nicolaibonde/Boat-autopilot-documentation/README.md

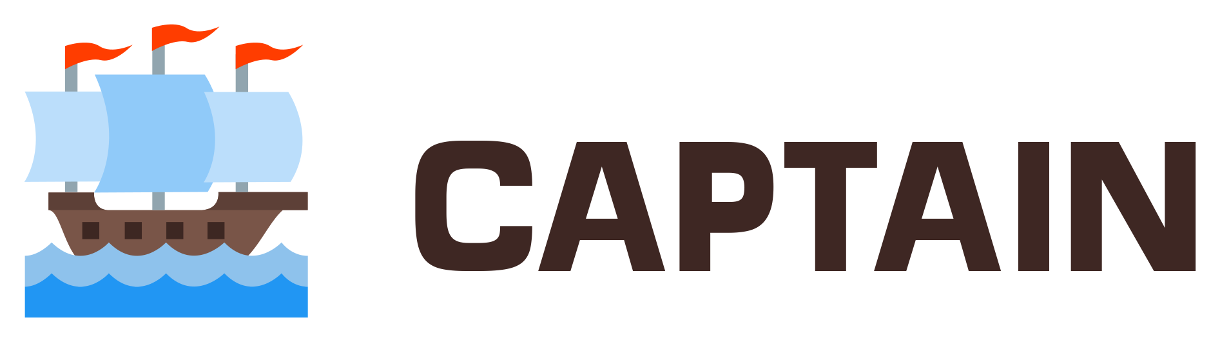
[picture p1: logo - side.png]


This is the documentation for CAPTAIN a boat autopilot and navigation system.

The source code for this project can be found in an [Boat-autopilot](https://github.com/neobonde/Boat-autopilot)

This repository is part of a Bachelors project in electrical engineering at Aarhus University - Department of Engineering

[logo]: https://github.com/neobonde/Boat-autopilot-documentation/blob/master/logo%20-%20side.png "Logo Title Text 2"
