nicolaibonde/Boat-autopilot-documentation/Appendix/Project/README.md

# Boat-autopilot-documentation - Appendix - Project

This includes the following according to "Vejledning til udfærdigelse af projektrapporter - version 1.2":

* Requirementspecification
* Analysis
* Architecture
* Design
* Test
  * Module tests
  * Intergration tests
  * Acceptance test
  
* Datasheets
* PCB Layouts
* Doxygen generated source code documentation
* Source code
* logbook

Some of the documents might not be pressent if we did not use them
