nicolaibonde/Boat-autopilot-documentation/Report/Frontpage.tex

\begin{titlingpage}
%\thispagestyle{title}
\selectlanguage{danish}
		
	\begin{center}
			{\huge\bfseries Bachelor Project - CAPTAIN}\\
			\vspace{20pt}
			{\large Autonomous surveying vessel with autopilot, navigational\\ algorithms, GPS, and website user interface, using C++11, \\ Boost, AngularJS, JavaScript, and with extensive unit testing.}\\
			
			\vfill
			\begin{figure}[H]
				\centering
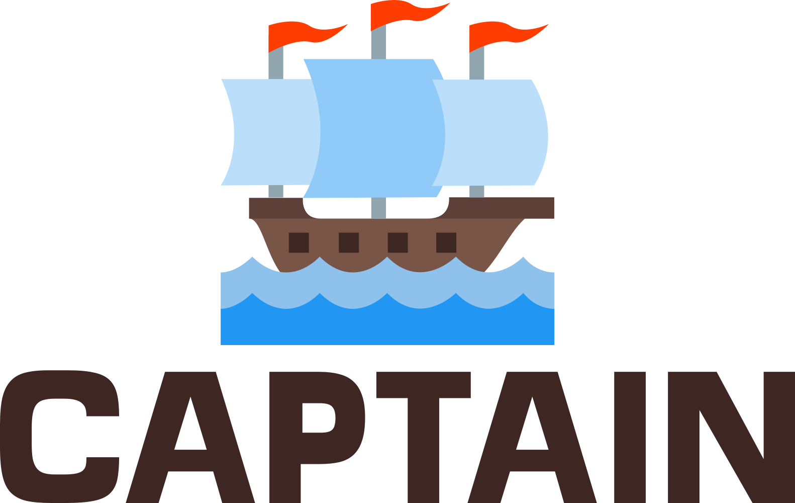
[picture p31: Report/forside.png]
				
			\end{figure}
			
			\vfill
			{\Huge\bfseries Report}\\

			\vspace{20pt}
			
			{Bachelor - Electronics Engineering}\\
			{\large 7. Semester project Fall 2017}\\
			{Group: 17115}\\
			{Keystrokes: 48,522}
			
			\vspace{10pt}
			
			Aarhus University, School of Engineering\\
			Supervisor : Michael Alrøe
			\vspace{10pt}
			
			19. December 2017
	
			\begin{minipage}{0.40\linewidth}
				\centering
							
				\hrule
				\vspace{12pt}
				Nicolai Kaasgaard Bonde\\
				Studienr. 201405146\\
				AU ID: au512366
			\end{minipage}
			\hspace{50pt}
			\begin{minipage}{0.40\linewidth}
				\centering
					
				\hrule
				\vspace{12pt}
				Troels Ringbøl Brahe\\
				Studienr. 20095221\\
				AU ID: au283169
			\end{minipage}
	\end{center}
\end{titlingpage}
