nicolaibonde/Boat-autopilot-documentation/Appendix/Process/process.tex

%%%% Bachelor projekt dokumentation/rapport gruppe x %%%%
%%%% Efterår 2017 %%%%

% Kan anvendes til journaler eller afleveringer
\input{preamble}

\bibliography{../../bibliography.bib}

\begin{document}

	\selectlanguage{english}
	
	\input{frontpage}
	
	\setcounter{tocdepth}{1}
	\begin{KeepFromToc}
		\tableofcontents
	\end{KeepFromToc}\pagebreak

	\input{Preface}
	
	\input{Introduction}
	
	\input{Group_formation}
	
	\input{Cooperation_agreement}
	
	\input{development_process}
	
	\input{Project_management}
	
	\input{Work_distribution}
	
	\input{Planning}

	\input{Project_administration}

	\input{Meetings}
	
	\input{Conflict_handeling}

	\printbibliography[title={Bibliography}]
	
	%\include{<sti/filnavn>}

\end{document}
