nicolaibonde/Boat-autopilot-documentation/Appendix/Process/Project_management.tex

%Her beskrives hvordan projektledelse er anvendt under projektets gennemførelse. Har det være samme person der har været projektleder gennem hele projektforløbet – eller er projektledelse foregået på skift – eller kollektivt? Beskriv også hvis der ikke har været anvendt nogen form for projektledelse. Hvis I har anvendt Scrum kan jeres anvendelse af rollerne Product Owner (PO) og Scrum Master (SM) beskrives her.
\chapter{Project management}
Management of project development was shared between the two group members.

After the initial stages of problem definition, requirements specification, and architecture, the design tasks were broken down and each member started developing more or less independently until next review/completion cycle.

The team figured out which tasks seemed most relevant continually, and delegated the work based mostly on this to ensure that work could progress at a steady pace.
