nicolaibonde/Boat-autopilot-documentation/Appendix/Project/Dokumentation/dokumentation.tex

%%%% Bachelor projekt dokumentation/rapport gruppe x %%%%
%%%% Efterår 2017 %%%%

% Kan anvendes til journaler eller afleveringer
\input{preamble}

\bibliography{../../../bibliography.bib}
\begin{document}

	\selectlanguage{english}
	
	\input{frontpage}
	
	\setcounter{tocdepth}{3}
	\begin{KeepFromToc}
		\tableofcontents
	\end{KeepFromToc}\pagebreak
	
	\input{Introduction}
	
	\newpage
	\input{Requirements_specification}
	
	\newpage
	\input{Acceptance_test}
	
	\input{Analysis}
	
	\newpage	
	\input{System_architecture}
	
	\newpage
	\input{Design_implementation_and_test}
	
	\newpage
	\input{Integrationtest}
	
	\newpage
	\input{Acceptance_test_results}	
	
	\newpage
	
	\printbibliography[title={Bibliography}]
	
	%\include{<sti/filnavn>}

\end{document}
