nicolaibonde/Boat-autopilot-documentation/Appendix/Project/Dokumentation/Images/Design/Motor_config.pdf

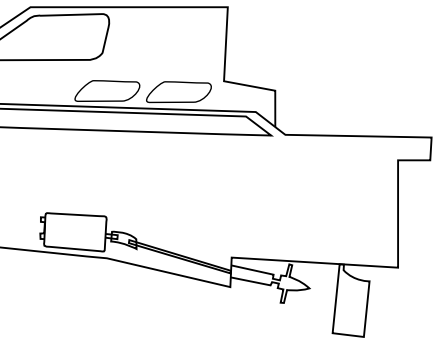
[picture p36: figure]
