nicolaibonde/Boat-autopilot-documentation/Appendix/Project/Dokumentation/Images/Implementation/xte.pdf

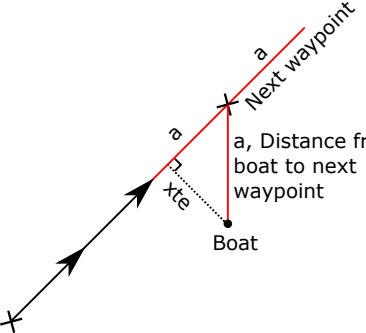
[picture p37: figure]
Boat; xte; boat to next waypoint; Next waypoint

a, Distance from
