nicolaibonde/Boat-autopilot-documentation/Appendix/Project/Dokumentation/forside.png

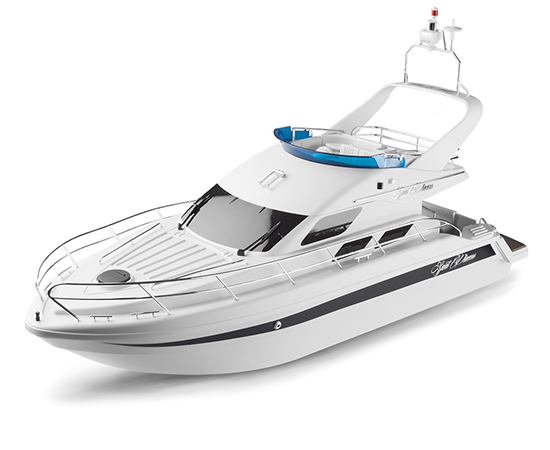
Appendix/Project/Dokumentation/forside.png
