nicolaibonde/Boat-autopilot-documentation/Appendix/Project/Dokumentation/Images/Implementation/boat_harware_enclosed_2.jpg

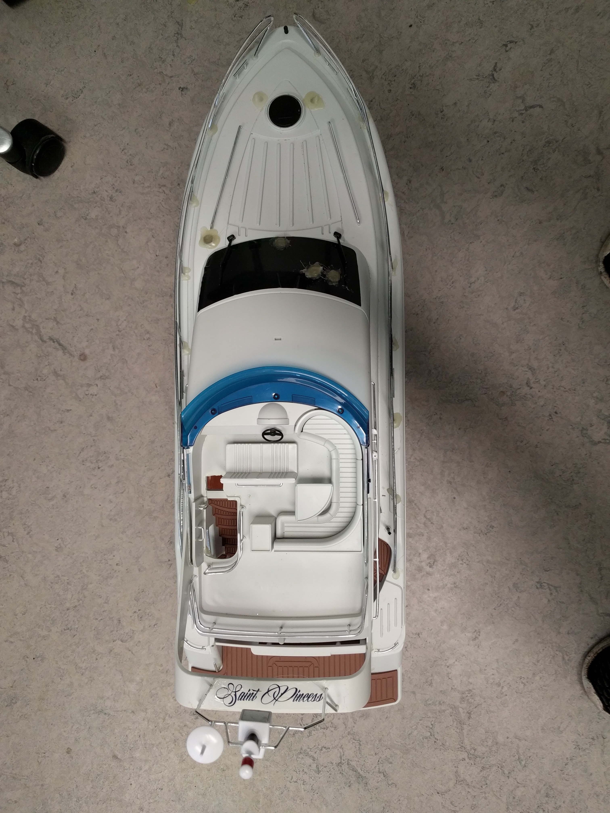
Appendix/Project/Dokumentation/Images/Implementation/boat_harware_enclosed_2.jpg
