nicolaibonde/Boat-autopilot-documentation/Appendix/Project/Dokumentation/Images/Implementation/gps_output_pi.png

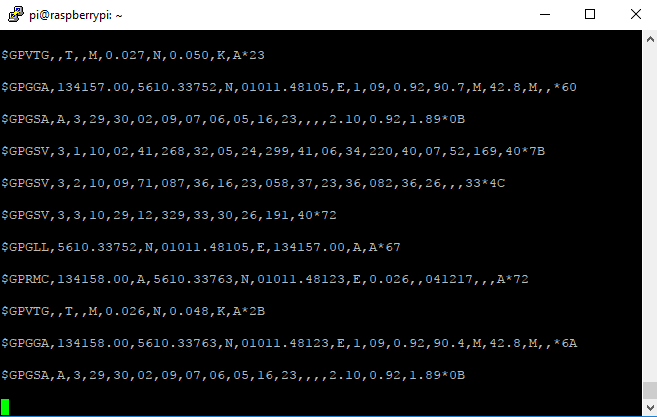
Appendix/Project/Dokumentation/Images/Implementation/gps_output_pi.png
