nicolaibonde/Boat-autopilot-documentation/Appendix/Project/Dokumentation/Images/Implementation/Motor_controller_bow.jpg

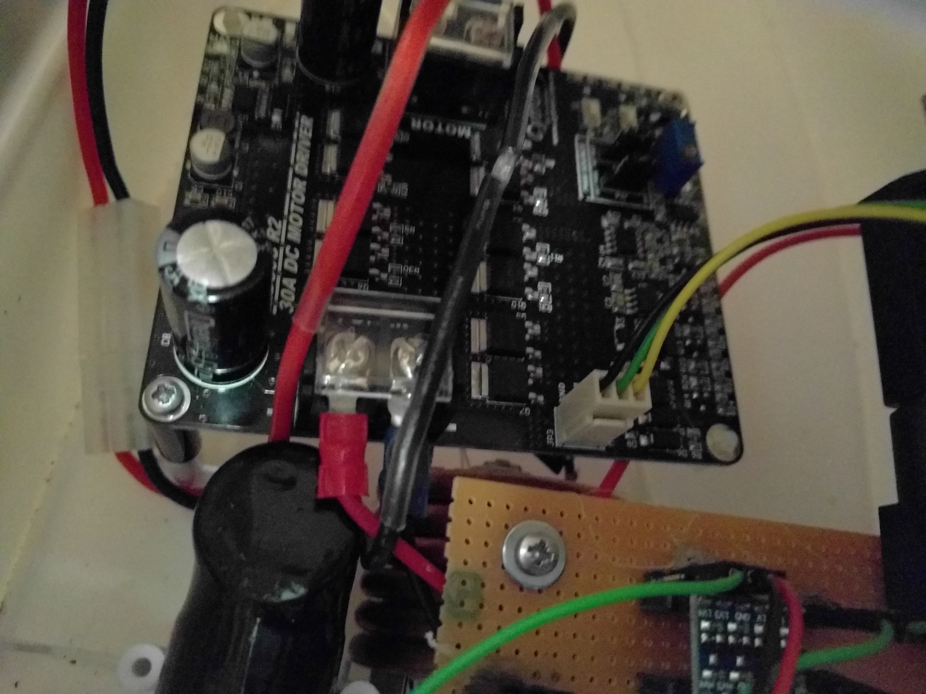
Appendix/Project/Dokumentation/Images/Implementation/Motor_controller_bow.jpg
