nicolaibonde/Boat-autopilot-documentation/Appendix/Project/Dokumentation/Images/Implementation/perfboard_middle.jpg

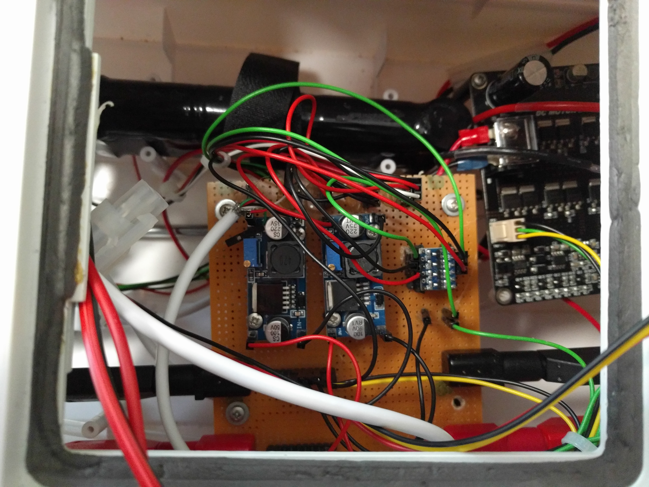
Appendix/Project/Dokumentation/Images/Implementation/perfboard_middle.jpg
