nicolaibonde/Boat-autopilot-documentation/Appendix/Project/Dokumentation/Images/Implementation/Raspberry_pi_stern.jpg

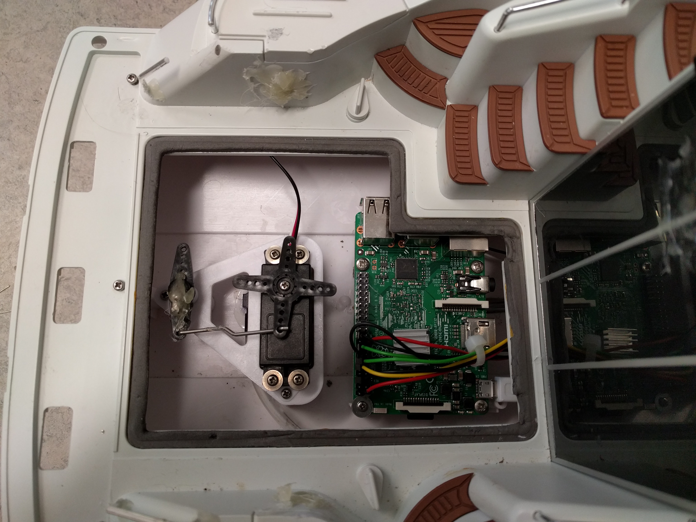
Appendix/Project/Dokumentation/Images/Implementation/Raspberry_pi_stern.jpg
