nicolaibonde/Boat-autopilot-documentation/Appendix/Project/Dokumentation/Images/Implementation/status_page.png

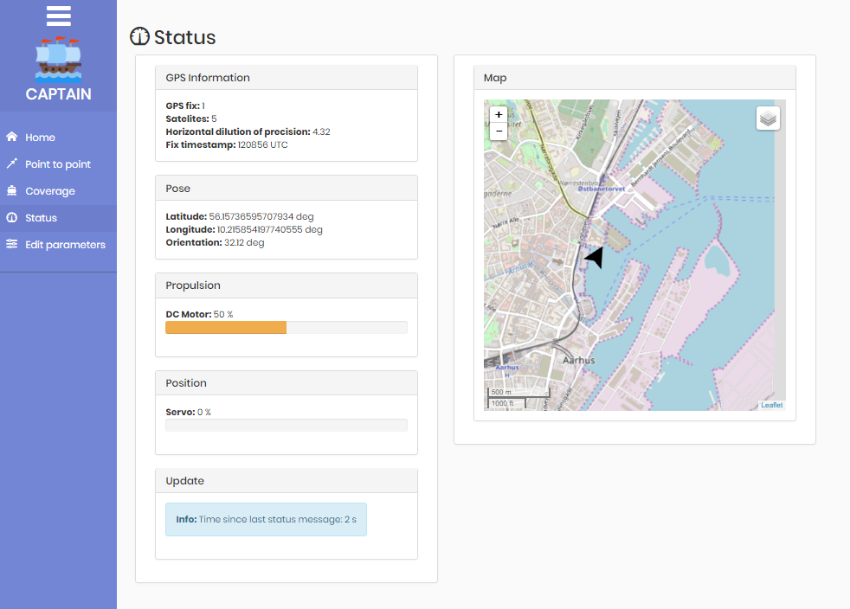
Appendix/Project/Dokumentation/Images/Implementation/status_page.png
