nicolaibonde/Boat-autopilot-documentation/Appendix/Project/Dokumentation/Images/Integration/edit_param.png

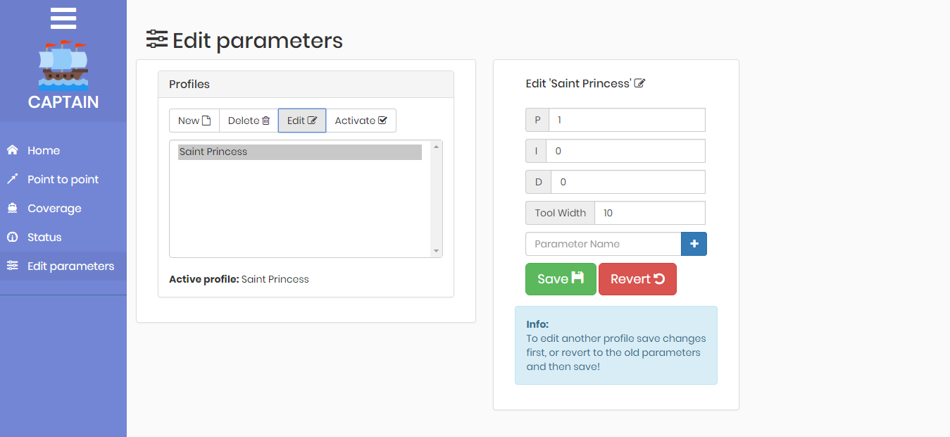
Appendix/Project/Dokumentation/Images/Integration/edit_param.png
