nicolaibonde/Boat-autopilot-documentation/Appendix/Project/Research/HardwareIntegration/both_regulators_on.jpg

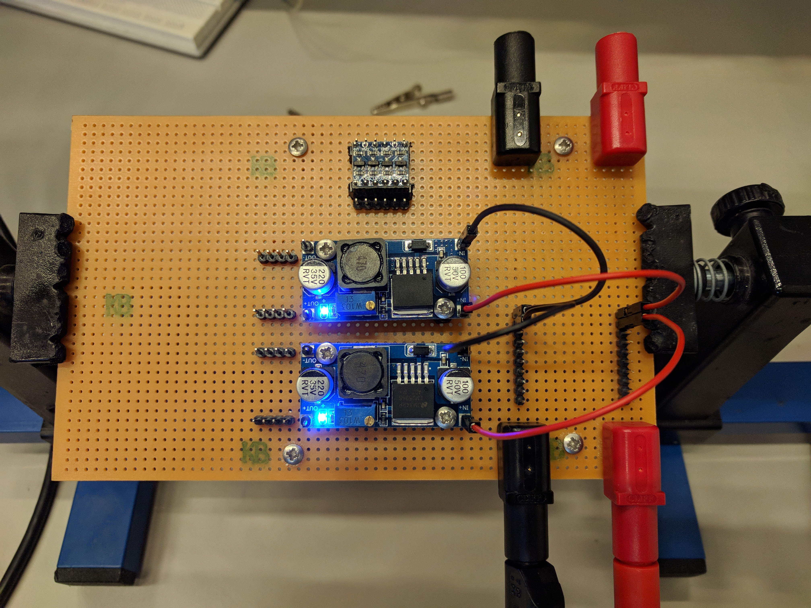
Appendix/Project/Research/HardwareIntegration/both_regulators_on.jpg
