nicolaibonde/Boat-autopilot-documentation/Appendix/Project/Research/HardwareIntegration/full_system_no_load_current.jpg

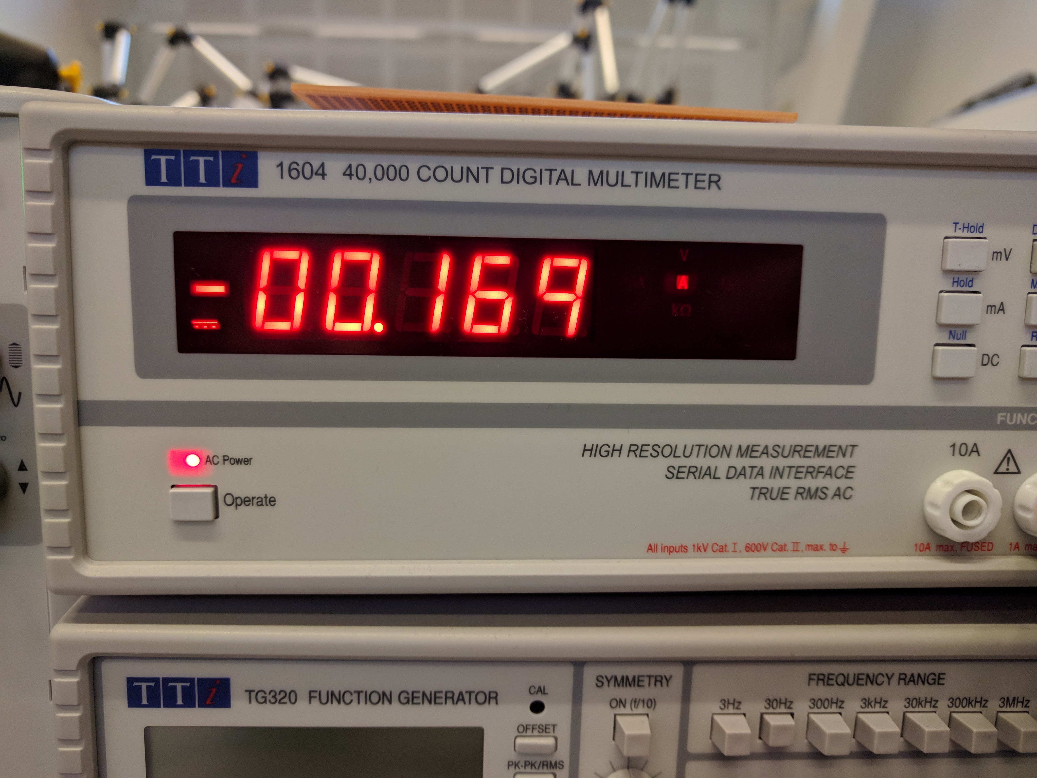
Appendix/Project/Research/HardwareIntegration/full_system_no_load_current.jpg
