nicolaibonde/Boat-autopilot-documentation/Appendix/Project/Research/HardwareIntegration/full_system_no_load_voltage_current.jpg

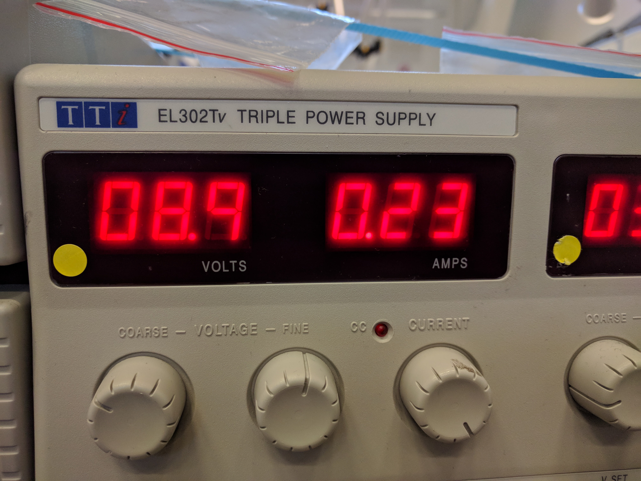
Appendix/Project/Research/HardwareIntegration/full_system_no_load_voltage_current.jpg
