nicolaibonde/Boat-autopilot-documentation/Appendix/Project/Research/HardwareIntegration/motor_contoller_no_load_current.jpg

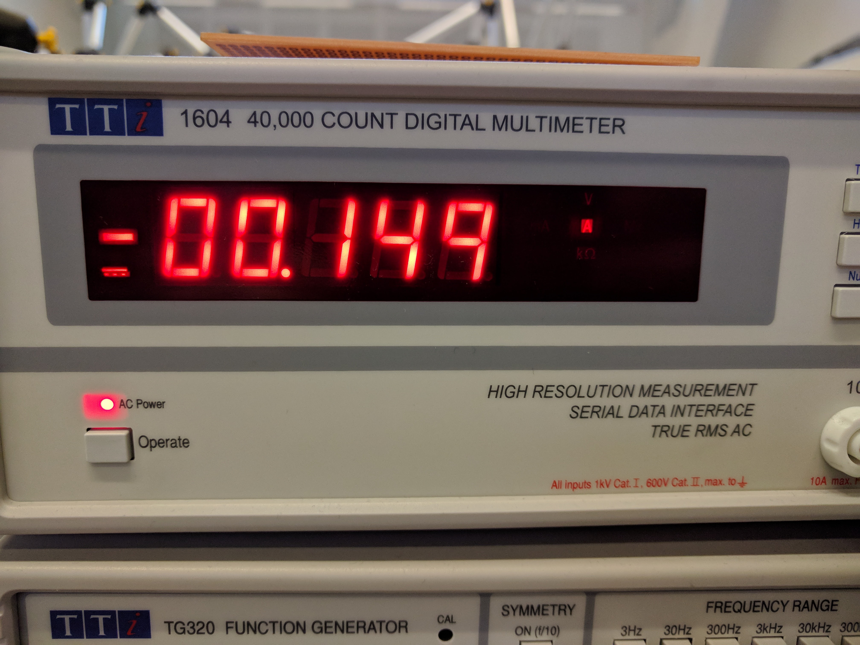
Appendix/Project/Research/HardwareIntegration/motor_contoller_no_load_current.jpg
