nicolaibonde/Boat-autopilot-documentation/Appendix/Project/Research/HardwareIntegration/motor_controller_no_load_10.png

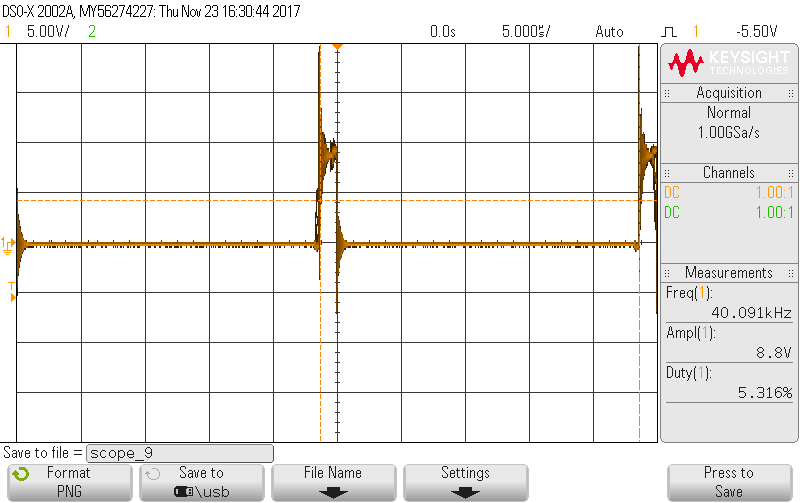
Appendix/Project/Research/HardwareIntegration/motor_controller_no_load_10.png
