nicolaibonde/Boat-autopilot-documentation/Appendix/Project/Research/HardwareIntegration/motor_controller_no_load_90.png

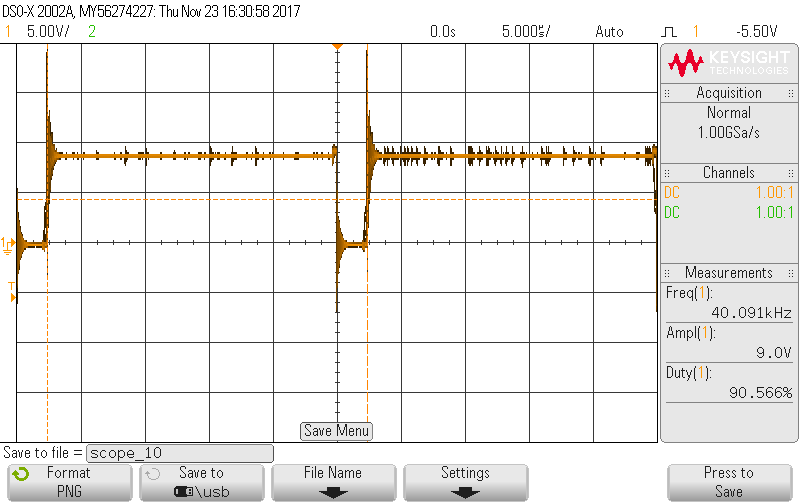
Appendix/Project/Research/HardwareIntegration/motor_controller_no_load_90.png
