nicolaibonde/Boat-autopilot-documentation/Appendix/Project/Research/HardwareIntegration/motor_controller_overshoot_2.png

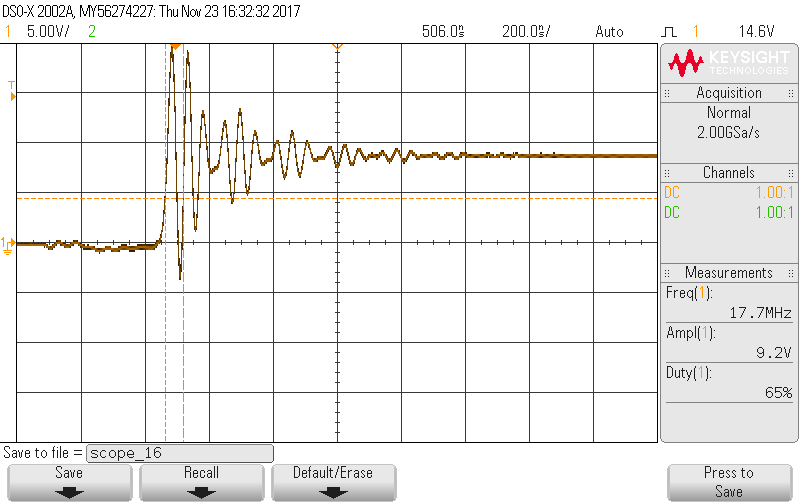
Appendix/Project/Research/HardwareIntegration/motor_controller_overshoot_2.png
