nicolaibonde/Boat-autopilot-documentation/Appendix/Project/Research/HardwareIntegration/motor_controller_pwm_current_draw.jpg

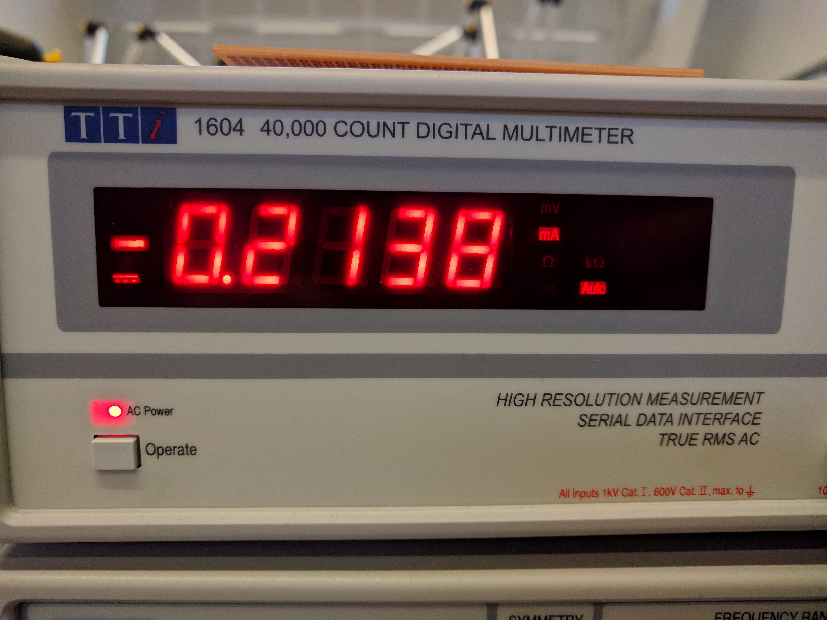
Appendix/Project/Research/HardwareIntegration/motor_controller_pwm_current_draw.jpg
