nicolaibonde/Boat-autopilot-documentation/Appendix/Project/Research/HardwareIntegration/regulator_5v_off.png

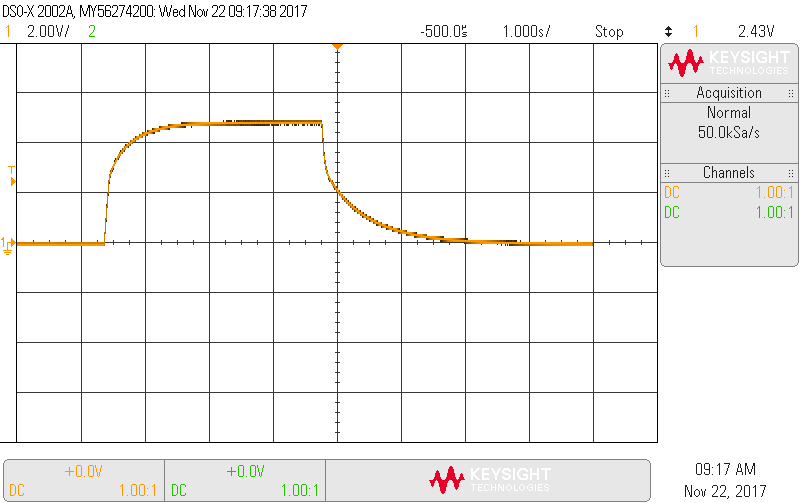
Appendix/Project/Research/HardwareIntegration/regulator_5v_off.png
