nicolaibonde/Boat-autopilot-documentation/Appendix/Project/Research/HardwareIntegration/regulator_5v_off_2.png

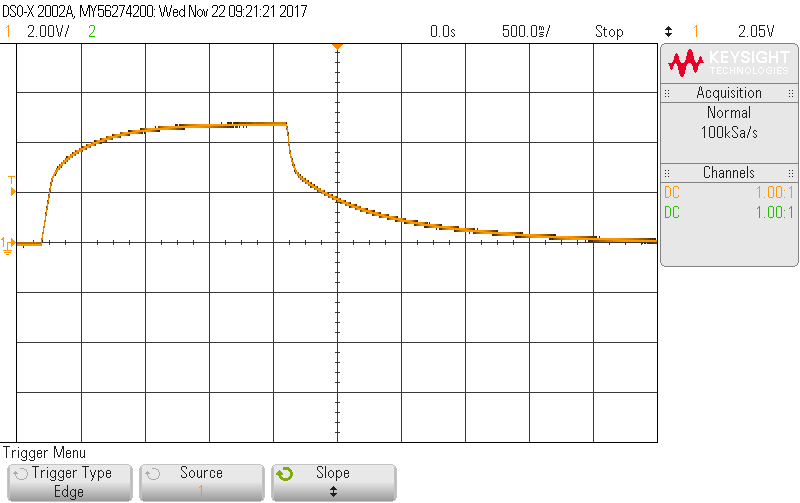
Appendix/Project/Research/HardwareIntegration/regulator_5v_off_2.png
