nicolaibonde/Boat-autopilot-documentation/Appendix/Project/Research/HardwareIntegration/regulator_5v_on.png

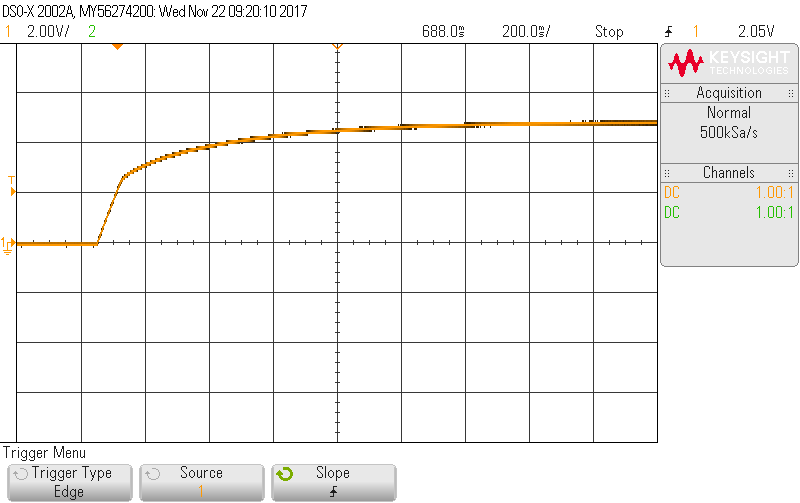
Appendix/Project/Research/HardwareIntegration/regulator_5v_on.png
