nicolaibonde/Boat-autopilot-documentation/Appendix/Project/Research/HardwareIntegration/regulator_both_current_draw.jpg

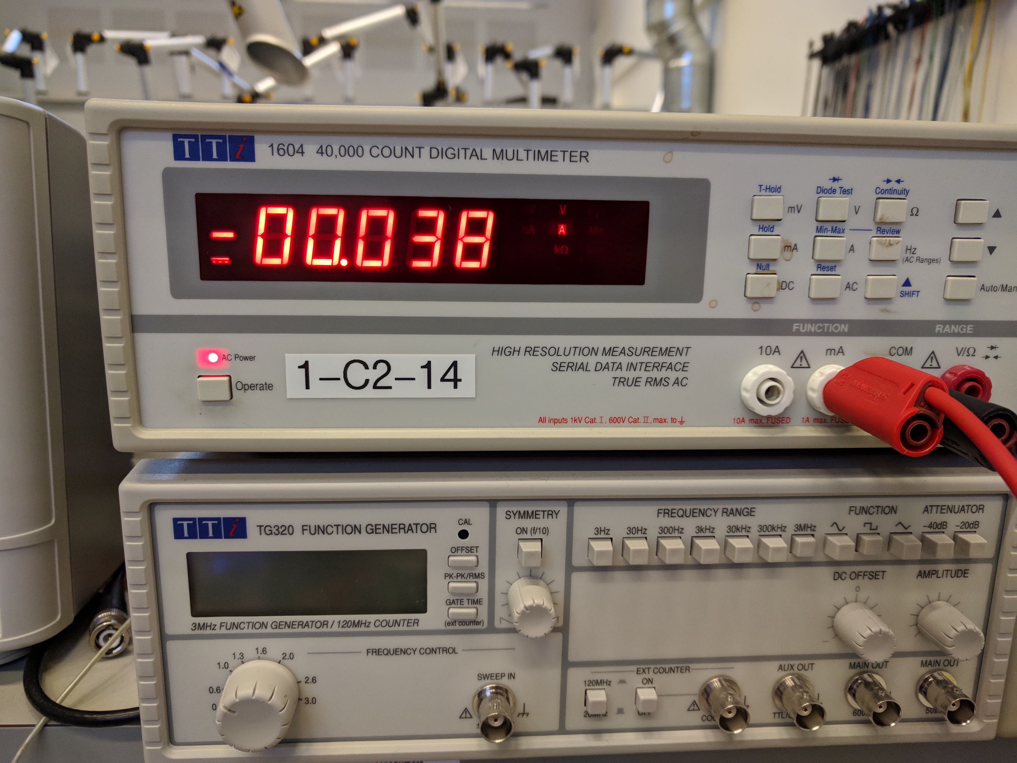
Appendix/Project/Research/HardwareIntegration/regulator_both_current_draw.jpg
