nicolaibonde/Boat-autopilot-documentation/Appendix/Project/Research/HardwareIntegration/regulator_voltage_current_input.jpg

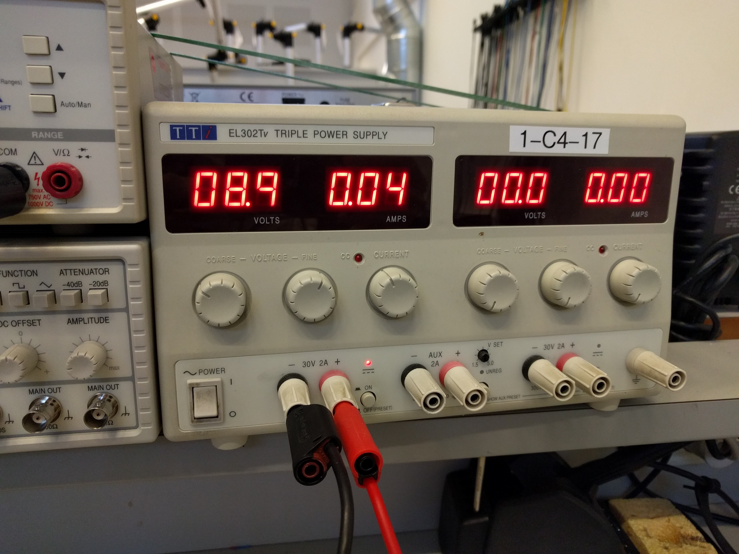
Appendix/Project/Research/HardwareIntegration/regulator_voltage_current_input.jpg
