nicolaibonde/Boat-autopilot-documentation/Appendix/Project/Research/HardwareIntegration/scope_13.png

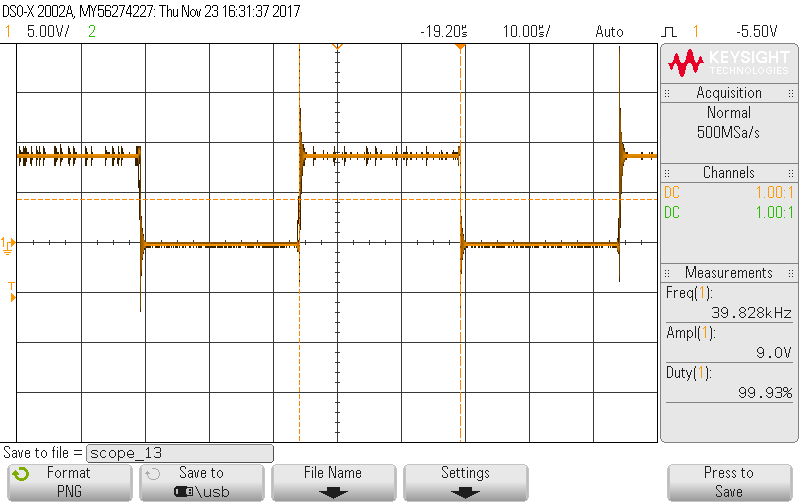
Appendix/Project/Research/HardwareIntegration/scope_13.png
