nicolaibonde/Boat-autopilot-documentation/Appendix/Project/Research/Board_candidates/Board_candidates.xlsx

 |  | Weights: -> | 3 | 2 | 5 | 3 | 3 | 2 | 4 | 2 | 1 | 5 | 1 | 4
Names | Score | Processor | Price (DKK) | RAM | RTOS | WiFi module | UART | SPI | PWM | I2C | Supply | Ethernet port | GPIO | SupportLvl | Ref
Raspberry Pi 3b | 161.969697 | 1.2 GHz BCM2837 | 220 | 2048 | Yes | Yes | Yes | Yes | Yes | Yes | 5 | Yes | 40 | 5 | https://www.raspberrypi.org/
PineA64+ | 150.9166667 | 1.2 GHz ARM A53 | 180 | 2048 | Yes | Yes | Yes | Yes | Yes | Yes | 5 | Yes | 20 | 2 | https://www.pine64.org/?page_id=1194
Asus Tinker Board | 150.9015152 | 1.8 GHz ARM A17 | 440 | 2048 | Yes | Yes | Yes | Yes | Yes | Yes | 5 | Yes | 40 | 3 | https://www.asus.com/uk/Single-Board-Computer/Tinker-Board/specifications/
BeagleBone Black w | 147.7442529 | 1 GHz ARM A8 | 580 | 512 | Yes | Yes | Yes | Yes | Yes | Yes | 5 | Yes | 92 | 4 | https://beagleboard.org/black-wireless
NanoPC-T3 | 147.4821429 | 1.4 GHz ARM A53 | 350 | 2048 | Yes | Yes | Yes | Yes | Yes | Yes | 5 | Yes | 30 | 2 | http://www.friendlyarm.com/index.php?route=product/product&product_id=123
OrangePi Plus 2 | 144.3333333 | 1.6 GHz ARM A7 | 300 | 2048 | Yes | Yes | Yes | Yes | Yes | Yes | 5 | Yes | 40 | 1 | http://www.orangepi.org/orangepiplus2/
Raspberry Pi Zero w | 143.3333333 | 1 GHz BCM2835 | 90 | 512 | Yes | Yes | Yes | Yes | Yes | Yes | 5 | No | 40 | 5 | https://www.raspberrypi.org/
Banana Pi | 141.5 | 1.8 GHz ARM A7-A83T | 810 | 2048 | Yes | Yes | Yes | Yes | Yes | Yes | 5 | Yes | 40 | 1 | http://www.banana-pi.org/m3.html
Udoo Quad | 141.1904762 | 1 GHz NXP i.MX6Q + Atmel SAM3X8E | 840 | 1024 | Yes | Yes | Yes | Yes | Yes | Yes | 5 | Yes | 76 | 2 | https://shop.udoo.org/eu/quad-dual/udoo-quad.html
BeagleBoard X15 | 140.9060403 | 1.5 GHz ARM A15 | 1490 | 2048 | Yes | No | Yes | Yes | Yes | Yes | 12 | Yes | 240 | 4 | https://beagleboard.org/x15
NanoPi 2 Fire | 136.4761905 | 1.4 GHz ARM A9 | 140 | 1024 | Yes | No | Yes | Yes | Yes | Yes | 5 | Yes | 40 | 2 | http://nanopi.io/nanopi2-fire.html
Intel Edison | 129.8267544 | 0.5 GHz Intel Atom | 570 | 1024 | Yes | Yes | Yes | Yes | Yes | Yes | 5 | No | 70 | 4 | https://software.intel.com/en-us/iot/hardware/edison/documentation
C.H.I.P. Pro | 127.1673387 | 1 GHz ARM V7-A | 310 | 256 | Yes | Yes | Yes | Yes | Yes | Yes | 5 | No | 27 | 4 | https://docs.getchip.com/chip_pro_devkit.html
Odroid C2 | 112.4885057 | 1.5 GHz ARM V8 | 290 | 2048 | Yes | No | Yes | No | No | Yes | 5 | Yes | 40 | 2 | http://www.hardkernel.com/main/products/prdt_info.php?g_code=G145457216438&tab_idx=2
Parallella | 112.35 | 0.8 GHz ARM A9 | 1000 | 1024 | Yes | No | Yes | Yes | ? | Yes | 5 | Yes | 48 | 2 | https://www.parallella.org/docs/parallella_manual.pdf
PixiePro | 104.875 | 1 GHz .iMX6Q + ARM A9 | 810 | 2048 | Yes | Yes | Yes | Yes | ? | Yes | 5 | No | 10 | 1 | https://store.treats4geeks.com/index.php/pixiepro-27.html
