nicolaibonde/Boat-autopilot-documentation/Appendix/Project/Research/HardwareIntegration/motor_contoller_no_load_setup_1.jpg

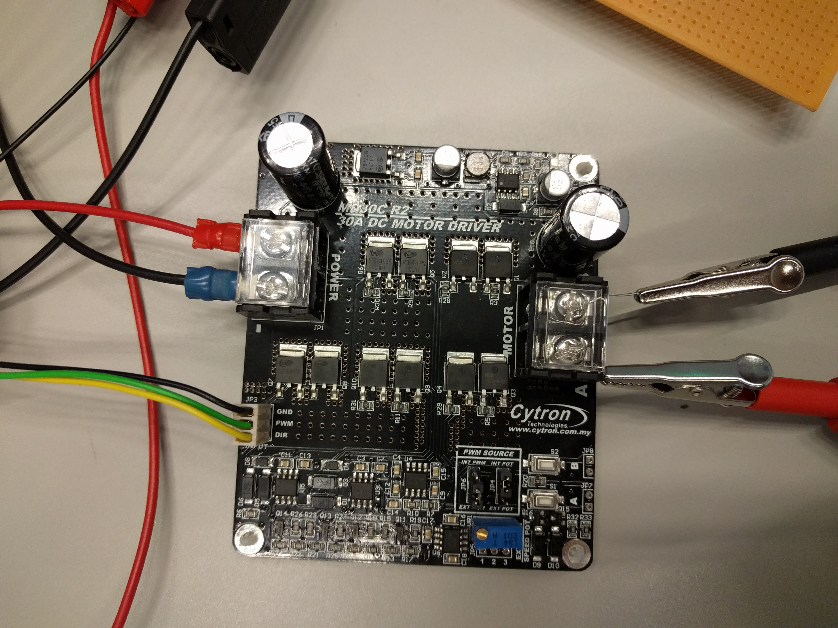
Appendix/Project/Research/HardwareIntegration/motor_contoller_no_load_setup_1.jpg
