nicolaibonde/Boat-autopilot-documentation/Appendix/Project/Research/HardwareIntegration/regulate_voltage_setup_2.jpg

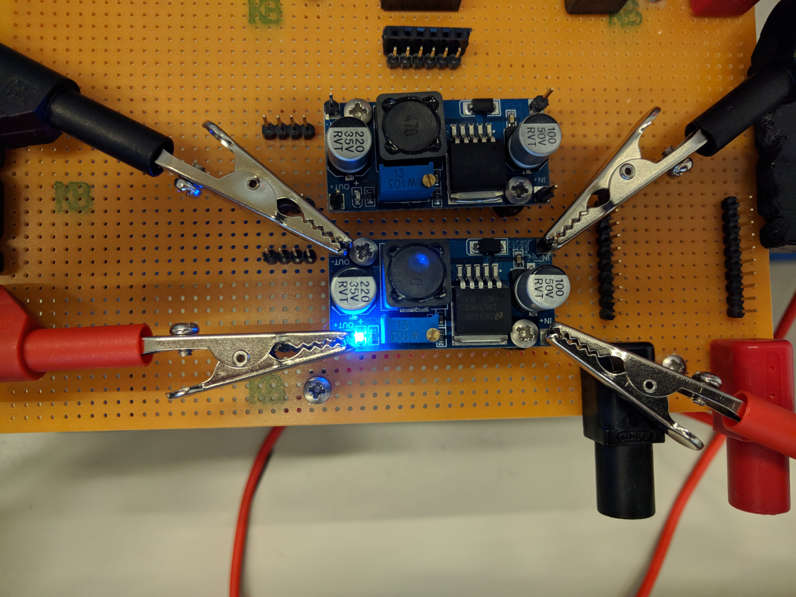
Appendix/Project/Research/HardwareIntegration/regulate_voltage_setup_2.jpg
