nicolaibonde/Boat-autopilot-documentation/Appendix/Project/Research/HardwareIntegration/regulate_voltage_setup_full.jpg

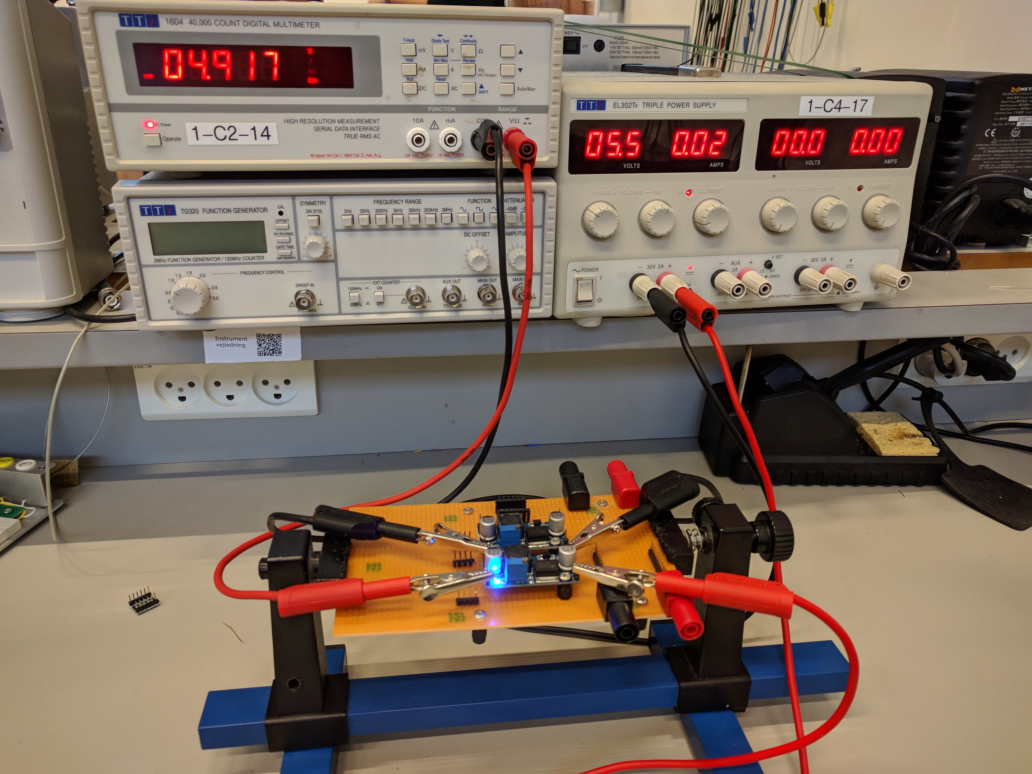
Appendix/Project/Research/HardwareIntegration/regulate_voltage_setup_full.jpg
