nicolaibonde/Boat-autopilot-documentation/Appendix/Project/Research/HardwareIntegration/regulate_votage_setup_1.jpg

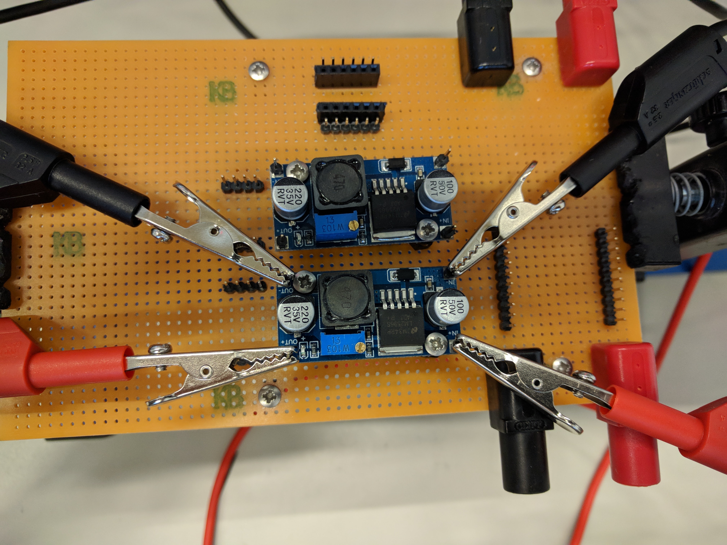
Appendix/Project/Research/HardwareIntegration/regulate_votage_setup_1.jpg
