nicolaibonde/Boat-autopilot-documentation/Appendix/Project/Research/Acceptance_Test_Results/Accepttest_results.xlsx

UC1
Main scenario
1 | Passed | A new profile has been added to the profile list with the name "New Profile". The button is called "New"
UC2
Main scenario
1 | Passed | The selected parameter profile is highlighted
2 | Passed | The selected parameter profile is deleted from the list of profiles. The button is called "Delete"
Active profile deleted
1 | Passed | The selected parameter profile is highlighted
2 | Passed | The selected parameter profile appears in the "Active profile" field under the profile list.
3 | Passed | The selected parameter profile is removed from the profile list, and the "Active profile" shows "None"
UC3
Main scenario
1 | Passed | The selected parameter profile is highlighted
2 | Passed | The selected parameter profile's edit section appears
3 | Passed | The new values correspond to the changes made
4 | Passed | The edit section disappears, and the new values are (presumably) saved
Revert
1 | Passed | The selected parameter profile is highlighted
2 | Passed | The selected parameter profile's edit section appears
3 | Passed | The new values correspond to the changes made
4 | Passed | The values have been reverted to the values they had when the edit section was opened
UC4
Main scenario
1 | Passed | The selected parameter profile is highlighted
2 | Passed | The selected parameter profile appears in the "Active profile" field under the profile list.
UC5
Main scenario
1 | Passed | The menu opens and displays the diagnostics data. The menu is called "Status"
UC6
Main scenario
1 | Passed | A marker appears on the map on the clicked area, and the Latitude and Longitude fields are updated
Coordinate input
1 | Passed | A marker appears on the map on the clicked area, and the Latitude and Longitude fields are updated
UC7
Main scenario
1 | Passed | A marker appears on the map on the clicked area, and the Latitude and Longitude fields are updated
2 | Passed | The button changes to "Calculating..." for a while, then a path is drawn on the map, and the button changes to "Start"
UC8
Main scenario
1 | Passed | A marker appears on the map on the clicked area, and the Latitude and Longitude fields are updated
2 | Passed | The button changes to "Calculating..." for a while, then a path is drawn on the map, and the button changes to "Start"
3 | Passed | The button changes to "Running..." while the path is being traversed, and ETA is updated continually along with the boat's position. The button changes to "Calculate path" when the path has been completed
UC9
Main scenario
1 | Passed | A marker appears on the map on the clicked area, and the Latitude and Longitude fields are updated
2 | Passed | The button changes to "Calculating..." for a while, then a path is drawn on the map, and the button changes to "Start"
3 | Passed | The button changes to "Running..." while the path is being traversed, and ETA is updated continually along with the boat's position
4 | Passed | The button changes to "Calculate path" when stop is pressed, and the motors are stopped. Progress bar turns red, and "Cancelled" is displayed.
UC10
Main scenario
1 | Passed | A marker labeled "1" appears on the map on the clicked area, and the Latitude and Longitude fields are updated
2 | Passed | A marker labeled "2" appears on the map on the clicked area, and the Latitude and Longitude fields are updated
Coordinate input
1 | Passed | A marker labeled "1" appears on the map on the clicked area, and the Latitude and Longitude fields are updated
2 | Passed | A marker labeled "2" appears on the map on the clicked area, and the Latitude and Longitude fields are updated
UC11
Main scenario
1 | Passed | A marker labeled "1" appears on the map on the clicked area, and the Latitude and Longitude fields are updated
2 | Passed | A marker labeled "2" appears on the map on the clicked area, and the Latitude and Longitude fields are updated
3 | Passed | The button changes to "Calculating..." for a while, then a path is drawn on the map, and the button changes to "Start". The coverage area is highlighted in an orange color
UC12
Main scenario
1 | Passed | A marker labeled "1" appears on the map on the clicked area, and the Latitude and Longitude fields are updated
2 | Passed | A marker labeled "2" appears on the map on the clicked area, and the Latitude and Longitude fields are updated
3 | Passed | The button changes to "Calculating..." for a while, then a path is drawn on the map, and the button changes to "Start". The coverage area is highlighted in an orange color
4 | Passed | The button changes to "Running..." while the path is being traversed, and ETA is updated continually along with the boat's position. The button changes to "Calculate path" when the path has been completed
UC13
Main scenario
1 | Passed | A marker labeled "1" appears on the map on the clicked area, and the Latitude and Longitude fields are updated
2 | Passed | A marker labeled "2" appears on the map on the clicked area, and the Latitude and Longitude fields are updated
3 | Passed | The button changes to "Calculating..." for a while, then a path is drawn on the map, and the button changes to "Start". The coverage area is highlighted in an orange color
4 | Passed | The button changes to "Running..." while the path is being traversed, and ETA is updated continually along with the boat's position
5 | Passed | The button changes to "Calculate path" when stop is pressed, and the motors are stopped. Progress bar turns red, and "Cancelled" is displayed.
