nicolaibonde/Boat-autopilot-documentation/Appendix/Project/Dokumentation/Design_implementation_and_test.tex

\chapter{Design, implementation, and test}
\label{sec:implementation}

The following sections describe the system design, how it was implemented, and finally how it was tested. First, the protocols used in the system are explained. Then the hardware is discussed, and finally the software.

\input{Design_implementation_test/protocols.tex}

\input{Design_implementation_test/hardware_design.tex}

\input{Design_implementation_test/hardware_moduletest.tex}

\input{Design_implementation_test/software_design.tex}

\input{Design_implementation_test/software_implementation.tex}

\input{Design_implementation_test/software_unittest.tex}

\input{Design_implementation_test/software_integrationtest.tex}
