nicolaibonde/Boat-autopilot-documentation/Appendix/Project/Dokumentation/Design_implementation_test/protocols.tex

\section{Protocols}
\label{sec:protocols}
This section describes the various protocols used throughout the system. The protocol between server and client is a proprietary protocol defined for this project, it is based on JavaScript Object Notation (JSON) \cite{jsobjectnotation}. The protocol between the system and a GPS receiver is the NMEA 0183 version 2 protocol, the section describes the parts of the protocol that the system is using, but the protocol it self is much bigger. 

\subsection{Communication between server and client}

The server and client communicate using three .json files; toNav.json, fromNav.json, and activeParam.json. As the names suggest, one is used to send data from the client to the server (and from there to the navigation module), and one is used to send data from the server to the client, The last is used to transfer parameters specific to the hardware. The contents of these three files is critical for both sides of the system to function properly, so having a standard format in each one is important. 

\subsubsection{toNav.json}

The file used to transfer data from the client to the server is used to send commands to the navigation module. This could be calculating a new coverage path for an area, telling the boat to stop, or setting the endpoint in the point to point page.
The protocol is based on JSON so any kind of data can be contained within.

\begin{lstlisting}[caption = {Example of the least information in the toNav.json file}, captionpos=b, label={lst:toNavBasic}, language=json,firstnumber=1]
{
	"func_": "none"
}
\end{lstlisting}

The example shown in listing \ref{lst:toNavBasic} demonstrates the least amount of information that can be contained in the toNav.json file. The \texttt{func_} name can hold a string, which is expected to be one of some predefined functions. In the example the string is \texttt{none}.
The functions that can be input are; \texttt{none}, \texttt{calcP2P}, \texttt{calcCoverage}, \texttt{start}, and \texttt{stop}.
If one wants to send a \texttt{calcP2P} it is required that the writer adds a container for a coordinate \texttt{target_position_} as in listing \ref{lst:toNavCalcP2P}. A coordinate is made up of two numbers; one called \texttt{latitude_} and one called \texttt{longitude_}

\newpage

\begin{lstlisting}[caption = {Example of a calcP2P call in the toNav.json}, captionpos=b, label={lst:toNavCalcP2P}, language=json,firstnumber=1]
{
	"func_": "calcP2P",
	"target_position_": {
		"latitude_":56.187317092640775,
		"longitude_":10.18372267484665
	}
}
\end{lstlisting}

the \texttt{calcCoverage} function requires two coordinates that describe a rectangle, and they are given in the format of a \texttt{coverage_rectangle_}, which contains a \texttt{start_coord_} and a \texttt{end_coord_}. These are coordinates as in \texttt{calcP2P}. An example of this can be seen in listing \ref{lst:toNavCalcCoverage}.

\begin{lstlisting}[caption = {Example of a calcCoverage call in the toNav.JSON}, captionpos=b, label={lst:toNavCalcCoverage}, language=json,firstnumber=1]
{
	"func_": "calcCoverage",
	"coverage_rectangle_": {
		"start_coord_": {
			"latitude_": 56.17261819336624,
			"longitude_": 10.191444754600525
		},
		"end_coord": {
			"latitude_": 56.17248978086438,
			"longitude_": 10.191691517829895
		}
	}
}
\end{lstlisting}

\subsubsection{fromNav.json}
\label{sec:protocol_fromNav}
This file is used to transfer data from the server to the client, it could be results from the navigation menu or the information for a status panel. 
The protocol is based on JSON so any kind of data can be contained within. The protocol is build up of objects;  \texttt{Completed_path_}, \texttt{Path_}, \texttt{Progress_}, \texttt{Status}, \texttt{Telemetry_}, and \texttt{Timestamp_}.

A \texttt{Completed_path_}, is used to communicate where the boat has been since it began running its path. It contains a list called \texttt{line_} which is build up of coordinates.
The line list should be appended to every time the controller samples a new position. An example of the \texttt{Completed_path_} object can be seen in listing \ref{lst:fromNavCompletedPath}

\begin{lstlisting}[caption = {Example of a Completed_path_ object in fromNav.json}, captionpos=b, label={lst:fromNavCompletedPath}, language=json,firstnumber=1]
"Completed_path_" : {
		"line_": [
         {
             "latitude_": 56.17594780945529,
             "longitude_": 10.198659896850586
         },
         {
             "latitude_": 56.175900032253004,
             "longitude_": 10.199346542358398
         }
     ]
}
\end{lstlisting}

\texttt{Path_} is an object that contains the desired path, i.e. the path that the controller calculates before running. It like the \texttt{Completed_Path_} contains a list called \texttt{line_} is constructed of coordinates. \texttt{Path_} also contains a string object \texttt{timestamp_} which is used to differentiate between a new path object and one that has already been read, therefore it should only be updated when a new path has been calculated. An example can be found in listing \ref{lst:fromNavPath}

\begin{lstlisting}[caption = {Example of a Path_ object in fromNav.json}, captionpos=b, label={lst:fromNavPath}, language=json,firstnumber=1]
"Path_": {
  "line_": [
      {
          "latitude_": 56.17594780945529,
          "longitude_": 10.198659896850586
      },
      {
          "latitude_": 56.175900032253004,
          "longitude_": 10.199346542358398
      }
  ],
  "timestamp_": 1508137484027
}
\end{lstlisting}

To track the progress of the executing path, there is the \texttt{Progress_} object as seen in listing \ref{lst:fromNavProgress}.
Progress contains a string object \texttt{ete_} containing the calculated estimated time en route, as a string. It also contains a \texttt{percentage_} a number that contains how far along the path it is in percentage. It can be any number but if it is greater then or equal 100 it should be interpreted as a completed path.

\begin{lstlisting}[caption = {Example of a Progress_ object in fromNav.json}, captionpos=b, label={lst:fromNavProgress}, language=json,firstnumber=1]
"Progress_": {
 "ete_": "2 min 56 sec",
 "percentage_": 74
}
\end{lstlisting}

\texttt{Status_} is a list that can contain a status object, an empty \texttt{Status_} can be seen in listing \ref{lst:fromNavStatus}.

\newpage

\begin{lstlisting}[caption = {Example of a empty Status_ object in fromNav.json}, captionpos=b, label={lst:fromNavStatus}, language=json,firstnumber=1]
"Status_": [

]
\end{lstlisting}

The \texttt{Status_} list can contains any status from anything, as long as it follows the example in listing \ref{lst:fromNavStatusItem}, which says that a status has to contains a list \texttt{items_}. This list contains \texttt{data_} a number, \texttt{title_} which is a string, \texttt{unit_} again a string, and it can also optionally contain a \texttt{color_}, this has to be defined as a bootstrap progress-bar style.

\begin{lstlisting}[caption = {Example of an object in Status_ in fromNav.JSON}, captionpos=b, label={lst:fromNavStatusItem}, language=json,firstnumber=1]
{
    "items_": [
        {
            "data_": 5,
            "title_": "WiFi latency",
            "unit_": "ms"
        },
        {
            "color_": "progress-bar-danger",
            "data_": 12,
            "title_": "Packet loss",
            "unit_": "%"
        }
    ],
    "title_": "WiFi Connection"
},
\end{lstlisting}

\texttt{Telemetry_} is the boats current position and orientation described as a \texttt{latitude_}, \texttt{longitude_} and \texttt{orientation_}, which can be seen in listing \ref{lst:fromNavTelemetry}

\begin{lstlisting}[caption = {Example of an Telemetry_ object in fromNav.json}, captionpos=b, label={lst:fromNavTelemetry}, language=json,firstnumber=1]
"Telemetry_": {
    "latitude_": 56.172425,
    "longitude_": 10.19155,
    "orientation_": 110
},
\end{lstlisting}

\texttt{Timestamp_} is simply the time-stamp of when the fromNav.json file was updated last. see listing \ref{lst:fromNavTimestamp} 

\begin{lstlisting}[caption = {Example of an Timestamp_ object in fromNav.json}, captionpos=b, label={lst:fromNavTimestamp}, language=json,firstnumber=1]
"Timestamp_": 1506329007721
\end{lstlisting}

\subsubsection{activeParam.json}
\label{sec:active_param}
When communicating what the P, I, and D parts of a PID loop should be, it is passed through the activeParam.json file from the user interface to the navigation module. activeParam.json has to have a \texttt{name_} and can also have a \texttt{creation_timestamp_} to differentiate if there exists two with the same name. the parameters are grouped in two lists \texttt{parameter_names_} and \texttt{parameters_} these list can contain what ever parameters are wanted, it is up to the parsing module to pick out the parameters it needs.\\
\texttt{parameter_names_} and \texttt{parameters_} should always be the same length, since the data is paired.
An example can be seen in listing \ref{lst:activeParam}.
\begin{lstlisting}[caption = {Example of activeParam.json}, captionpos=b, label={lst:activeParam}, language=json,firstnumber=1]
{
	"name_": "Saint Princess",
	"parameter_names_": ["P", "I", "D", "Tool Width"],
	"parameters_": [10, 5, 1, 10],
	"creation_timestamp_": 1507201741743
}
\end{lstlisting}

\subsection{NMEA 0183 version 2}
The NMEA 0183 version 2 protocol is a serial protocol defined by the National Marine Electronics Association \cite{NMEA}. 
The protocol is serial EIA-422 protocol, and has a bit-rate of 4800 b/s. The protocol is defined by sentences which are ASCII strings with up to 80 characters in each, if more characters are needed then there will be sent more sentences. 

A sentence is defined to start with a \$ and ends with a carriage return and line feed.There can be alot of variables in a sentence, all of which are separated by commas. After the \$ the talker identifier is described this can be a variety of things, for a GPS this is GP, after the talker identifier, there is a sentence identifier. There are many sentence identifiers, but the once that will be discussed are the GGA, VTG and APB, since they are used in this system. The different sentence identifiers define what variables that there are in a sentence, after these variables there is a * which defines the start of the checksum.

The checksum is an XOR of all the characters in the sentence excluding; \$, *, and the checksum itself. The checksum is a 2 character long hex number.

An example of a sentence can be seen in example \ref{ex:gga}
\begin{ex}
\texttt{\$GPGGA,123519,4807.038,N,01131.000,E,1,08,0.9,545.4,M,46.9,M,,*47}
\label{ex:gga}
\end{ex}

\subsubsection{GGA}
Global Positioning System Fix Data. Time, Position and fix related data for a GPS receiver. This is the definition of the GGA sentence in the NMEA 0183 standard. An example GGA sentences can be seen in example \ref{ex:gga}.

\noindent A GGA sentence is built up of 14 variables in this order:
\begin{description}
\item[Fix time] the last time the fix was updated
\item[Latitude] is one component of the position
\item[North or South] the latitude hemisphere
\item[Longitude] is the other component of the position
\item[East or West] the longitude hemisphere
\item[Fix] is the GPS quality indicator
\begin{description}
\item[0] invalid GPS connection
\item[1] Standard precision
\end{description}
\item[Satellites] is the number of satellites in view, up to 12
\item[HDOP] horizontal dilution of precision
\item[Altitude] above mean sea level.
\item[Unit of altitude]
\item[Height] of geoid above WGS84 ellipsoid
\item[Unit of height]
\item[Time] in seconds since last DGPS update
\item[DGPS] station ID number
\end{description}

This sentence is used to get the position of a GPS receiver and to know how good the precision of the data is. 

\subsubsection{VTG}
Track Made Good and Ground Speed, is the NMEA 0183 sentence for getting the ground speed and track of a GPS receiver.
It is build up of these 8 variables:
\begin{description}
\item[Track Degrees] The true track of the GPS receiver 
\item[T] specifies that the track is true
\item[Track Degrees] The magnetic track of the GPS receiver
\item[M] specifies that the track is magnetic
\item[Speed] the speed in knots 
\item[N] the unit of the speed in knots
\item[Speed] the speed in kilometers per hour
\item[K] the unit for speed in kilometers per hour
\end{description}

An example of this sentence can be seen in example \ref{ex:vtg}
\begin{ex}
\texttt{\$GPVTG,054.7,T,034.4,M,005.5,N,010.2,K*48}
\label{ex:vtg}
\end{ex}

\subsubsection{APB}
Autopilot Sentence "B", is the NMEA 0183 sentence that contain the variables calculated for an autopilot, an example sentence can be found in example \ref{ex:apb}

\begin{ex}
\texttt{\$GPAPB,A,A,0.10,R,N,V,V,011,M,DEST,011,M,011,M*3C }
\label{ex:apb}
\end{ex}

The APB sentence is built up of 14 variables in this order:
\begin{description}
\item[Status] can be V or A for LORAN-C blink warning flag or general warning respectively 
\item[Status] can be V or A for Loran-C cycle lock warning flag or OK respectively
\item[Cross track error magnitude] is the how far away from the desired line the GPS receiver is.  
\item[Direction to steer] What way to steer to get back to the desired line.
\item[Cross track unit] N for nautical miles, and K for kilometers
\item[Status] A if the GPS receiver is inside the arrival circle
\item[Status] A if the GPS receiver has passed the perpendicular line at the waypoint
\item[Bearing] origin to destination 
\item[Bearing unit] M for magnetic, T for true
\item[Destination Waypoint ID]
\item[Bearing] present position to destination 
\item[Bearing unit] M for magnetic, T for true
\item[Heading to steer] to destination waypoint 
\item[Heading unit] M for magnetic, T for true
\end{description}
