nicolaibonde/Boat-autopilot-documentation/Appendix/Project/Research/MotorAmperageTest/Bat_servo_no_load.csv

x-axis | 1
second | Volt
-4.98E-04 | -5.80E-02
-4.98E-04 | -5.63E-02
-4.97E-04 | -5.80E-02
-4.97E-04 | -6.03E-02
-4.96E-04 | -5.83E-02
-4.96E-04 | -5.48E-02
-4.95E-04 | -6.03E-02
-4.95E-04 | -5.78E-02
-4.94E-04 | -5.63E-02
-4.94E-04 | -6.01E-02
-4.93E-04 | -5.78E-02
-4.93E-04 | -5.63E-02
-4.92E-04 | -5.83E-02
-4.92E-04 | -5.65E-02
-4.91E-04 | -5.48E-02
-4.91E-04 | -6.01E-02
-4.90E-04 | -5.80E-02
-4.90E-04 | -5.65E-02
-4.89E-04 | -5.48E-02
-4.89E-04 | -5.40E-02
-4.88E-04 | -5.60E-02
-4.88E-04 | -5.58E-02
-4.87E-04 | -5.80E-02
-4.87E-04 | -5.83E-02
-4.86E-04 | -5.63E-02
-4.86E-04 | -5.08E-02
-4.85E-04 | -5.25E-02
-4.85E-04 | -5.58E-02
-4.84E-04 | -5.48E-02
-4.84E-04 | -5.55E-02
-4.83E-04 | -5.58E-02
-4.83E-04 | -5.05E-02
-4.82E-04 | -5.53E-02
-4.82E-04 | -5.60E-02
-4.81E-04 | -5.63E-02
-4.81E-04 | -5.25E-02
-4.80E-04 | -5.38E-02
-4.80E-04 | -5.05E-02
-4.79E-04 | -5.08E-02
-4.79E-04 | -5.38E-02
-4.78E-04 | -5.43E-02
-4.78E-04 | -5.28E-02
-4.77E-04 | -5.45E-02
-4.77E-04 | -5.13E-02
-4.76E-04 | -5.60E-02
-4.76E-04 | -5.60E-02
-4.75E-04 | -5.55E-02
-4.75E-04 | -5.80E-02
-4.74E-04 | -5.23E-02
-4.74E-04 | -5.45E-02
-4.73E-04 | -5.63E-02
-4.73E-04 | -5.20E-02
-4.72E-04 | -5.50E-02
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
