nicolaibonde/Boat-autopilot-documentation/Appendix/Project/Research/MotorAmperageTest/Motor_battery_no_load_initial.csv

x-axis | 1
second | Volt
-150.0000E-03
-149.8500E-03
-149.7000E-03
-149.5500E-03
-149.4000E-03
-149.2500E-03
-149.1000E-03
-148.9500E-03
-148.8000E-03
-148.6500E-03
-148.5000E-03
-148.3500E-03
-148.2000E-03
-148.0500E-03
-147.9000E-03
-147.7500E-03
-147.6000E-03
-147.4500E-03
-147.3000E-03
-147.1500E-03
-147.0000E-03
-146.8500E-03
-146.7000E-03
-146.5500E-03
-146.4000E-03
-146.2500E-03
-146.1000E-03
-145.9500E-03
-145.8000E-03
-145.6500E-03
-145.5000E-03
-145.3500E-03
-145.2000E-03
-145.0500E-03
-144.9000E-03
-144.7500E-03
-144.6000E-03
-144.4500E-03
-144.3000E-03
-144.1500E-03
-144.0000E-03
-143.8500E-03
-143.7000E-03
-143.5500E-03
-143.4000E-03
-143.2500E-03
-143.1000E-03
-142.9500E-03
-142.8000E-03
-142.6500E-03
-142.5000E-03
-142.3500E-03
-142.2000E-03
-142.0500E-03
-141.9000E-03
-141.7500E-03
-141.6000E-03
-141.4500E-03
-141.3000E-03
-141.1500E-03
-141.0000E-03
-140.8500E-03
-140.7000E-03
-140.5500E-03
-140.4000E-03
-140.2500E-03
-140.1000E-03
-139.9500E-03
-139.8000E-03
-139.6500E-03
-139.5000E-03
-139.3500E-03
-139.2000E-03
-139.0500E-03
-138.9000E-03
-138.7500E-03
-138.6000E-03
-138.4500E-03
-138.3000E-03
-138.1500E-03
-138.0000E-03
-137.8500E-03
-137.7000E-03
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
