nicolaibonde/Boat-autopilot-documentation/Appendix/Project/Research/MotorAmperageTest/Motor_battery_no_load_initial2.csv

x-axis | 1
second | Volt
-100.000E-03 | +3.285396E+00
-99.900E-03 | +3.285396E+00
-99.800E-03 | +3.305496E+00
-99.700E-03 | +3.285396E+00
-99.600E-03 | +3.285396E+00
-99.500E-03 | +3.285396E+00
-99.400E-03 | +3.285396E+00
-99.300E-03 | +3.285396E+00
-99.200E-03 | +3.285396E+00
-99.100E-03 | +3.285396E+00
-99.000E-03 | +3.285396E+00
-98.900E-03 | +3.305496E+00
-98.800E-03 | +3.285396E+00
-98.700E-03 | +3.285396E+00
-98.600E-03 | +3.285396E+00
-98.500E-03 | +3.285396E+00
-98.400E-03 | +3.285396E+00
-98.300E-03 | +3.285396E+00
-98.200E-03 | +3.305496E+00
-98.100E-03 | +3.285396E+00
-98.000E-03 | +3.285396E+00
-97.900E-03 | +3.285396E+00
-97.800E-03 | +3.305496E+00
-97.700E-03 | +3.285396E+00
-97.600E-03 | +3.285396E+00
-97.500E-03 | +3.285396E+00
-97.400E-03 | +3.285396E+00
-97.300E-03 | +3.305496E+00
-97.200E-03 | +3.285396E+00
-97.100E-03 | +3.285396E+00
-97.000E-03 | +3.285396E+00
-96.900E-03 | +3.285396E+00
-96.800E-03 | +3.285396E+00
-96.700E-03 | +3.285396E+00
-96.600E-03 | +3.285396E+00
-96.500E-03 | +3.285396E+00
-96.400E-03 | +3.285396E+00
-96.300E-03 | +3.285396E+00
-96.200E-03 | +3.285396E+00
-96.100E-03 | +3.285396E+00
-96.000E-03 | +3.305496E+00
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
