nicolaibonde/Boat-autopilot-documentation/Appendix/Project/Research/MotorAmperageTest/Motor_motor_no_load.csv

x-axis | 1
second | Volt
-996.00E-06 | -3.01508E-03
-995.00E-06 | -502.51E-06
-994.00E-06 | -3.51759E-03
-993.00E-06 | -3.51759E-03
-992.00E-06 | -4.52261E-03
-991.00E-06 | -502.51E-06
-990.00E-06 | +0.0E+00
-989.00E-06 | -502.51E-06
-988.00E-06 | -3.51759E-03
-987.00E-06 | -3.51759E-03
-986.00E-06 | -3.51759E-03
-985.00E-06 | -502.51E-06
-984.00E-06 | +502.51E-06
-983.00E-06 | +0.0E+00
-982.00E-06 | +0.0E+00
-981.00E-06 | -3.51759E-03
-980.00E-06 | -4.02010E-03
-979.00E-06 | -4.02010E-03
-978.00E-06 | -3.51759E-03
-977.00E-06 | -502.51E-06
-976.00E-06 | -4.02010E-03
-975.00E-06 | -3.51759E-03
-974.00E-06 | -4.02010E-03
-973.00E-06 | +0.0E+00
-972.00E-06 | -3.51759E-03
-971.00E-06 | -3.51759E-03
-970.00E-06 | +0.0E+00
-969.00E-06 | -3.51759E-03
-968.00E-06 | -3.01508E-03
-967.00E-06 | -3.51759E-03
-966.00E-06 | -3.51759E-03
-965.00E-06 | -4.02010E-03
-964.00E-06 | +502.51E-06
-963.00E-06 | -3.51759E-03
-962.00E-06 | +3.51759E-03
-961.00E-06 | -3.51759E-03
-960.00E-06 | +0.0E+00
-959.00E-06 | +0.0E+00
-958.00E-06 | -3.51759E-03
-957.00E-06 | -502.51E-06
-956.00E-06 | +0.0E+00
-955.00E-06 | +502.51E-06
-954.00E-06 | -4.02010E-03
-953.00E-06 | -502.51E-06
-952.00E-06 | +0.0E+00
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
