nicolaibonde/Boat-autopilot-documentation/Appendix/Project/Research/MotorAmperageTest/Motor_motor_no_load_high_speed.csv

x-axis | 1
second | Volt
-996.00E-06 | +63.81909E-03
-995.00E-06 | +68.34171E-03
-994.00E-06 | +76.38191E-03
-993.00E-06 | +87.93970E-03
-992.00E-06 | +91.95980E-03
-991.00E-06 | +101.00502E-03
-990.00E-06 | +108.04020E-03
-989.00E-06 | +109.04522E-03
-988.00E-06 | +113.06533E-03
-987.00E-06 | +113.06533E-03
-986.00E-06 | +109.04522E-03
-985.00E-06 | +109.04522E-03
-984.00E-06 | +108.54271E-03
-983.00E-06 | +104.02010E-03
-982.00E-06 | +97.48744E-03
-981.00E-06 | +96.98492E-03
-980.00E-06 | +93.46734E-03
-979.00E-06 | +96.98492E-03
-978.00E-06 | +91.95980E-03
-977.00E-06 | +95.97990E-03
-976.00E-06 | +92.96482E-03
-975.00E-06 | +100.50251E-03
-974.00E-06 | +96.48241E-03
-973.00E-06 | +96.98492E-03
-972.00E-06 | +101.00502E-03
-971.00E-06 | +100.50251E-03
-970.00E-06 | +100.50251E-03
-969.00E-06 | +105.02512E-03
-968.00E-06 | +104.52261E-03
-967.00E-06 | +108.04020E-03
-966.00E-06 | +104.52261E-03
-965.00E-06 | +101.00502E-03
-964.00E-06 | +100.50251E-03
-963.00E-06 | +104.52261E-03
-962.00E-06 | +101.00502E-03
-961.00E-06 | +104.52261E-03
-960.00E-06 | +101.00502E-03
-959.00E-06 | +100.50251E-03
-958.00E-06 | +104.02010E-03
-957.00E-06 | +100.50251E-03
-956.00E-06 | +104.02010E-03
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
