nicolaibonde/Boat-autopilot-documentation/Appendix/Project/Research/MotorAmperageTest/Motor_motor_water_load_Short_duration.csv

x-axis | 1
second | Volt
-2.500000E-03 | +16.080402E-03
-2.497500E-03 | +16.080402E-03
-2.495000E-03 | +16.080402E-03
-2.492500E-03 | +12.060301E-03
-2.490000E-03 | +12.060301E-03
-2.487500E-03 | +12.060301E-03
-2.485000E-03 | +16.080402E-03
-2.482500E-03 | +20.100502E-03
-2.480000E-03 | +16.080402E-03
-2.477500E-03 | +16.080402E-03
-2.475000E-03 | +12.060301E-03
-2.472500E-03 | +16.080402E-03
-2.470000E-03 | +16.080402E-03
-2.467500E-03 | +16.080402E-03
-2.465000E-03 | +16.080402E-03
-2.462500E-03 | +12.060301E-03
-2.460000E-03 | +12.060301E-03
-2.457500E-03 | +16.080402E-03
-2.455000E-03 | +16.080402E-03
-2.452500E-03 | +16.080402E-03
-2.450000E-03 | +16.080402E-03
-2.447500E-03 | +16.080402E-03
-2.445000E-03 | +12.060301E-03
-2.442500E-03 | +12.060301E-03
-2.440000E-03 | +16.080402E-03
-2.437500E-03 | +16.080402E-03
-2.435000E-03 | +20.100502E-03
-2.432500E-03 | +12.060301E-03
-2.430000E-03 | +12.060301E-03
-2.427500E-03 | +12.060301E-03
-2.425000E-03 | +16.080402E-03
-2.422500E-03 | +16.080402E-03
-2.420000E-03 | +16.080402E-03
-2.417500E-03 | +16.080402E-03
-2.415000E-03 | +16.080402E-03
-2.412500E-03 | +12.060301E-03
-2.410000E-03 | +16.080402E-03
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
