nicolaibonde/Boat-autopilot-documentation/Appendix/Project/Dokumentation/Images/Implementation/Motor_controller_test.png

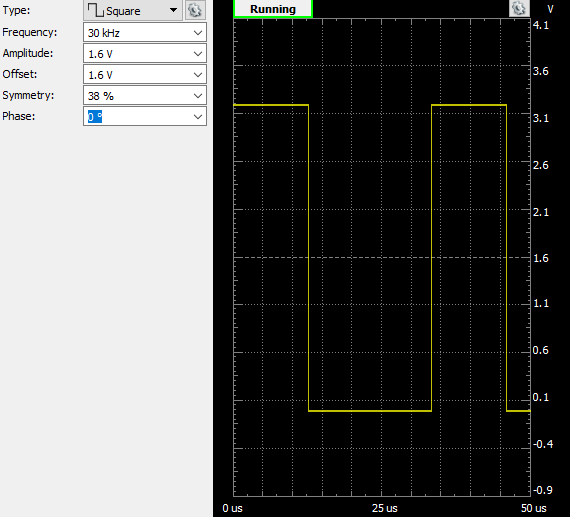
Appendix/Project/Dokumentation/Images/Implementation/Motor_controller_test.png
