nicolaibonde/Boat-autopilot-documentation/Appendix/Project/Dokumentation/Images/Implementation/Motor_PWM_test.png

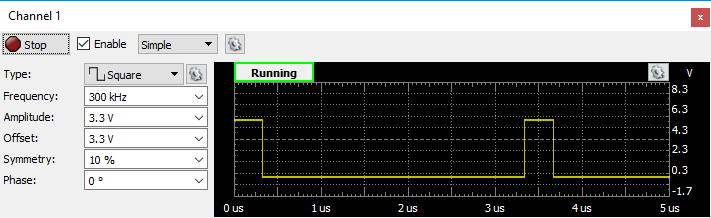
Appendix/Project/Dokumentation/Images/Implementation/Motor_PWM_test.png
