nicolaibonde/Boat-autopilot-documentation/Appendix/Project/Research/MotorAmperageTest/Bat_servo_no_load.png

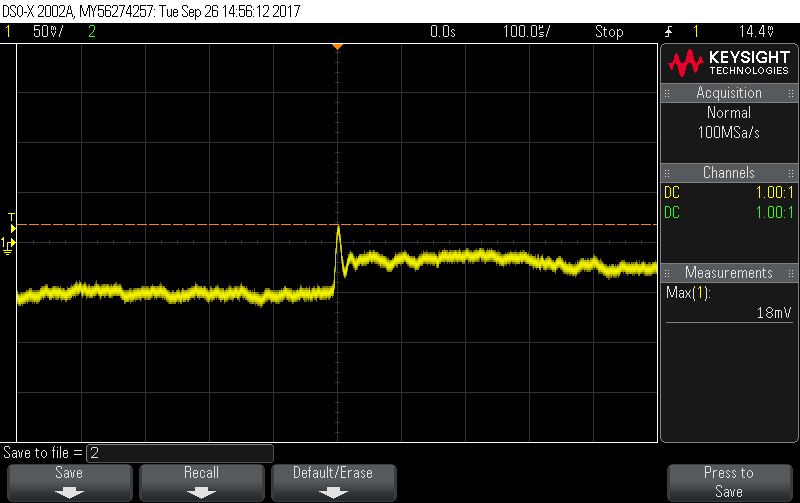
Appendix/Project/Research/MotorAmperageTest/Bat_servo_no_load.png
