nicolaibonde/Boat-autopilot-documentation/Appendix/Project/Research/MotorAmperageTest/Motor_battery_no_load_initial2.png

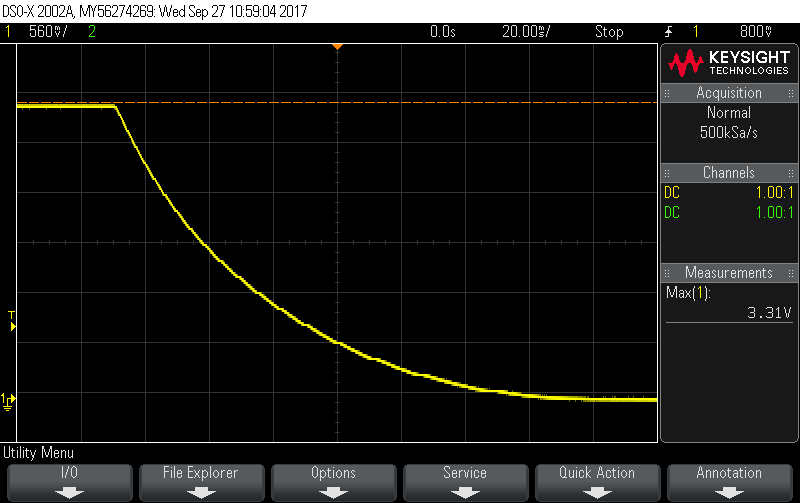
Appendix/Project/Research/MotorAmperageTest/Motor_battery_no_load_initial2.png
