nicolaibonde/Boat-autopilot-documentation/Appendix/Project/Research/MotorAmperageTest/Motor_motor_no_load.png

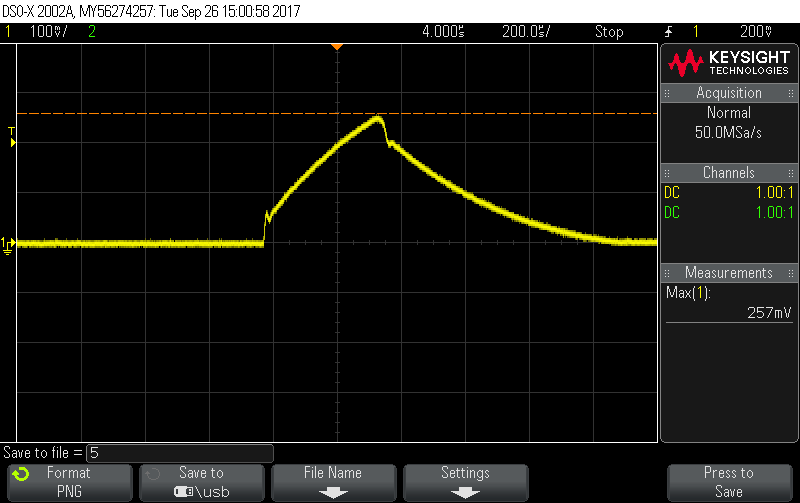
Appendix/Project/Research/MotorAmperageTest/Motor_motor_no_load.png
