nicolaibonde/Boat-autopilot-documentation/Appendix/Project/Research/MotorAmperageTest/Motor_motor_no_load_high_speed.png

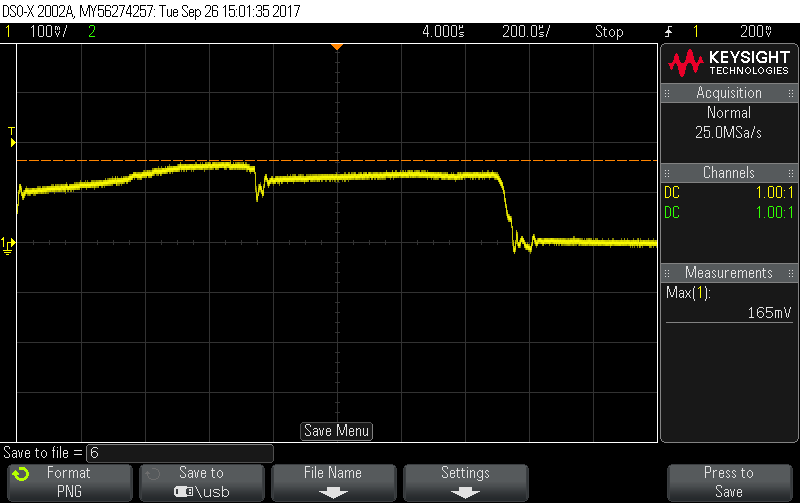
Appendix/Project/Research/MotorAmperageTest/Motor_motor_no_load_high_speed.png
