nicolaibonde/Boat-autopilot-documentation/Appendix/Project/Research/MotorAmperageTest/Motor_motor_water_load_long_duration.png

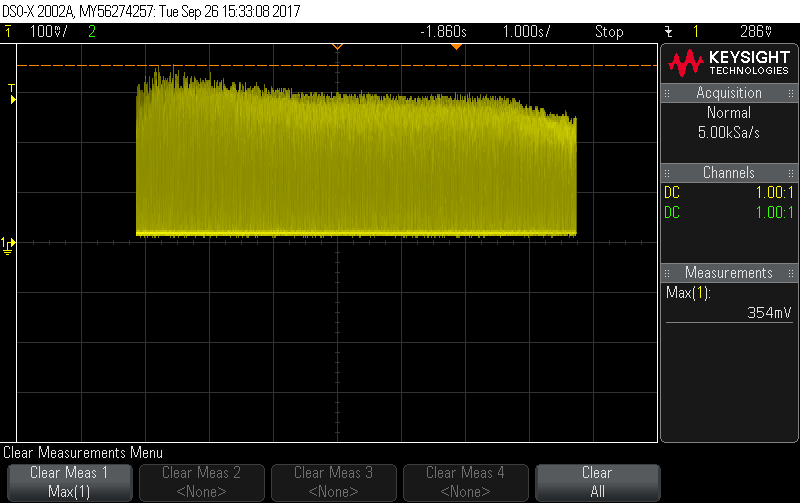
Appendix/Project/Research/MotorAmperageTest/Motor_motor_water_load_long_duration.png
