nicolaibonde/Boat-autopilot-documentation/Appendix/Project/Research/RegulatorTests/3V_falling_edge.png

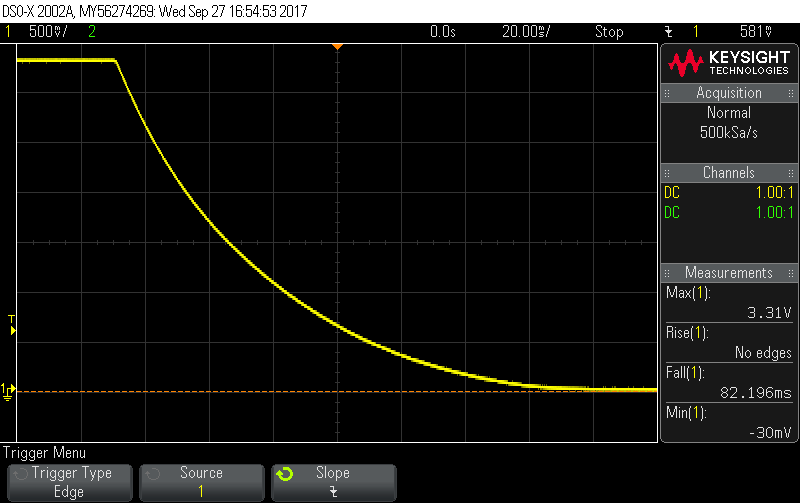
Appendix/Project/Research/RegulatorTests/3V_falling_edge.png
