nicolaibonde/Boat-autopilot-documentation/Appendix/Project/Research/RegulatorTests/5V_falling_edge.png

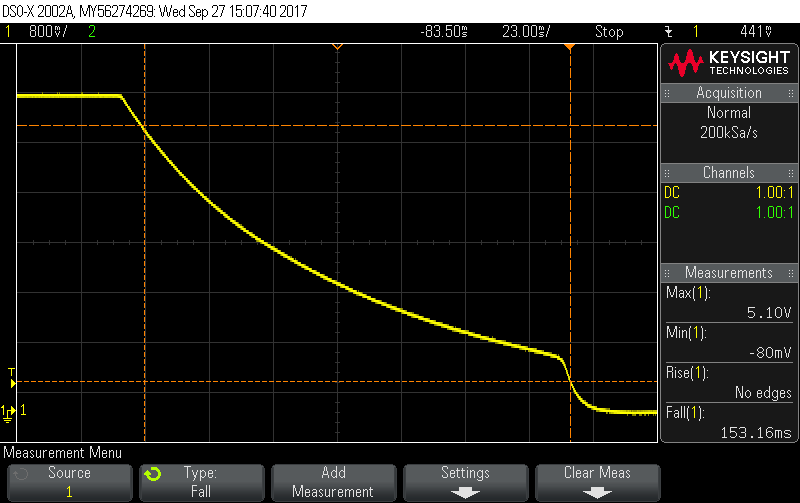
Appendix/Project/Research/RegulatorTests/5V_falling_edge.png
