nicolaibonde/Boat-autopilot-documentation/Report/rich_image.pdf

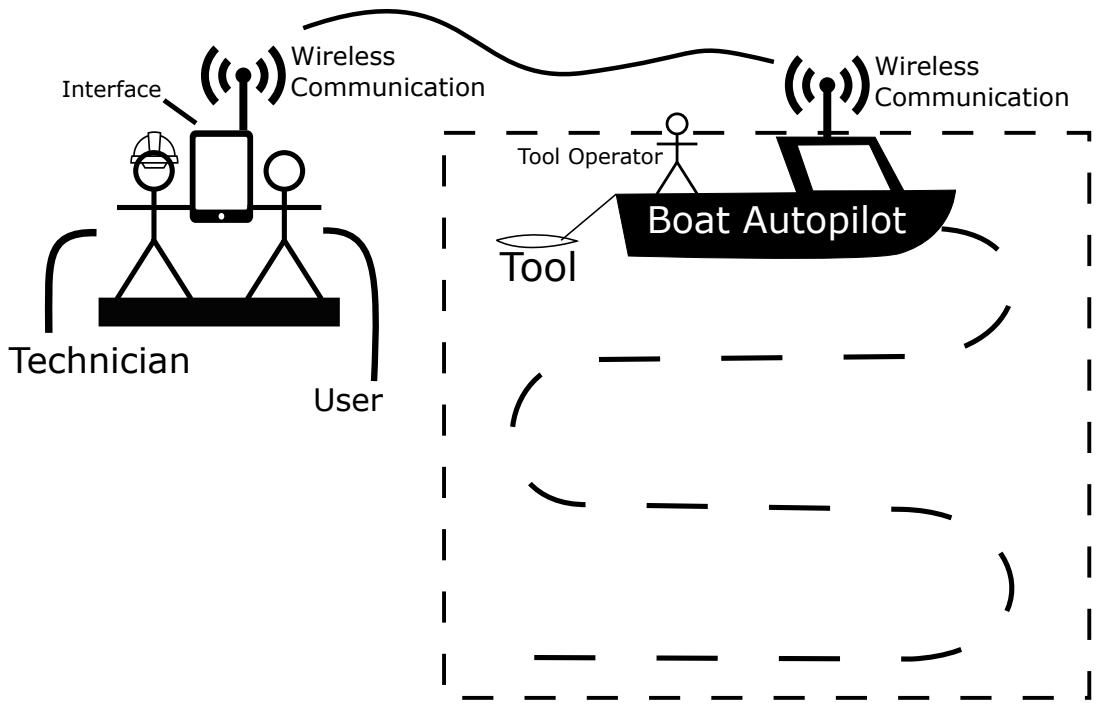
[picture p92: page 1]
Tool; Tool Operator Boat Autopilot; Wireless Communication; Wireless; Interface; Communication; Technician; User
