nicolaibonde/Boat-autopilot-documentation/Appendix/Project/Dokumentation/Images/Design/DCMotor_class_diagram.pdf

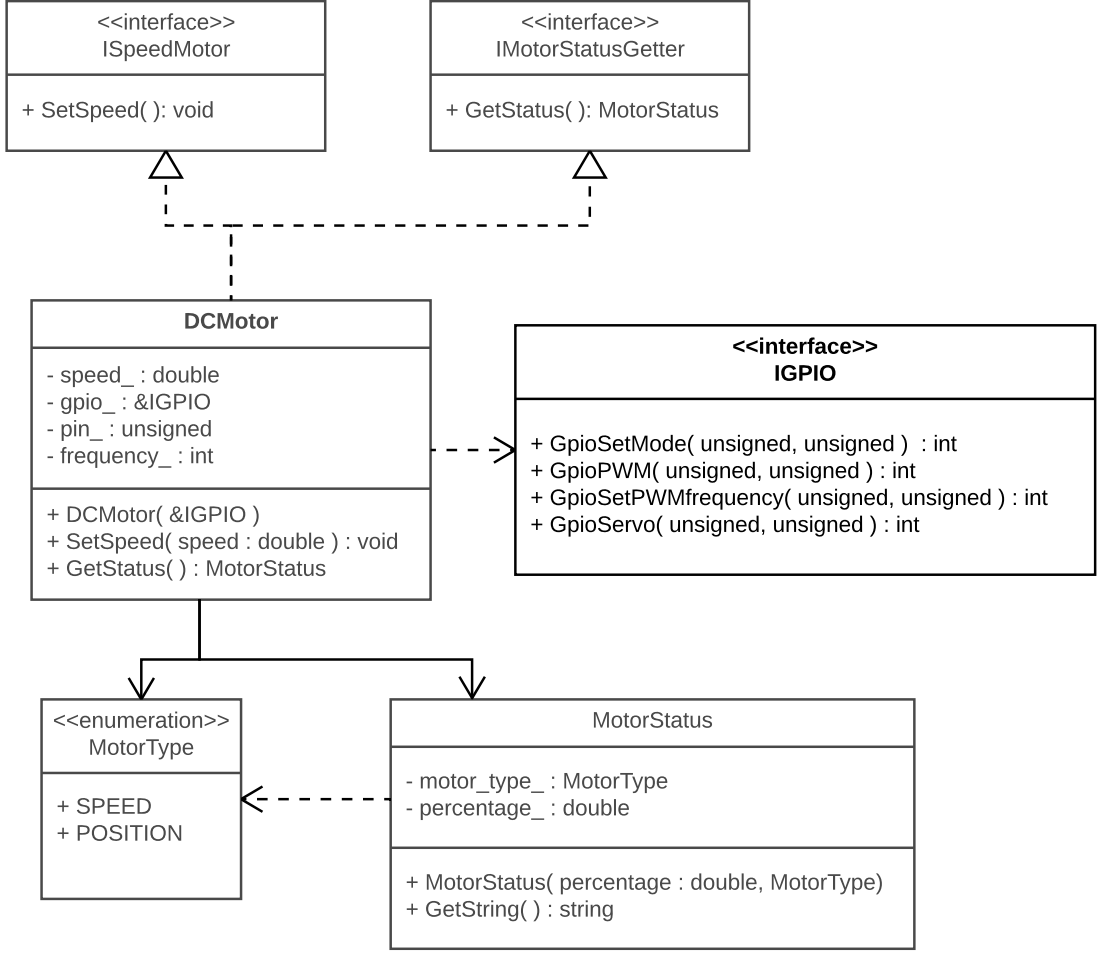
[picture p93: page 1]
DCMotor; - speed_ : double - gpio_ : &IGPIO - pin_ : unsigned - frequency_ : int; <<interface>> ISpeedMotor; + SetSpeed( ): void; <<interface>> IMotorStatusGetter; + GetStatus( ): MotorStatus; MotorStatus; - motor_type_ : MotorType - percentage_ : double; <<enumeration>> MotorType; + SPEED + POSITION; <<interface>> IGPIO

+ GpioSetMode( unsigned, unsigned ) : int
+ GpioPWM( unsigned, unsigned ) : int
+ GpioSetPWMfrequency( unsigned, unsigned ) : int
+ GpioServo( unsigned, unsigned ) : int

+ DCMotor( &IGPIO )
+ SetSpeed( speed : double ) : void
+ GetStatus( ) : MotorStatus

+ MotorStatus( percentage : double, MotorType)
+ GetString( ) : string
