nicolaibonde/Boat-autopilot-documentation/Appendix/Project/Dokumentation/Images/Design/Servo_class_diagram.pdf

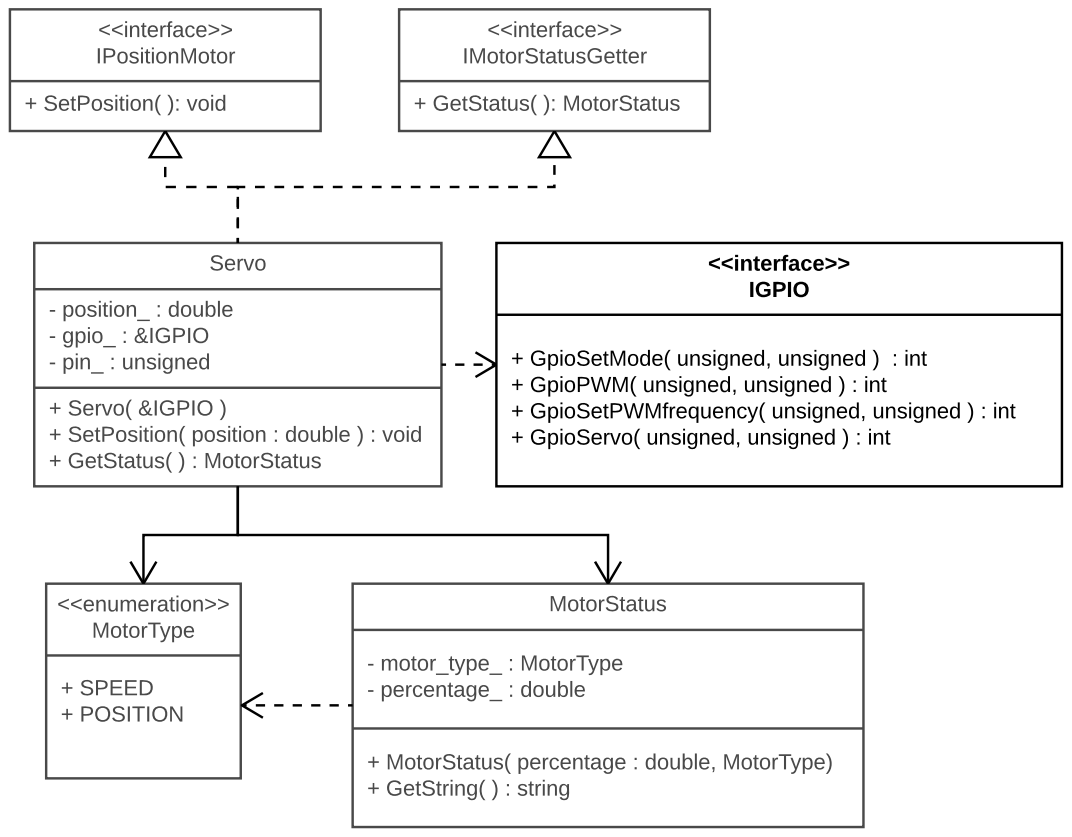
[picture p94: page 1]
Servo; <<interface>> IPositionMotor; + SetPosition( ): void; <<enumeration>> MotorType; + SPEED + POSITION; MotorStatus; - motor_type_ : MotorType - percentage_ : double; <<interface>> IMotorStatusGetter; + GetStatus( ): MotorStatus; <<interface>> IGPIO

- position_ : double
- gpio_ : &IGPIO
- pin_ : unsigned
+ Servo( &IGPIO )
+ SetPosition( position : double ) : void
+ GetStatus( ) : MotorStatus

+ GpioSetMode( unsigned, unsigned ) : int
+ GpioPWM( unsigned, unsigned ) : int
+ GpioSetPWMfrequency( unsigned, unsigned ) : int
+ GpioServo( unsigned, unsigned ) : int

+ MotorStatus( percentage : double, MotorType)
+ GetString( ) : string
