nicolaibonde/Boat-autopilot-documentation/Appendix/Project/Dokumentation/Images/Design/Status_class_diagram.pdf

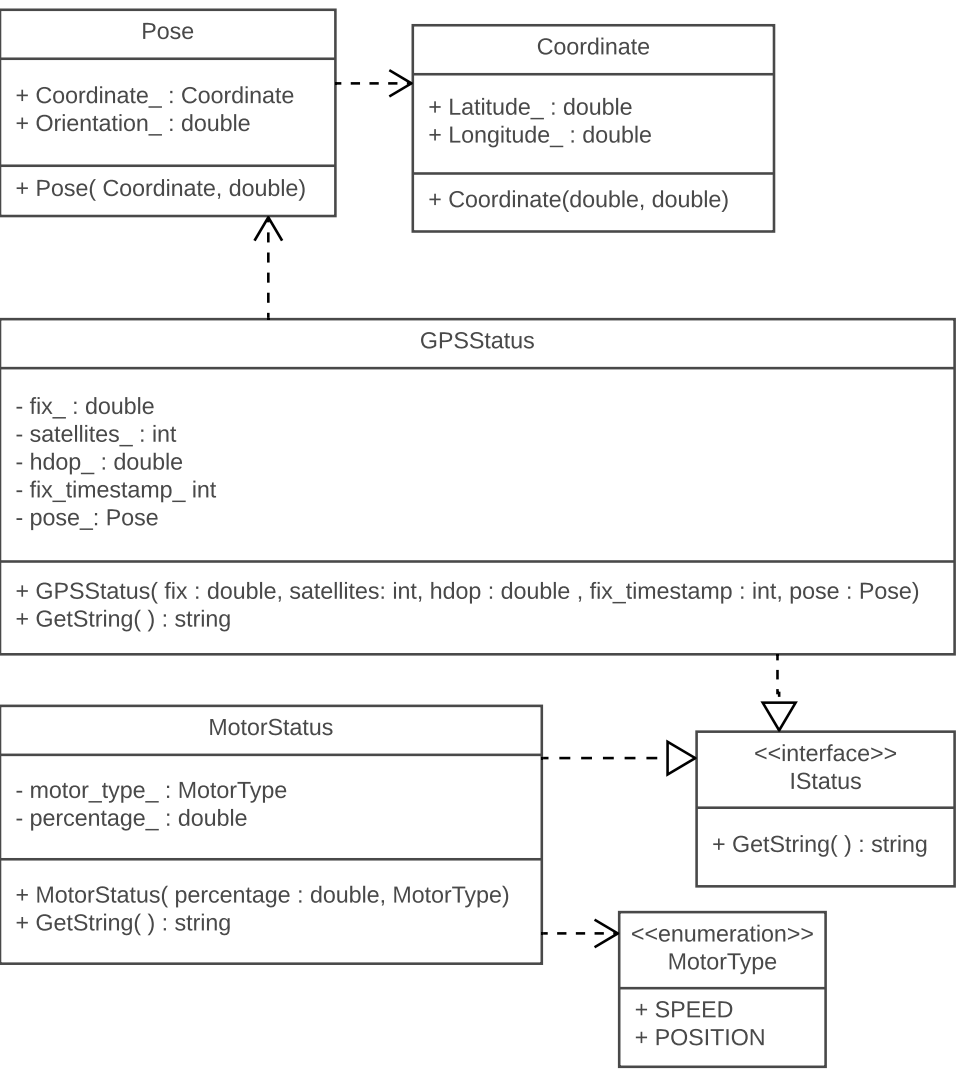
[picture p95: page 1]
<<interface>> IStatus; + GetString( ) : string; GPSStatus; - fix_ : double - satellites_ : int - hdop_ : double - fix_timestamp_ int - pose_: Pose; MotorStatus; - motor_type_ : MotorType - percentage_ : double; Pose; + Coordinate_ : Coordinate + Orientation_ : double; <<enumeration>> MotorType; + SPEED + POSITION; Coordinate; + Latitude_ : double + Longitude_ : double

+ Pose( Coordinate, double)

+ Coordinate(double, double)

+ GPSStatus( fix : double, satellites: int, hdop : double , fix_timestamp : int, pose : Pose)
+ GetString( ) : string

+ MotorStatus( percentage : double, MotorType)
