nicolaibonde/Boat-autopilot-documentation/Appendix/Project/Dokumentation/Images/Design/Autopilot_class_diagram.pdf

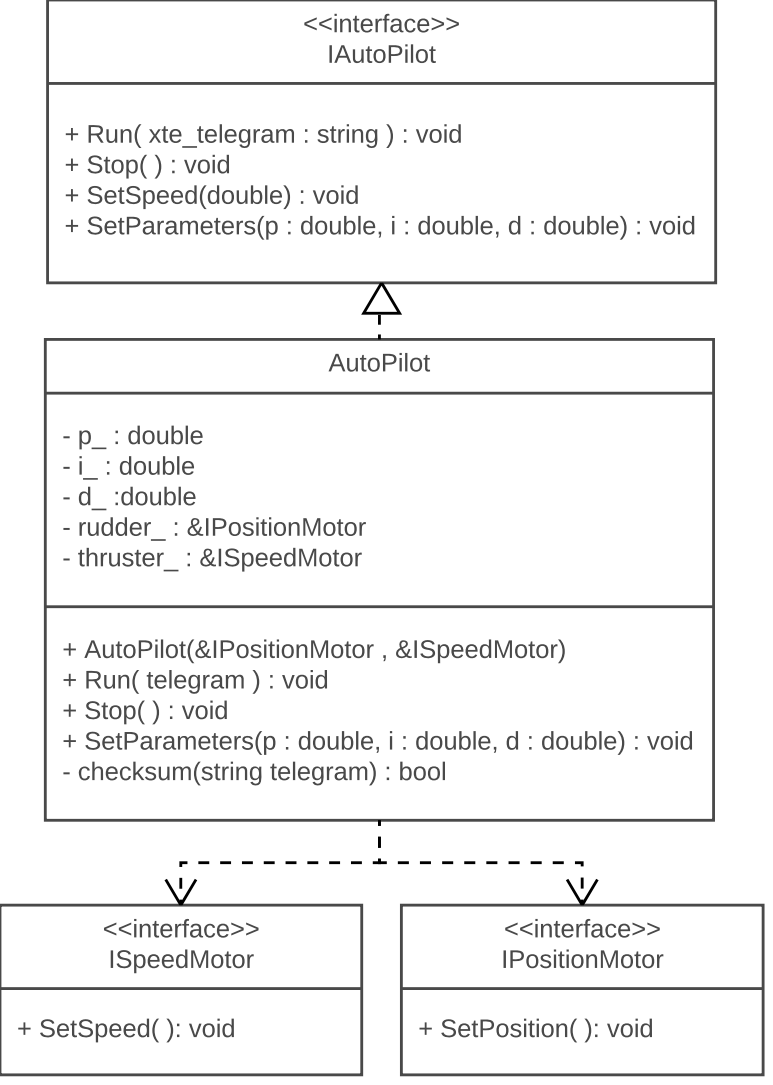
[picture p96: page 1]
AutoPilot; - p_ : double - i_ : double - d_ :double - rudder_ : &IPositionMotor - thruster_ : &ISpeedMotor; <<interface>> IAutoPilot; <<interface>> ISpeedMotor; + SetSpeed( ): void; <<interface>> IPositionMotor; + SetPosition( ): void

+ Run( xte_telegram : string ) : void
+ Stop( ) : void
+ SetSpeed(double) : void
+ SetParameters(p : double, i : double, d : double) : void

+ AutoPilot(&IPositionMotor , &ISpeedMotor)
+ Run( telegram ) : void
- checksum(string telegram) : bool
