nicolaibonde/Boat-autopilot-documentation/Appendix/Project/Dokumentation/Images/Requirements_specification/UI_Mockup_Diagnostics.pdf

## Diagnostics

# Captain Autopilot Control Center

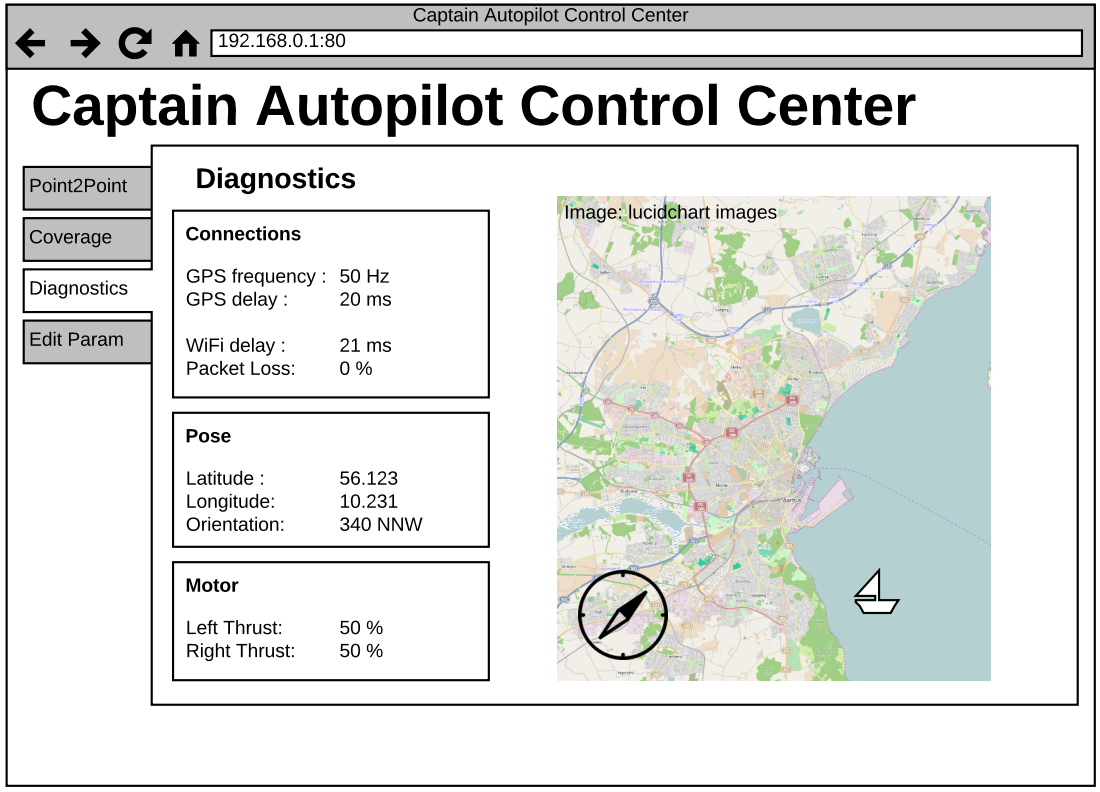
[picture p97: page 1]
Point2Point; Coverage; Diagnostics; Edit Param; Connections; GPS frequency : 50 Hz GPS delay :; WiFi delay :; Packet Loss:; Pose; Latitude :; Longitude:; Orientation:; 340 NNW; Motor; Left Thrust:; Right Thrust:

Captain Autopilot Control Center

Image: lucidchart images
