nicolaibonde/Boat-autopilot-documentation/Appendix/Project/Dokumentation/Images/Requirements_specification/UI_Mockup_Edit_param.pdf

## Edit Parameters

# Captain Autopilot Control Center

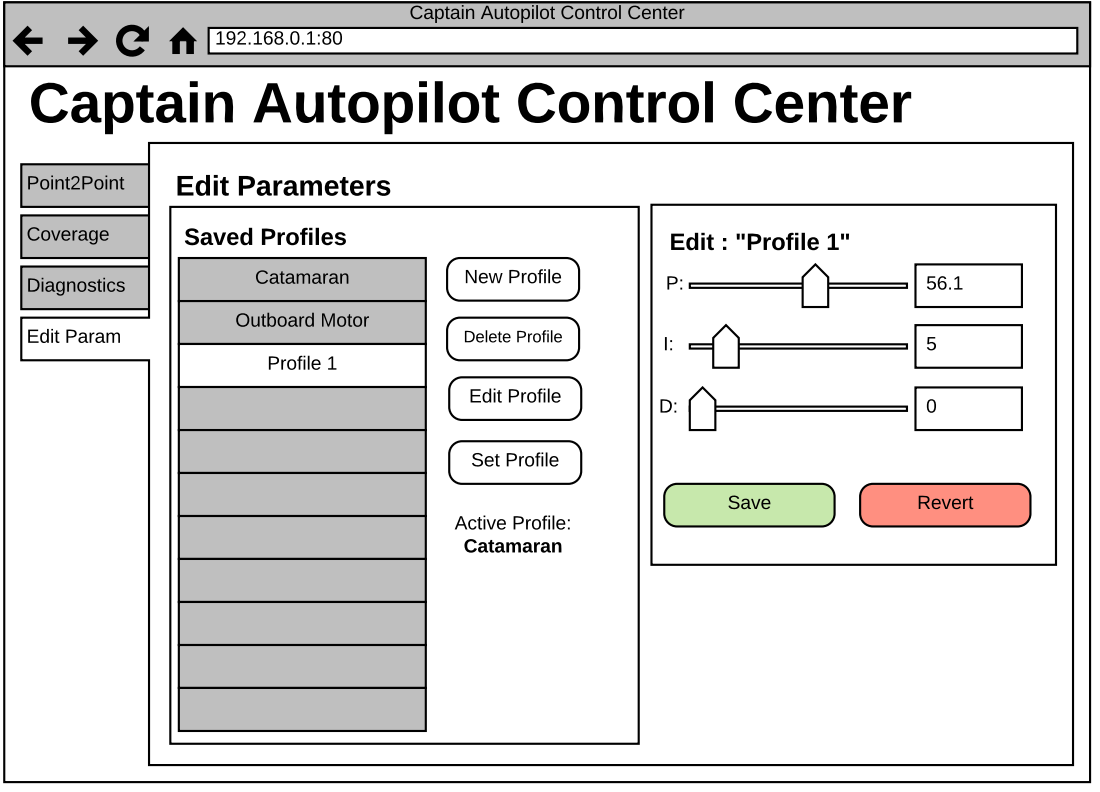
[picture p98: page 1]
Point2Point; Coverage; Diagnostics; Edit Param; Saved Profiles; Catamaran; Outboard Motor; Profile 1; New Profile; Edit Profile; Set Profile; Edit : "Profile 1"; Save; Revert; Delete Profile

Captain Autopilot Control Center

Active Profile: Catamaran
