nicolaibonde/Boat-autopilot-documentation/Appendix/Project/Dokumentation/Images/System_architecture/Domain_Model.pdf

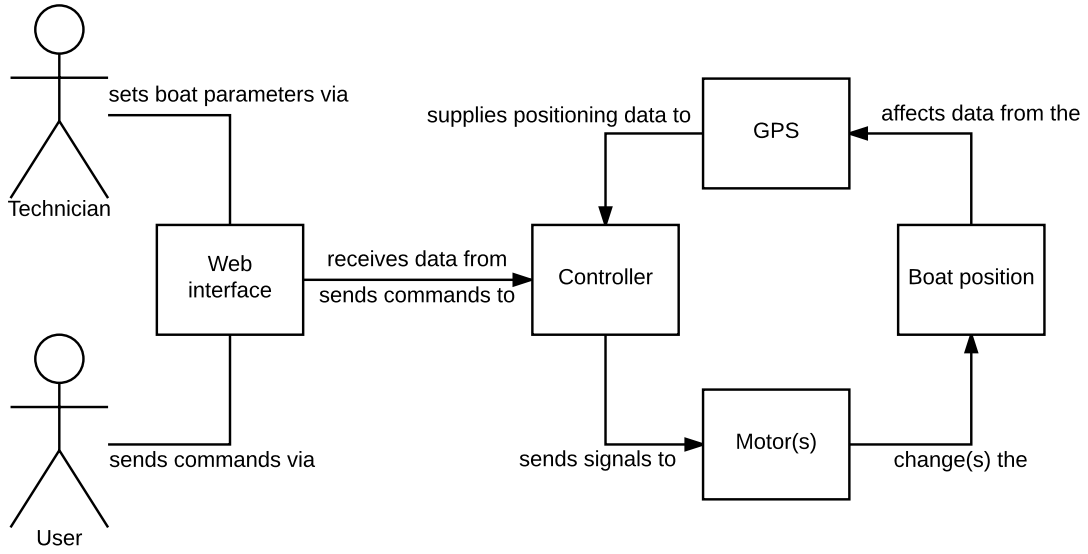
[picture p99: page 1]
Technician; Web; interface; Controller; User; Motor(s); GPS; Boat position; change(s) the

sets boat parameters via

supplies positioning data to

affects data from the

receives data from
sends commands to

sends commands via

sends signals to
