nicolaibonde/Boat-autopilot-documentation/Appendix/Project/Dokumentation/Images/Introduction/rich_image.pdf

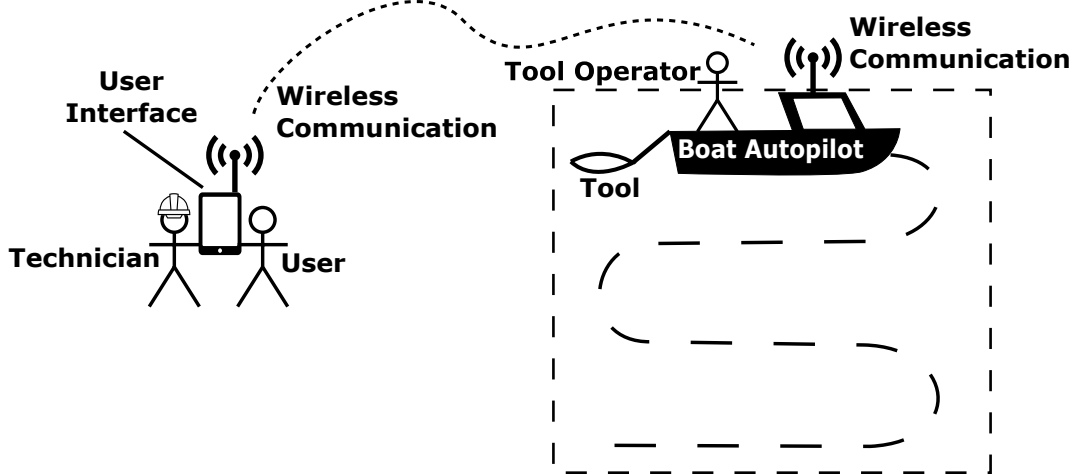
[picture p100: page 1]
Wireless Communication; User Interface; User; Tool; Boat Autopilot; Technician
