nicolaibonde/Boat-autopilot-documentation/Appendix/Project/Dokumentation/Images/Introduction/General_SD.pdf

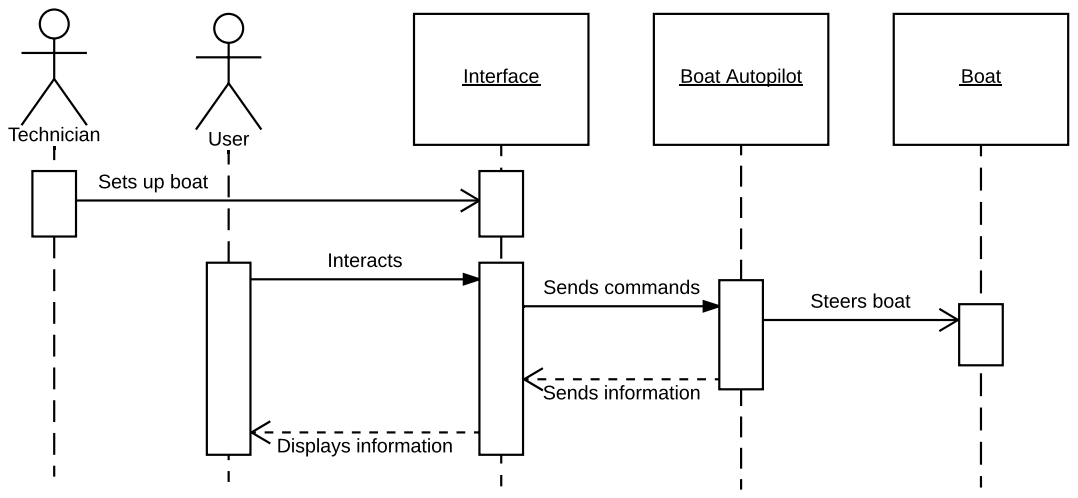
[picture p101: page 1]
Technician; Interface; Boat Autopilot; Boat; User; Interacts; Displays information; Sends commands; Steers boat; Sends information

Sets up boat
