nicolaibonde/Boat-autopilot-documentation/Report/Navigation_class_diagram.pdf

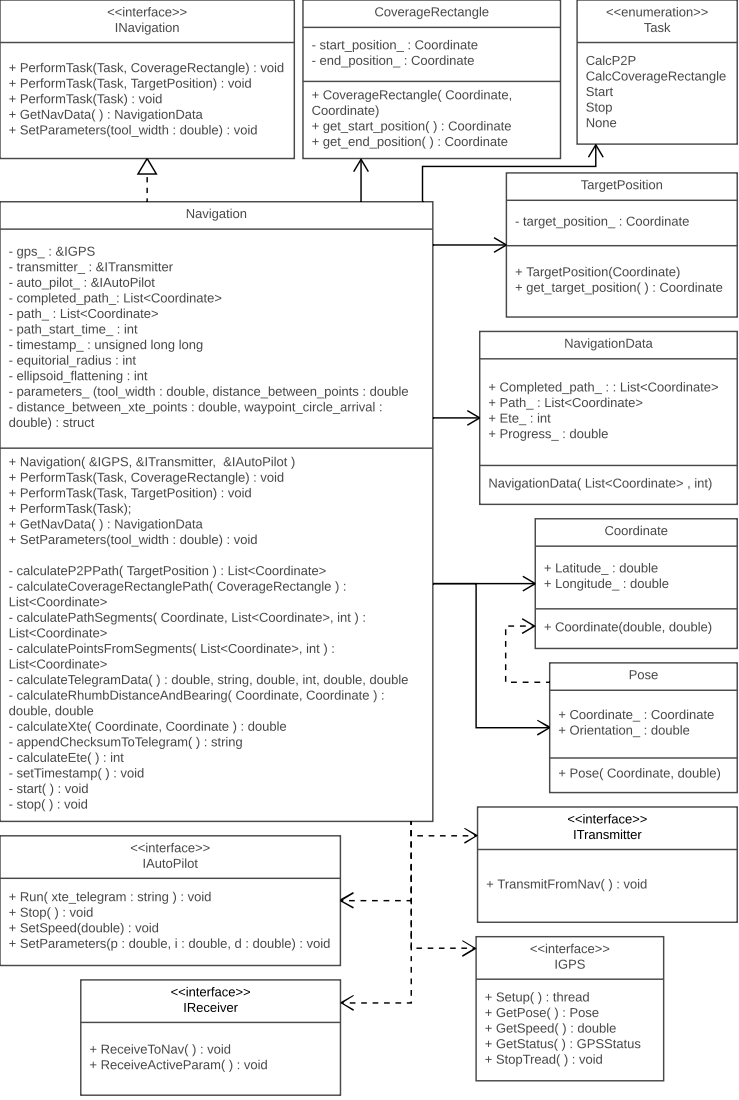
[picture p102: page 1]
<<interface>> INavigation; <<interface>> IAutoPilot; + SetParameters(p : double, i : double, d : double) : void; <<interface>>; IGPS; + Setup( ) : thread + GetPose( ) : Pose + GetSpeed( ) : double + GetStatus( ) : GPSStatus + StopTread( ) : void; <<enumeration>> Task; CalcP2P CalcCoverageRectangle Start Stop None; + TargetPosition(Coordinate) + get_target_position( ) : Coordinate; CoverageRectangle; - start_position_ : Coordinate - end_position_ : Coordinate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

+ PerformTask(Task, CoverageRectangle) : void
+ PerformTask(Task, TargetPosition) : void
+ PerformTask(Task) : void
+ GetNavData( ) : NavigationData
+ SetParameters(tool_width : double) : void

+ CoverageRectangle( Coordinate, Coordinate)

TargetPosition

Navigation | - target_position_ : Coordinate

- gps_ : &IGPS
- transmitter_ : &ITransmitter
- auto_pilot_ : &IAutoPilot
- completed_path_: List<Coordinate>
- path_ : List<Coordinate>
- path_start_time_ : int
- timestamp_ : unsigned long long
- equitorial_radius : int
- ellipsoid_flattening : int
- parameters_ (tool_width : double, distance_between_points : double
- distance_between_xte_points : double, waypoint_circle_arrival :
double) : struct

+ Navigation( &IGPS, &ITransmitter, &IAutoPilot )
+ PerformTask(Task);

NavigationData( List<Coordinate> , int)

- calculateP2PPath( TargetPosition ) : List<Coordinate>
- calculateCoverageRectanglePath( CoverageRectangle ) :
List<Coordinate>
- calculatePathSegments( Coordinate, List<Coordinate>, int ) :
- calculatePointsFromSegments( List<Coordinate>, int ) :
- calculateTelegramData( ) : double, string, double, int, double, double
- calculateRhumbDistanceAndBearing( Coordinate, Coordinate ) :
double, double
- calculateXte( Coordinate, Coordinate ) : double
- appendChecksumToTelegram( ) : string
- calculateEte( ) : int
- setTimestamp( ) : void
- start( ) : void
- stop( ) : void

+ Coordinate(double, double)

+ Pose( Coordinate, double)

+ Run( xte_telegram : string ) : void
+ Stop( ) : void
+ SetSpeed(double) : void
