nicolaibonde/Boat-autopilot-documentation/Report/Hardware_design.pdf

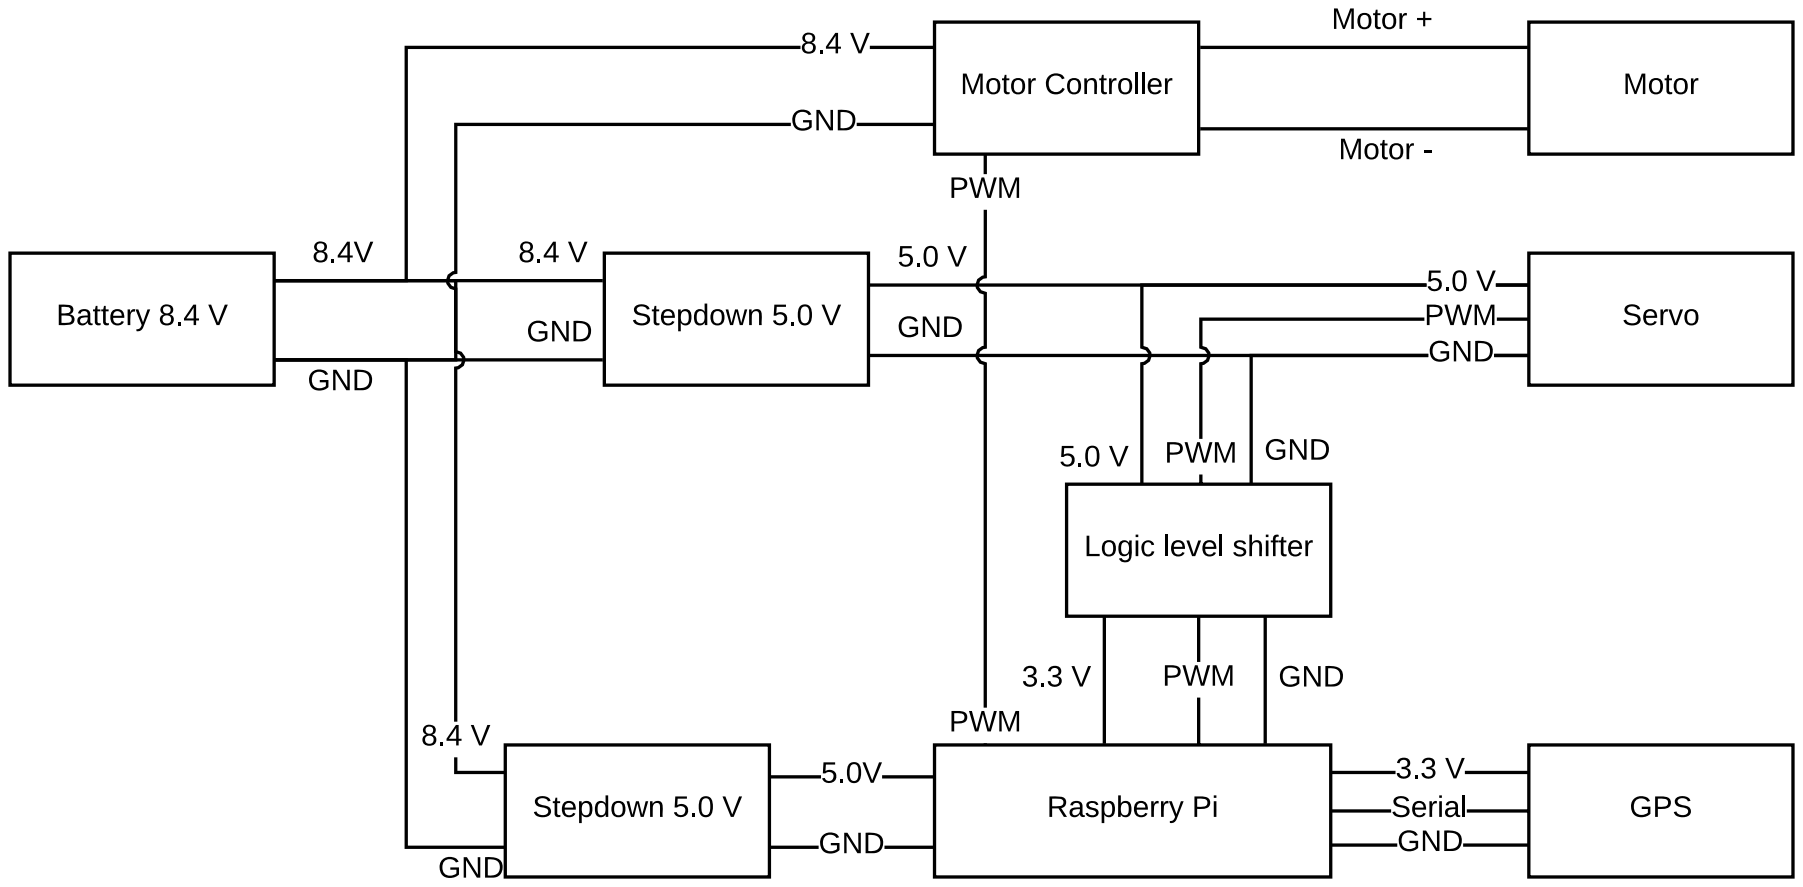
[picture p103: page 1]
