nicolaibonde/Boat-autopilot-documentation/Appendix/Project/Dokumentation/Images/System_architecture/Application_model.pdf

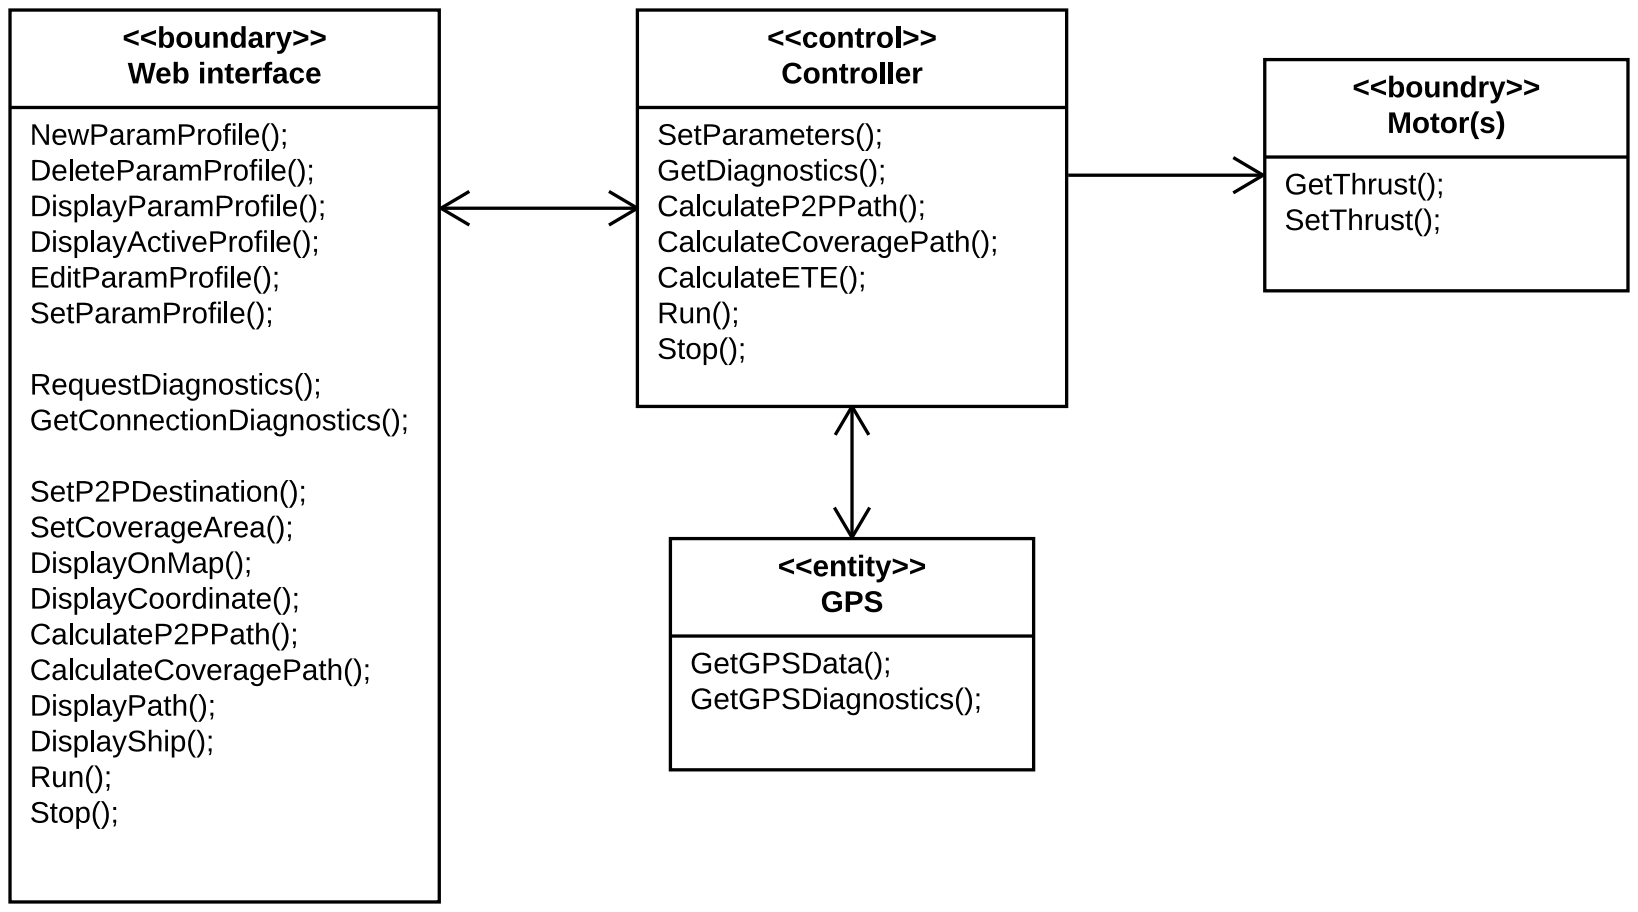
[picture p104: page 1]
