nicolaibonde/Boat-autopilot-documentation/Appendix/Project/Dokumentation/Images/System_architecture/Use_case_11_SD.pdf

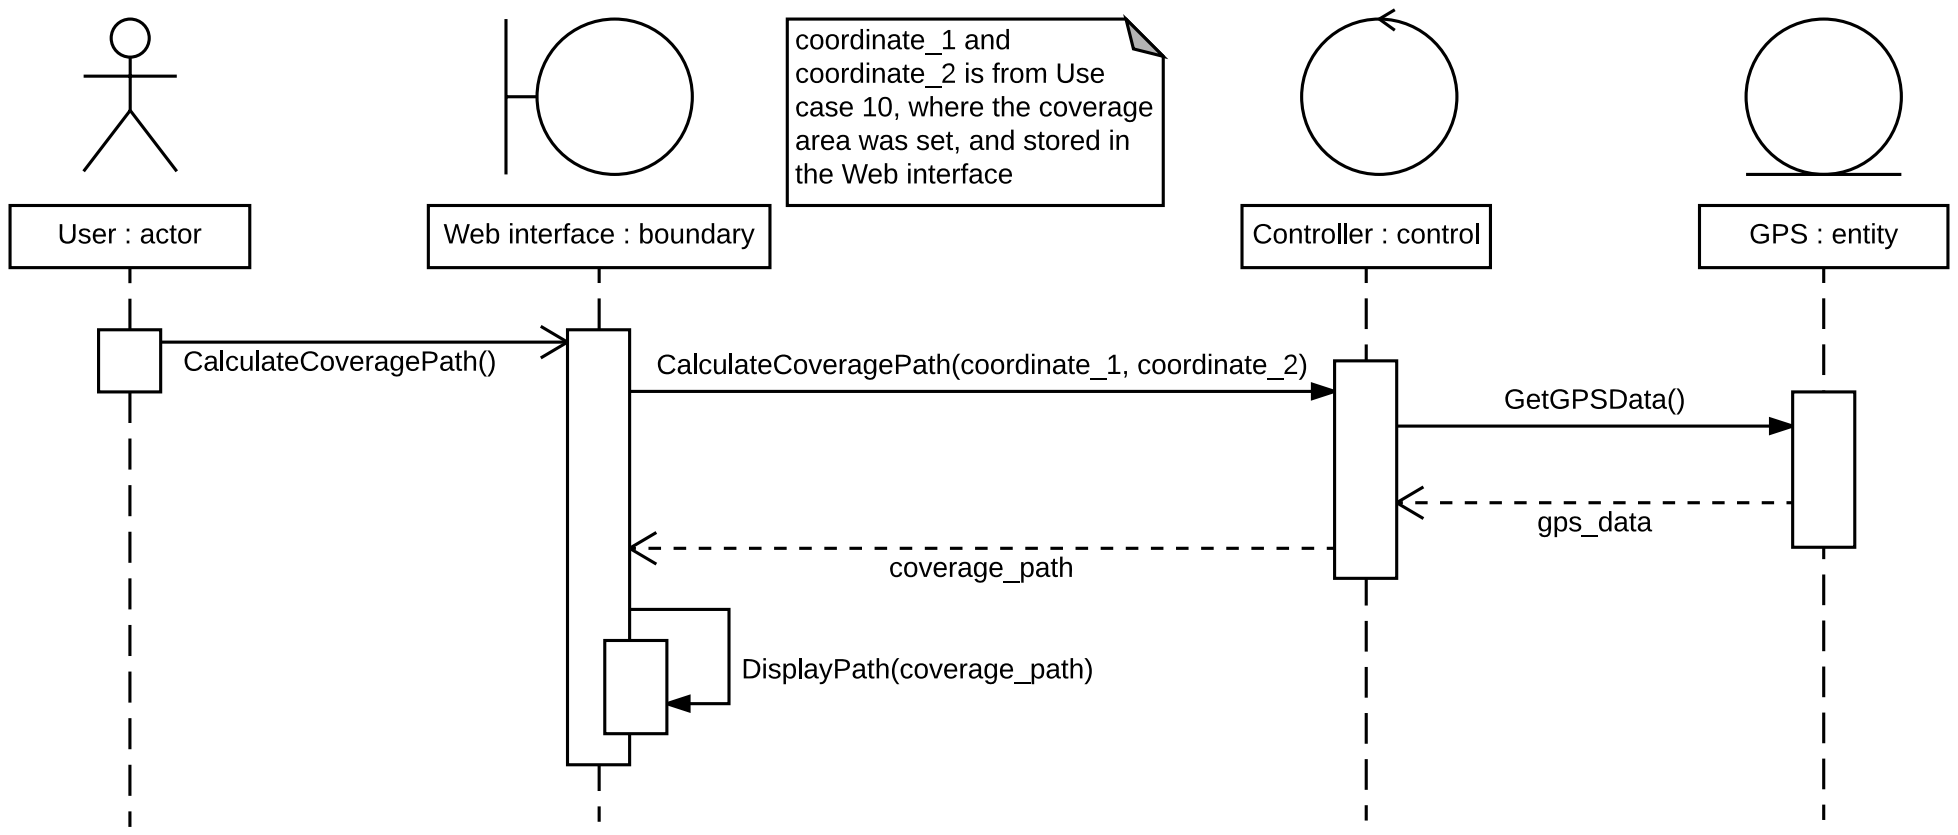
[picture p105: page 1]
