nicolaibonde/Boat-autopilot-documentation/Appendix/Project/Dokumentation/Images/System_architecture/Use_case_12_SD.pdf

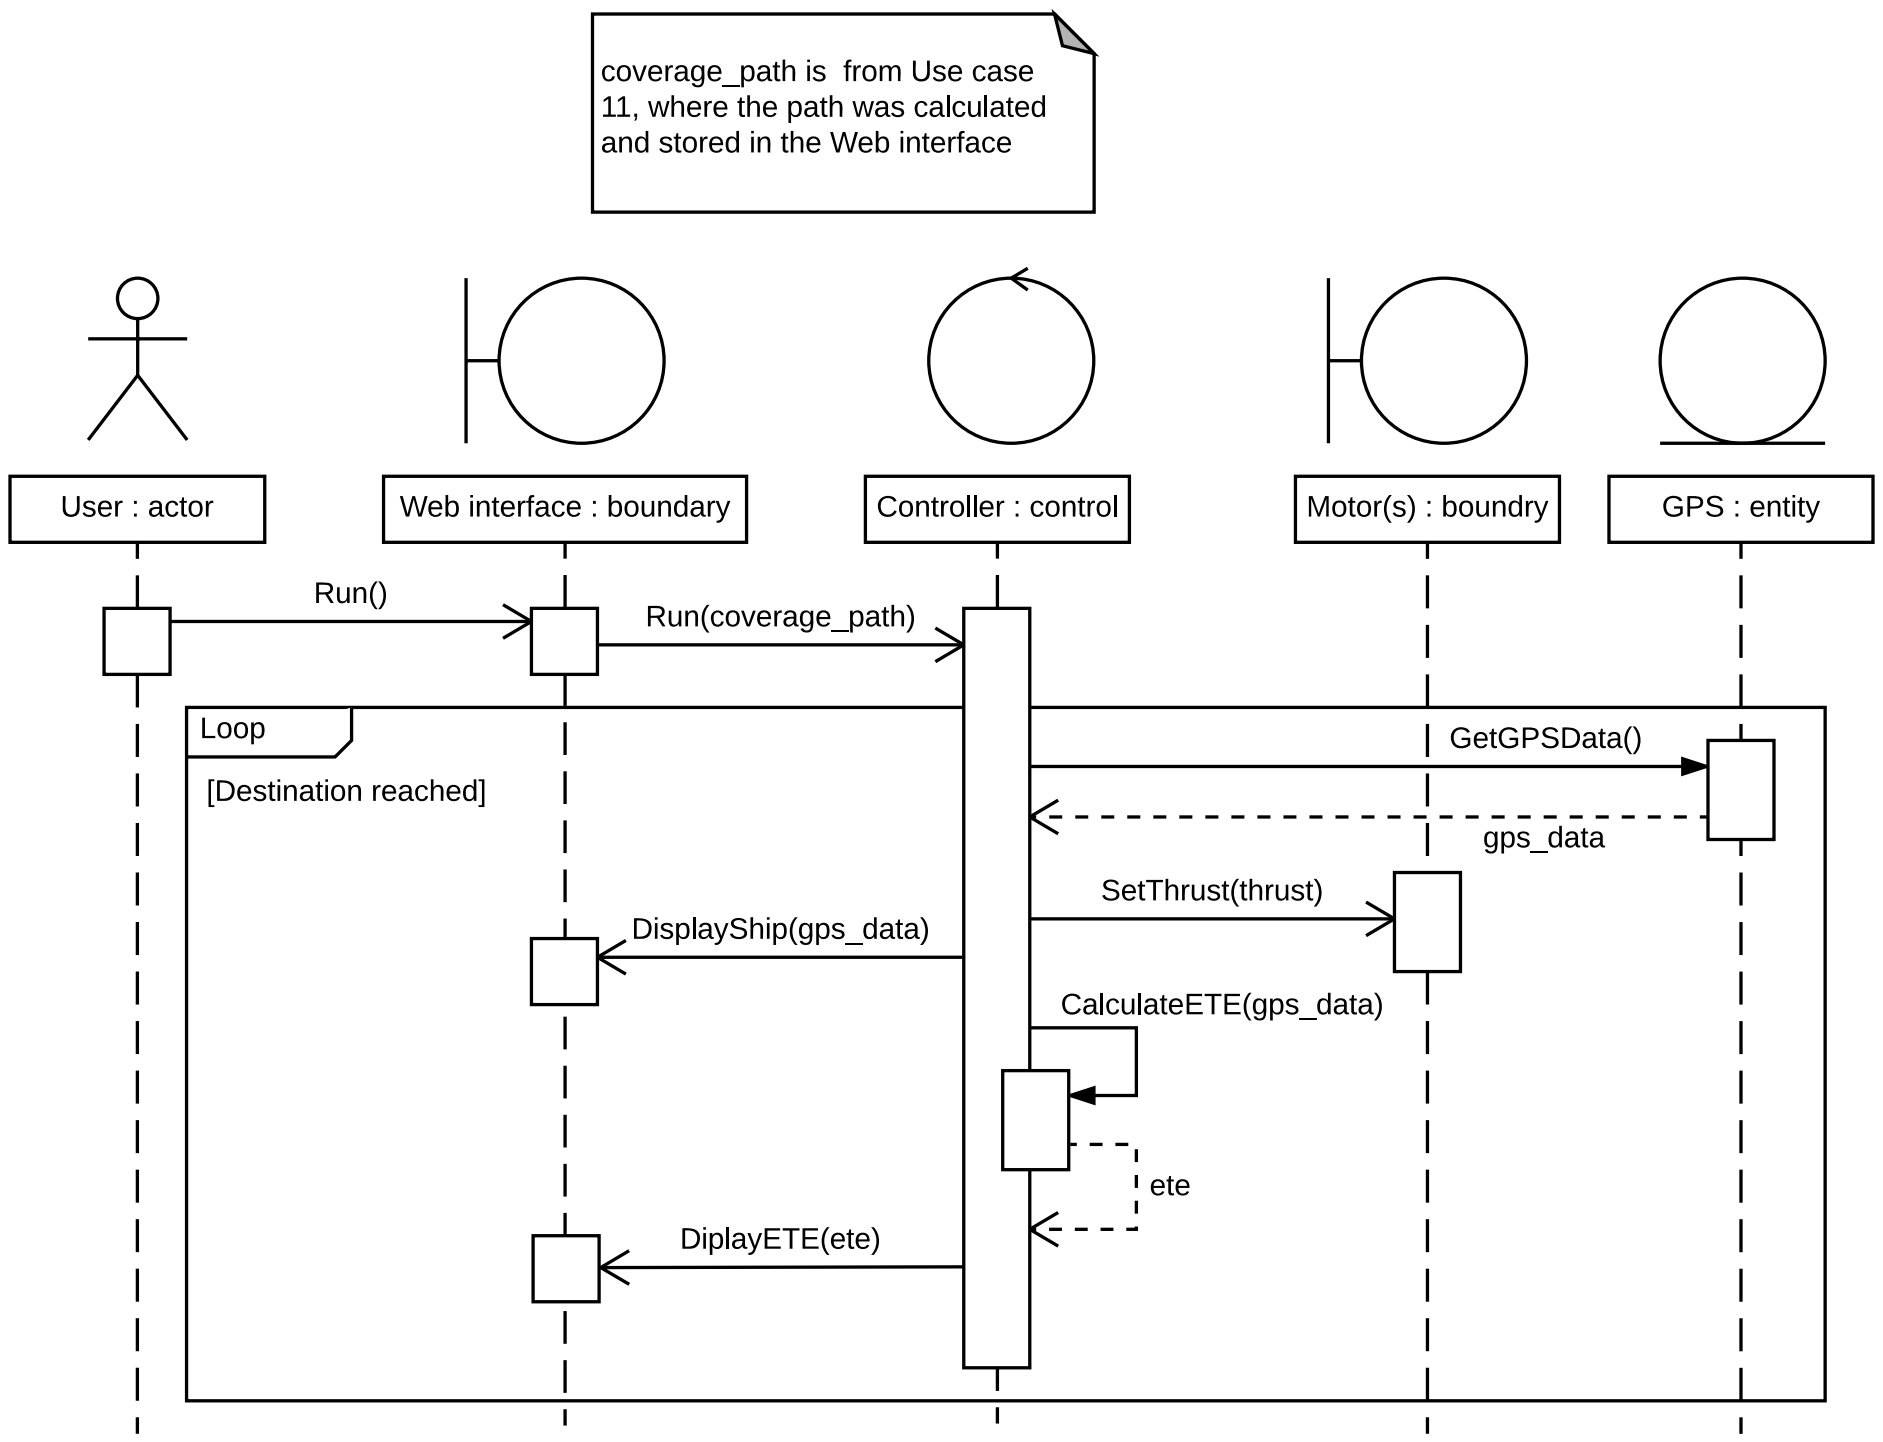
[picture p106: page 1]
