nicolaibonde/Boat-autopilot-documentation/Appendix/Project/Dokumentation/Images/System_architecture/Use_case_13_SD.pdf

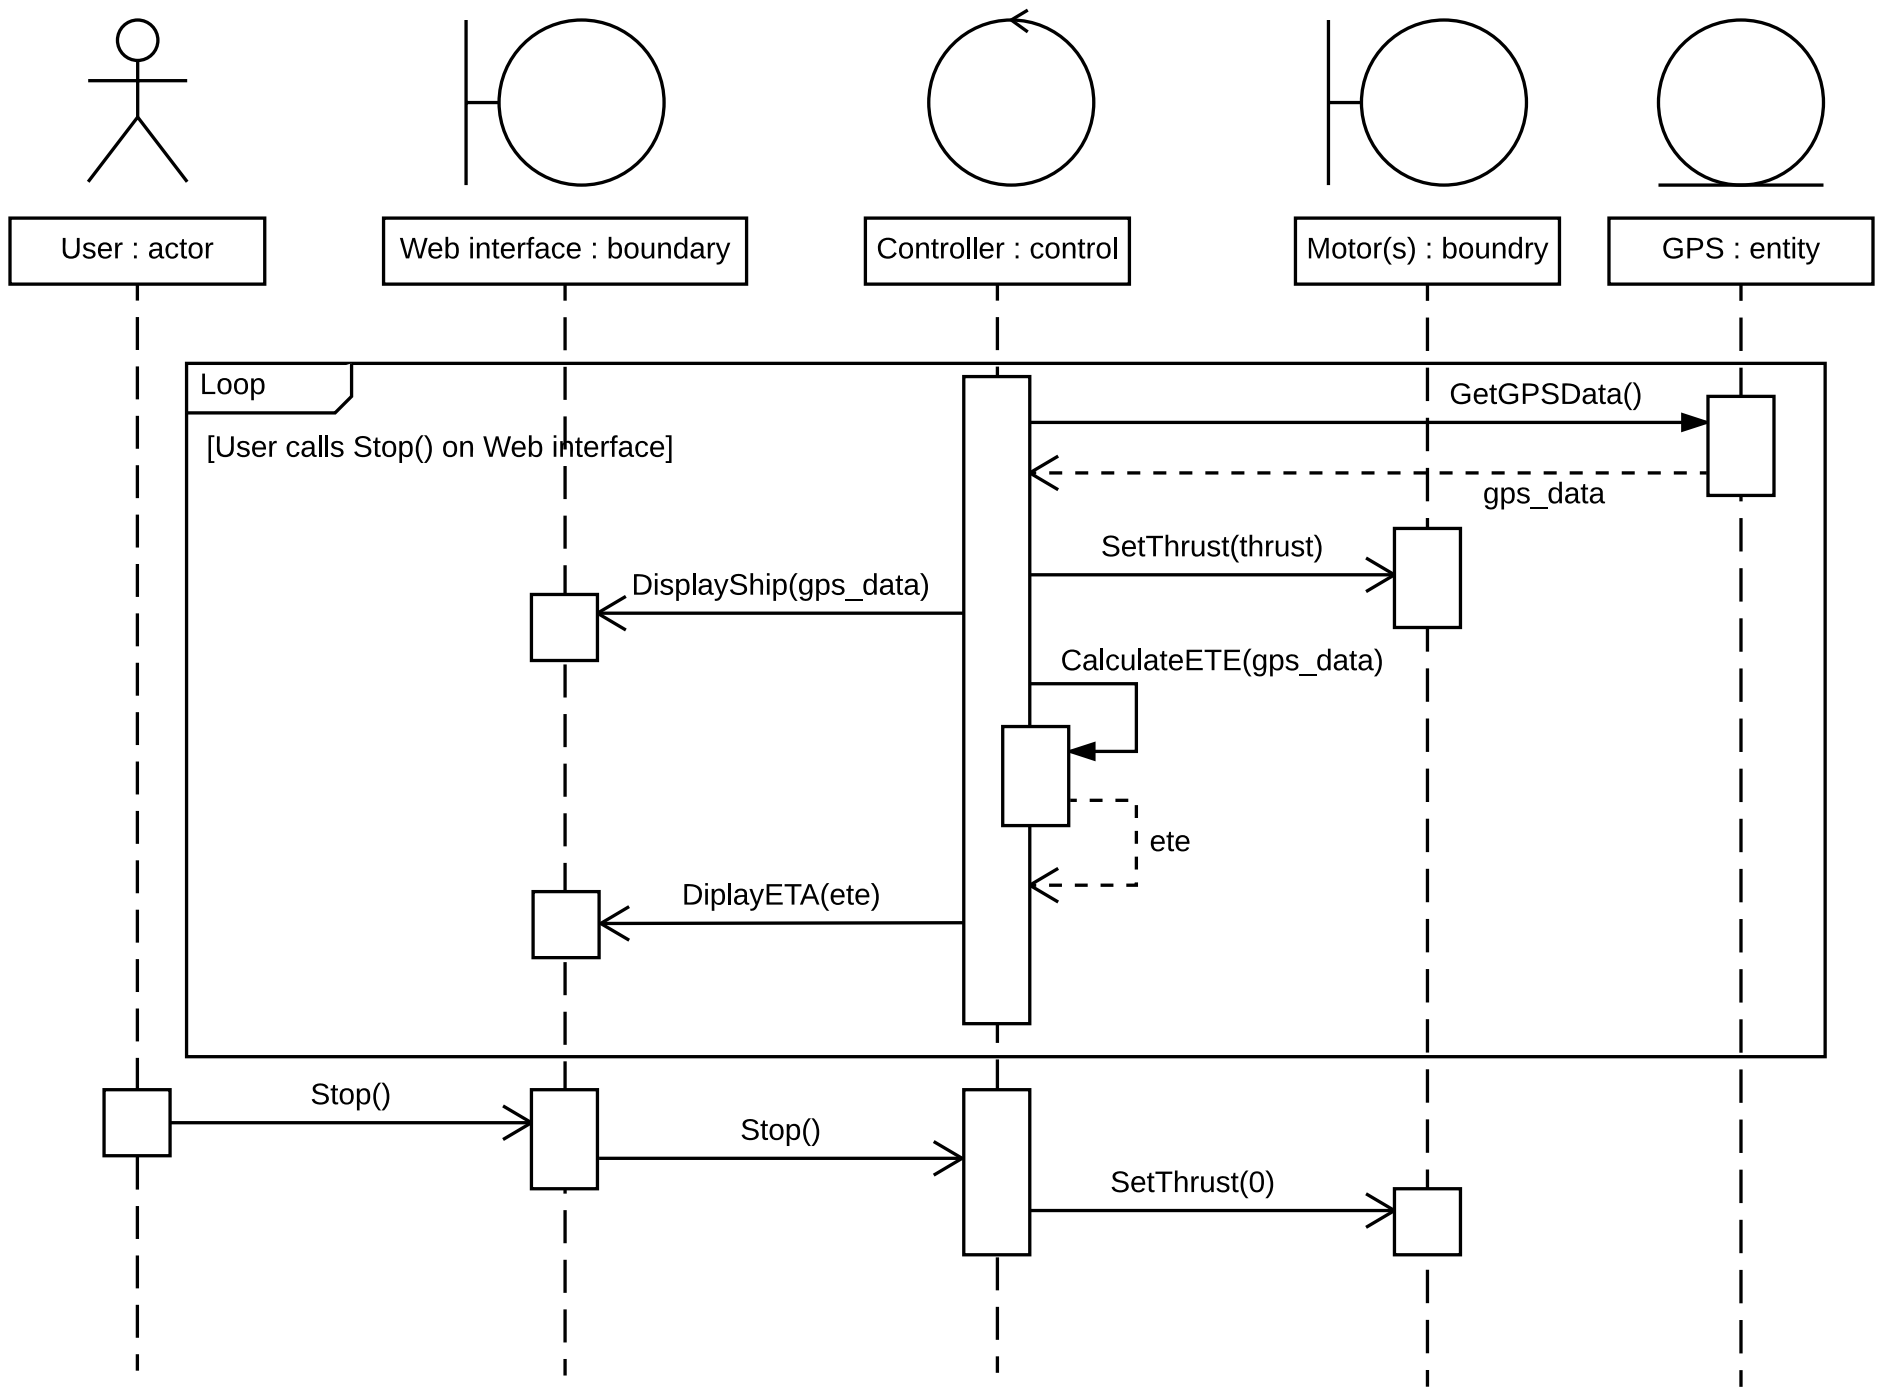
[picture p107: page 1]
