nicolaibonde/Boat-autopilot-documentation/Appendix/Project/Dokumentation/Images/System_architecture/Use_case_5_SD.pdf

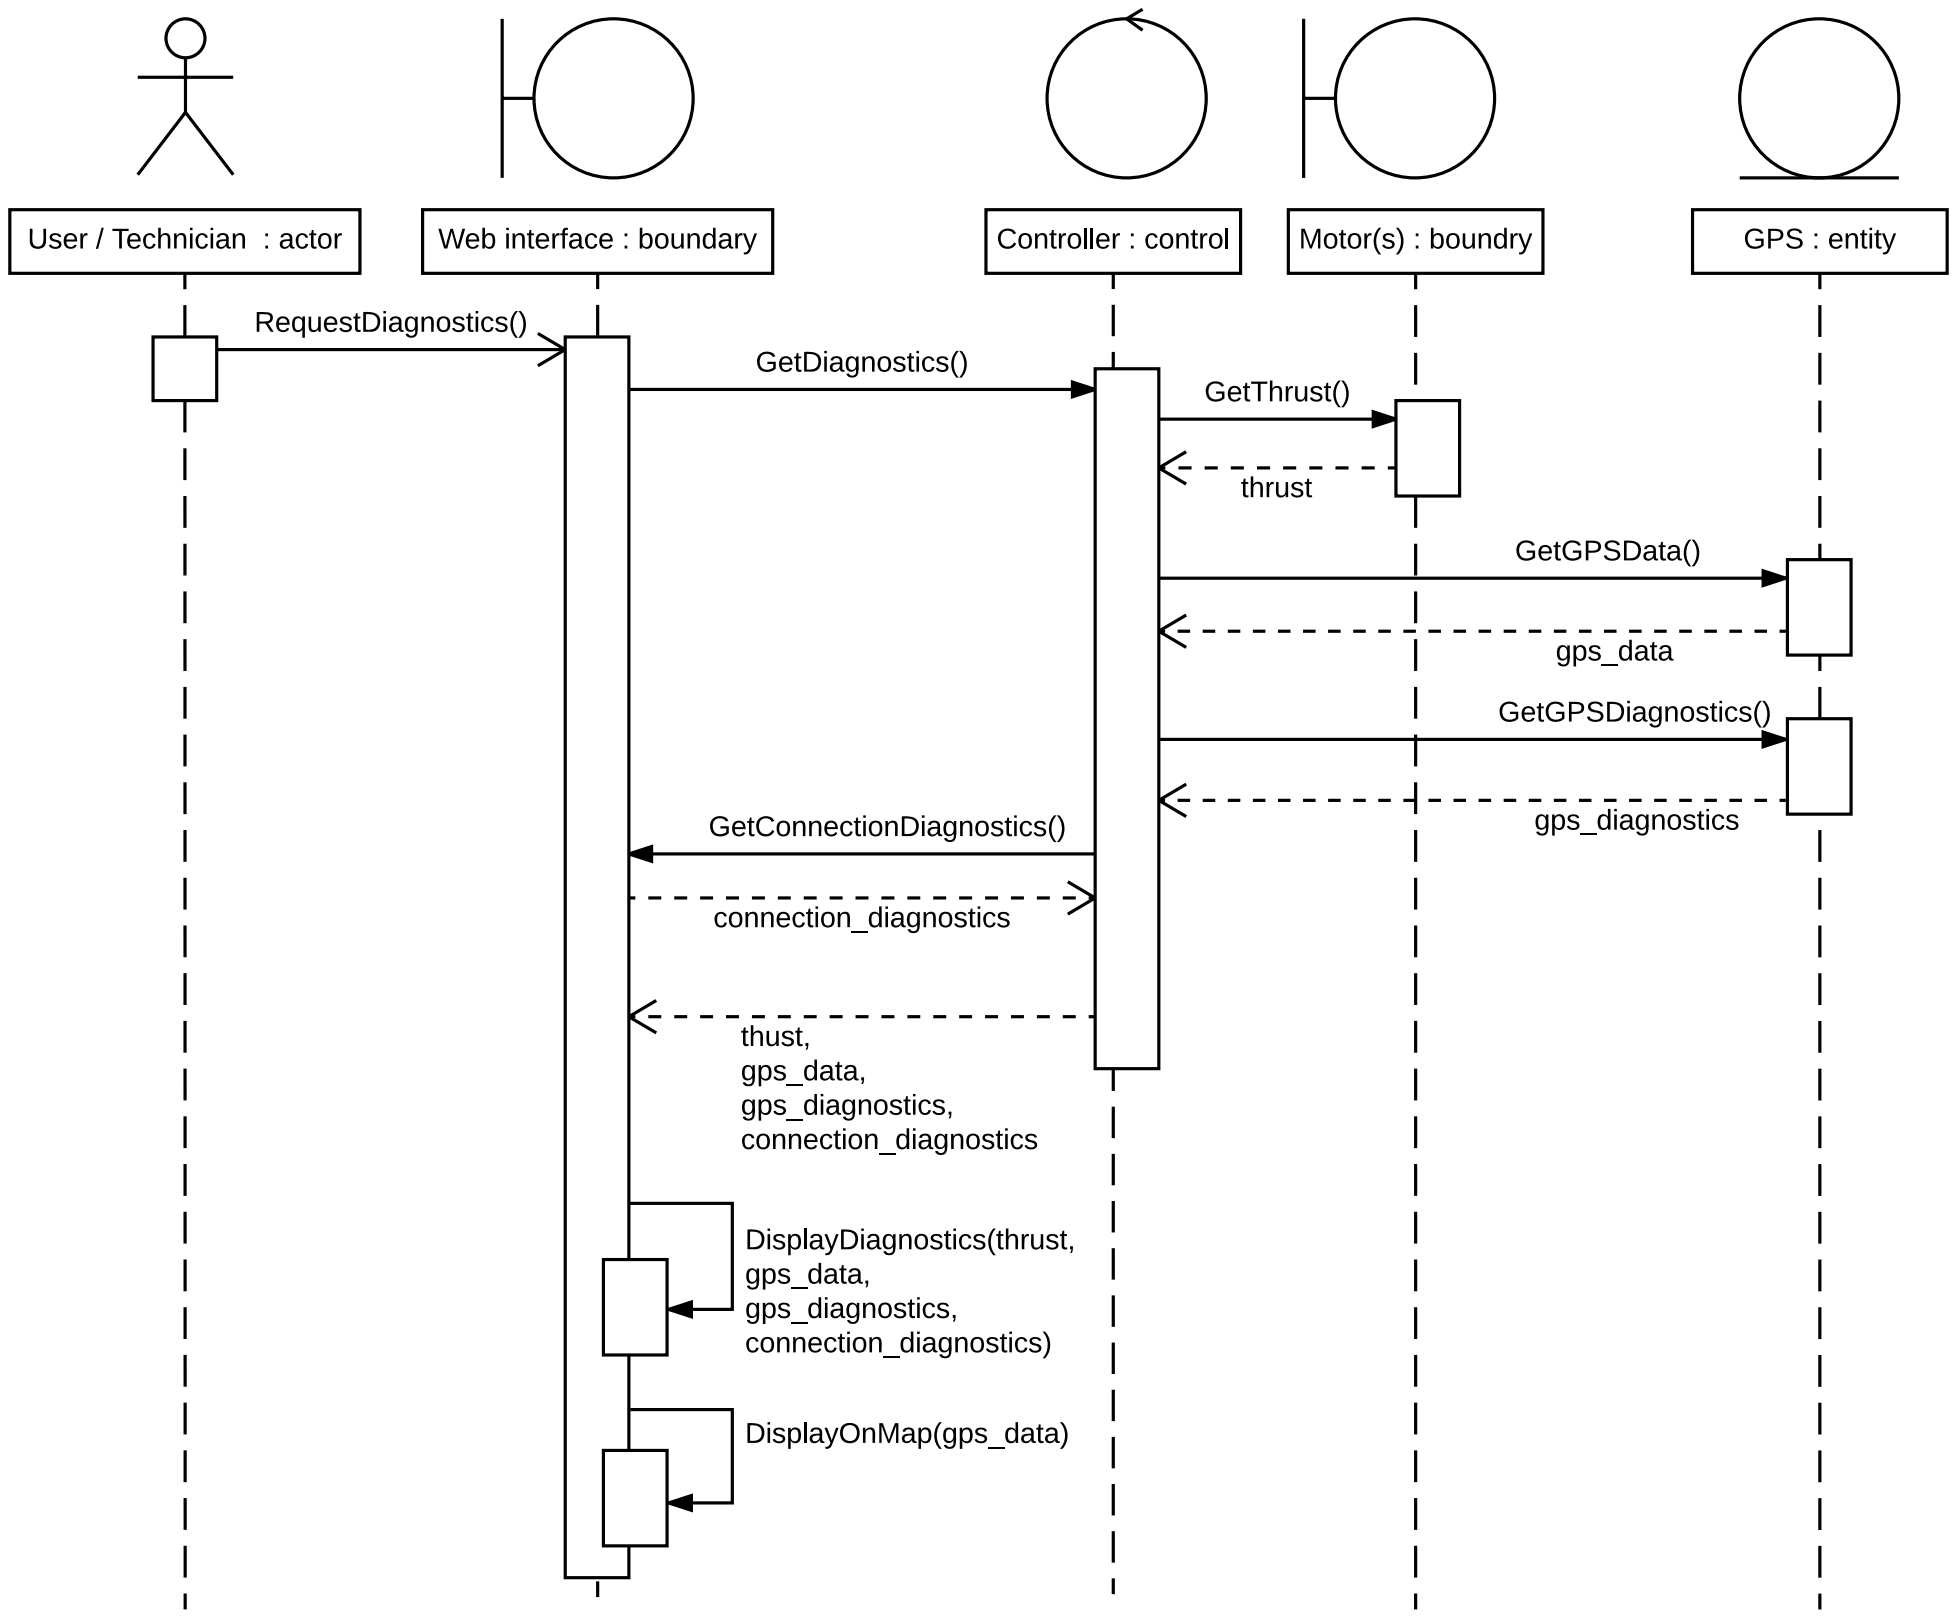
[picture p108: page 1]
