nicolaibonde/Boat-autopilot-documentation/Appendix/Project/Dokumentation/Images/System_architecture/Use_case_7_SD.pdf

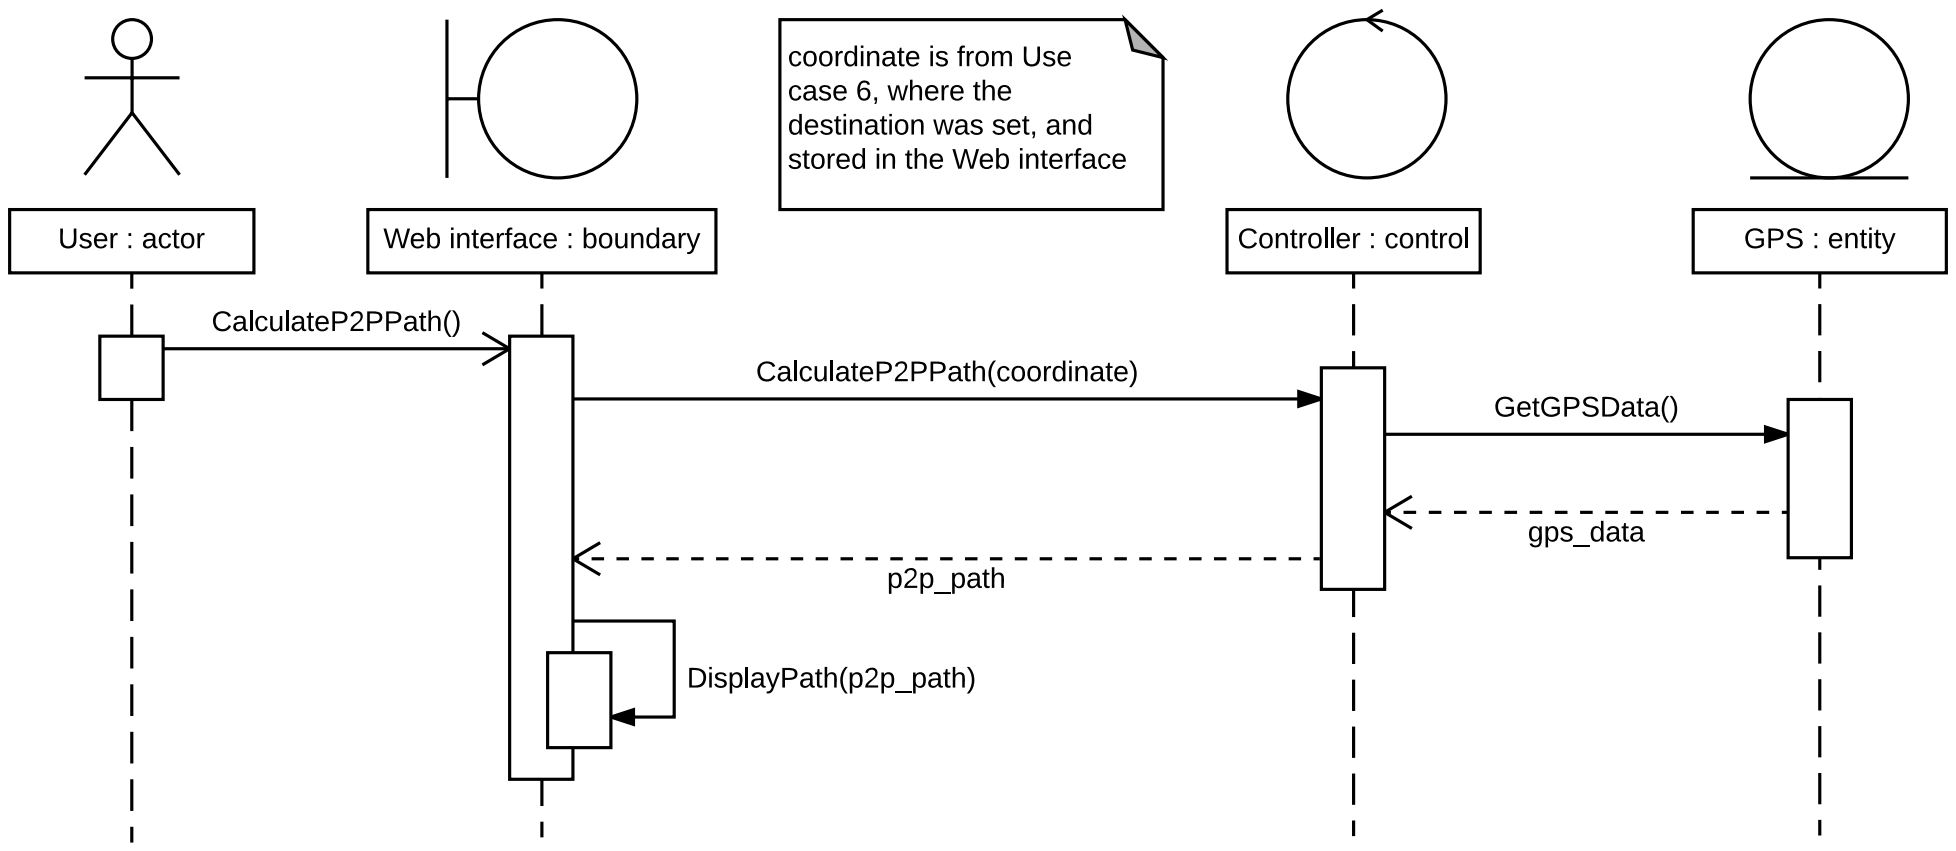
[picture p109: page 1]
