nicolaibonde/Boat-autopilot-documentation/Appendix/Project/Dokumentation/Images/Design/Helpers_class_diagram.pdf

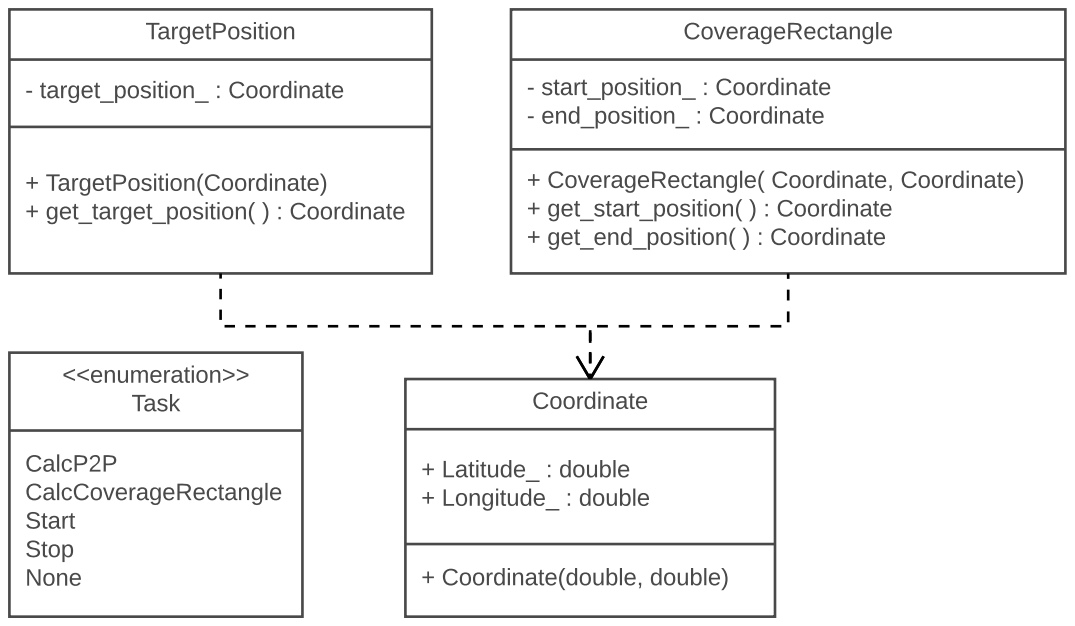
[picture p112: page 1]
<<enumeration>> Task; CalcP2P CalcCoverageRectangle Start Stop None; TargetPosition; - target_position_ : Coordinate; + TargetPosition(Coordinate) + get_target_position( ) : Coordinate; CoverageRectangle; - start_position_ : Coordinate - end_position_ : Coordinate; Coordinate; + Latitude_ : double + Longitude_ : double

+ CoverageRectangle( Coordinate, Coordinate)
+ get_start_position( ) : Coordinate
+ get_end_position( ) : Coordinate

+ Coordinate(double, double)
