nicolaibonde/Boat-autopilot-documentation/Appendix/Project/Dokumentation/Images/Design/Receiver_class_diagram.pdf

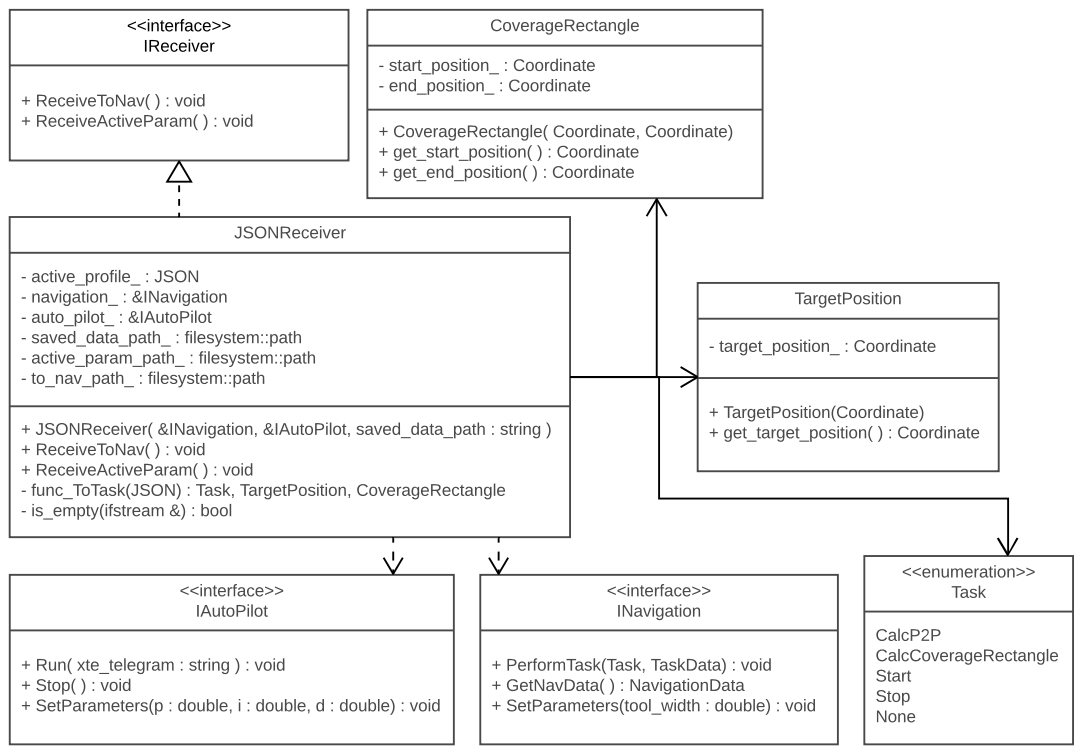
[picture p113: page 1]
JSONReceiver; - active_profile_ : JSON - navigation_ : &INavigation - auto_pilot_ : &IAutoPilot - saved_data_path_ : filesystem::path - active_param_path_ : filesystem::path - to_nav_path_ : filesystem::path; <<interface>> IReceiver; + ReceiveToNav( ) : void + ReceiveActiveParam( ) : void; <<interface>> IAutoPilot; <<interface>> INavigation; <<enumeration>> Task; CalcP2P CalcCoverageRectangle Start Stop None; TargetPosition; - target_position_ : Coordinate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

+ CoverageRectangle( Coordinate, Coordinate)
+ get_start_position( ) : Coordinate
+ get_end_position( ) : Coordinate

+ JSONReceiver( &INavigation, &IAutoPilot, saved_data_path : string )
+ ReceiveToNav( ) : void
+ ReceiveActiveParam( ) : void
- func_ToTask(JSON) : Task, TargetPosition, CoverageRectangle
- is_empty(ifstream &) : bool

+ Run( xte_telegram : string ) : void
+ Stop( ) : void
+ SetParameters(p : double, i : double, d : double) : void

+ PerformTask(Task, TaskData) : void
+ GetNavData( ) : NavigationData
+ SetParameters(tool_width : double) : void
