nicolaibonde/Boat-autopilot-documentation/Appendix/Project/Dokumentation/Images/Design/Transmitter_class_diagram.pdf

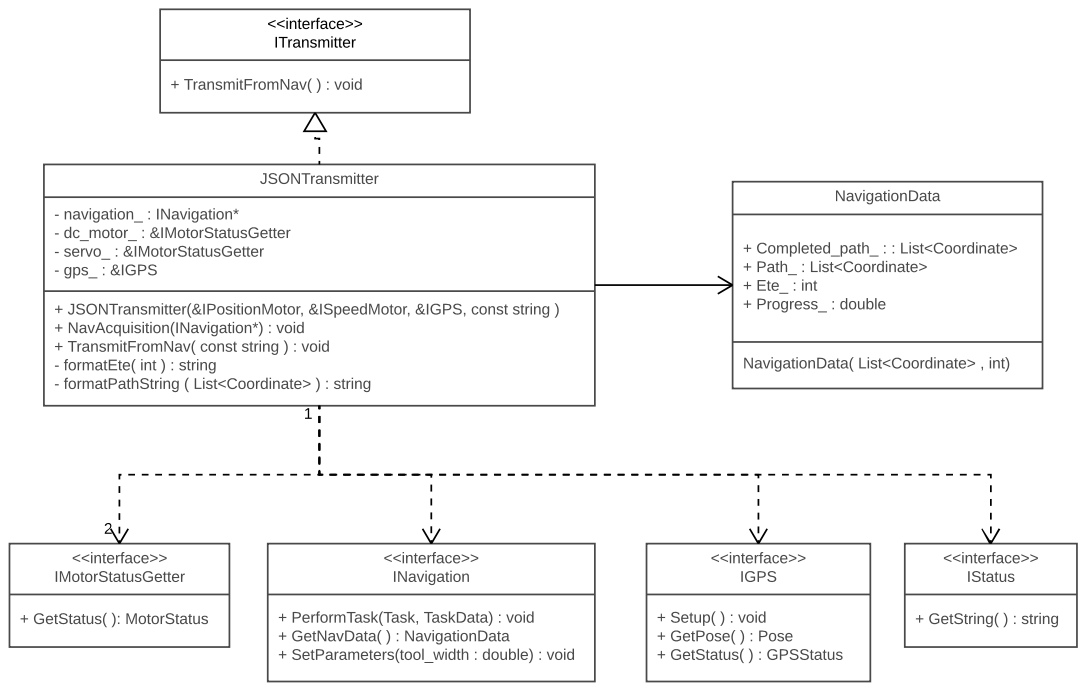
[picture p114: page 1]
JSONTransmitter; - navigation_ : INavigation* - dc_motor_ : &IMotorStatusGetter - servo_ : &IMotorStatusGetter - gps_ : &IGPS; <<interface>> ITransmitter; + TransmitFromNav( ) : void; <<interface>> IStatus; + GetString( ) : string; <<interface>> IGPS; + Setup( ) : void + GetPose( ) : Pose + GetStatus( ) : GPSStatus; <<interface>> INavigation; <<interface>> IMotorStatusGetter; + GetStatus( ): MotorStatus; NavigationData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

+ JSONTransmitter(&IPositionMotor, &ISpeedMotor, &IGPS, const string )
+ NavAcquisition(INavigation*) : void
+ TransmitFromNav( const string ) : void
- formatEte( int ) : string
- formatPathString ( List<Coordinate> ) : string

NavigationData( List<Coordinate> , int)

+ PerformTask(Task, TaskData) : void
+ GetNavData( ) : NavigationData
+ SetParameters(tool_width : double) : void
