nicolaibonde/Boat-autopilot-documentation/Appendix/Project/Dokumentation/Images/Design/ubloxNEO7M_class_diagram.pdf

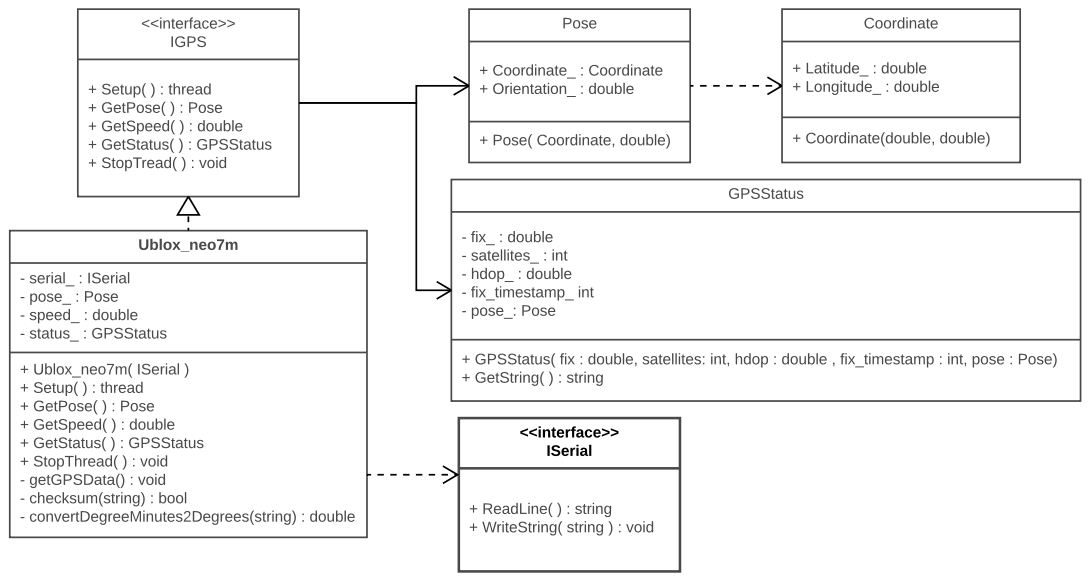
[picture p115: page 1]
Ublox_neo7m; - serial_ : ISerial - pose_ : Pose - speed_ : double - status_ : GPSStatus; <<interface>> ISerial; <<interface>> IGPS; + Setup( ) : thread + GetPose( ) : Pose + GetSpeed( ) : double + GetStatus( ) : GPSStatus + StopTread( ) : void; Pose; + Coordinate_ : Coordinate + Orientation_ : double; GPSStatus; - fix_ : double - satellites_ : int - hdop_ : double - fix_timestamp_ int - pose_: Pose; Coordinate; + Latitude_ : double + Longitude_ : double

+ Pose( Coordinate, double)

+ Coordinate(double, double)

+ GPSStatus( fix : double, satellites: int, hdop : double , fix_timestamp : int, pose : Pose)
+ GetString( ) : string

+ Ublox_neo7m( ISerial )
+ Setup( ) : thread
+ GetPose( ) : Pose
+ GetSpeed( ) : double
+ GetStatus( ) : GPSStatus
+ StopThread( ) : void
- getGPSData() : void
- checksum(string) : bool
- convertDegreeMinutes2Degrees(string) : double

+ ReadLine( ) : string
+ WriteString( string ) : void
