nicolaibonde/Boat-autopilot-documentation/Appendix/Project/Dokumentation/Images/System_architecture/General_BDD.pdf

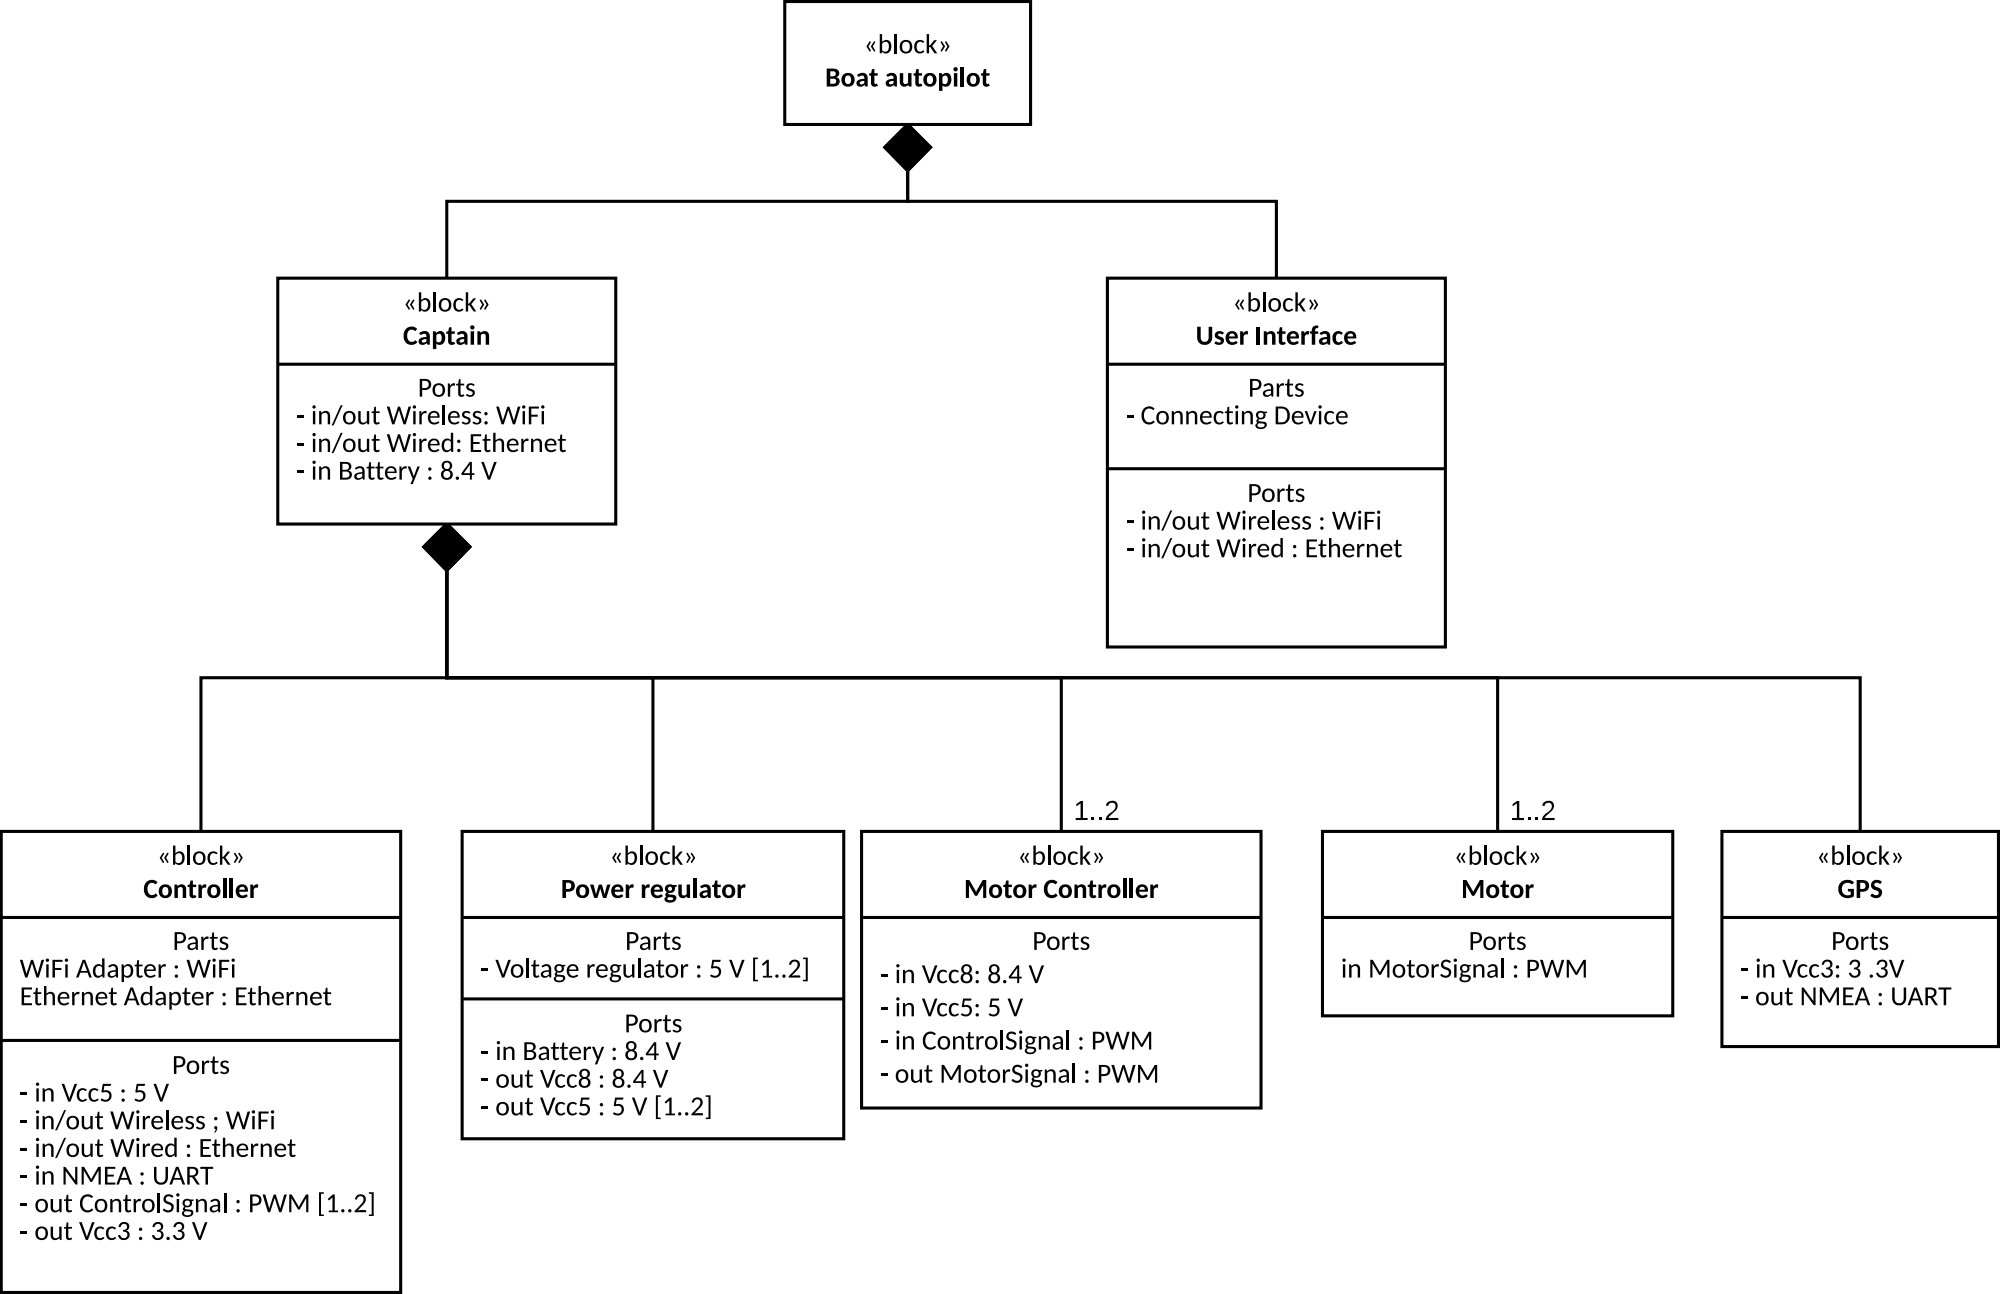
[picture p116: page 1]
