nicolaibonde/Boat-autopilot-documentation/Appendix/Project/Dokumentation/Images/System_architecture/General_IBD.pdf

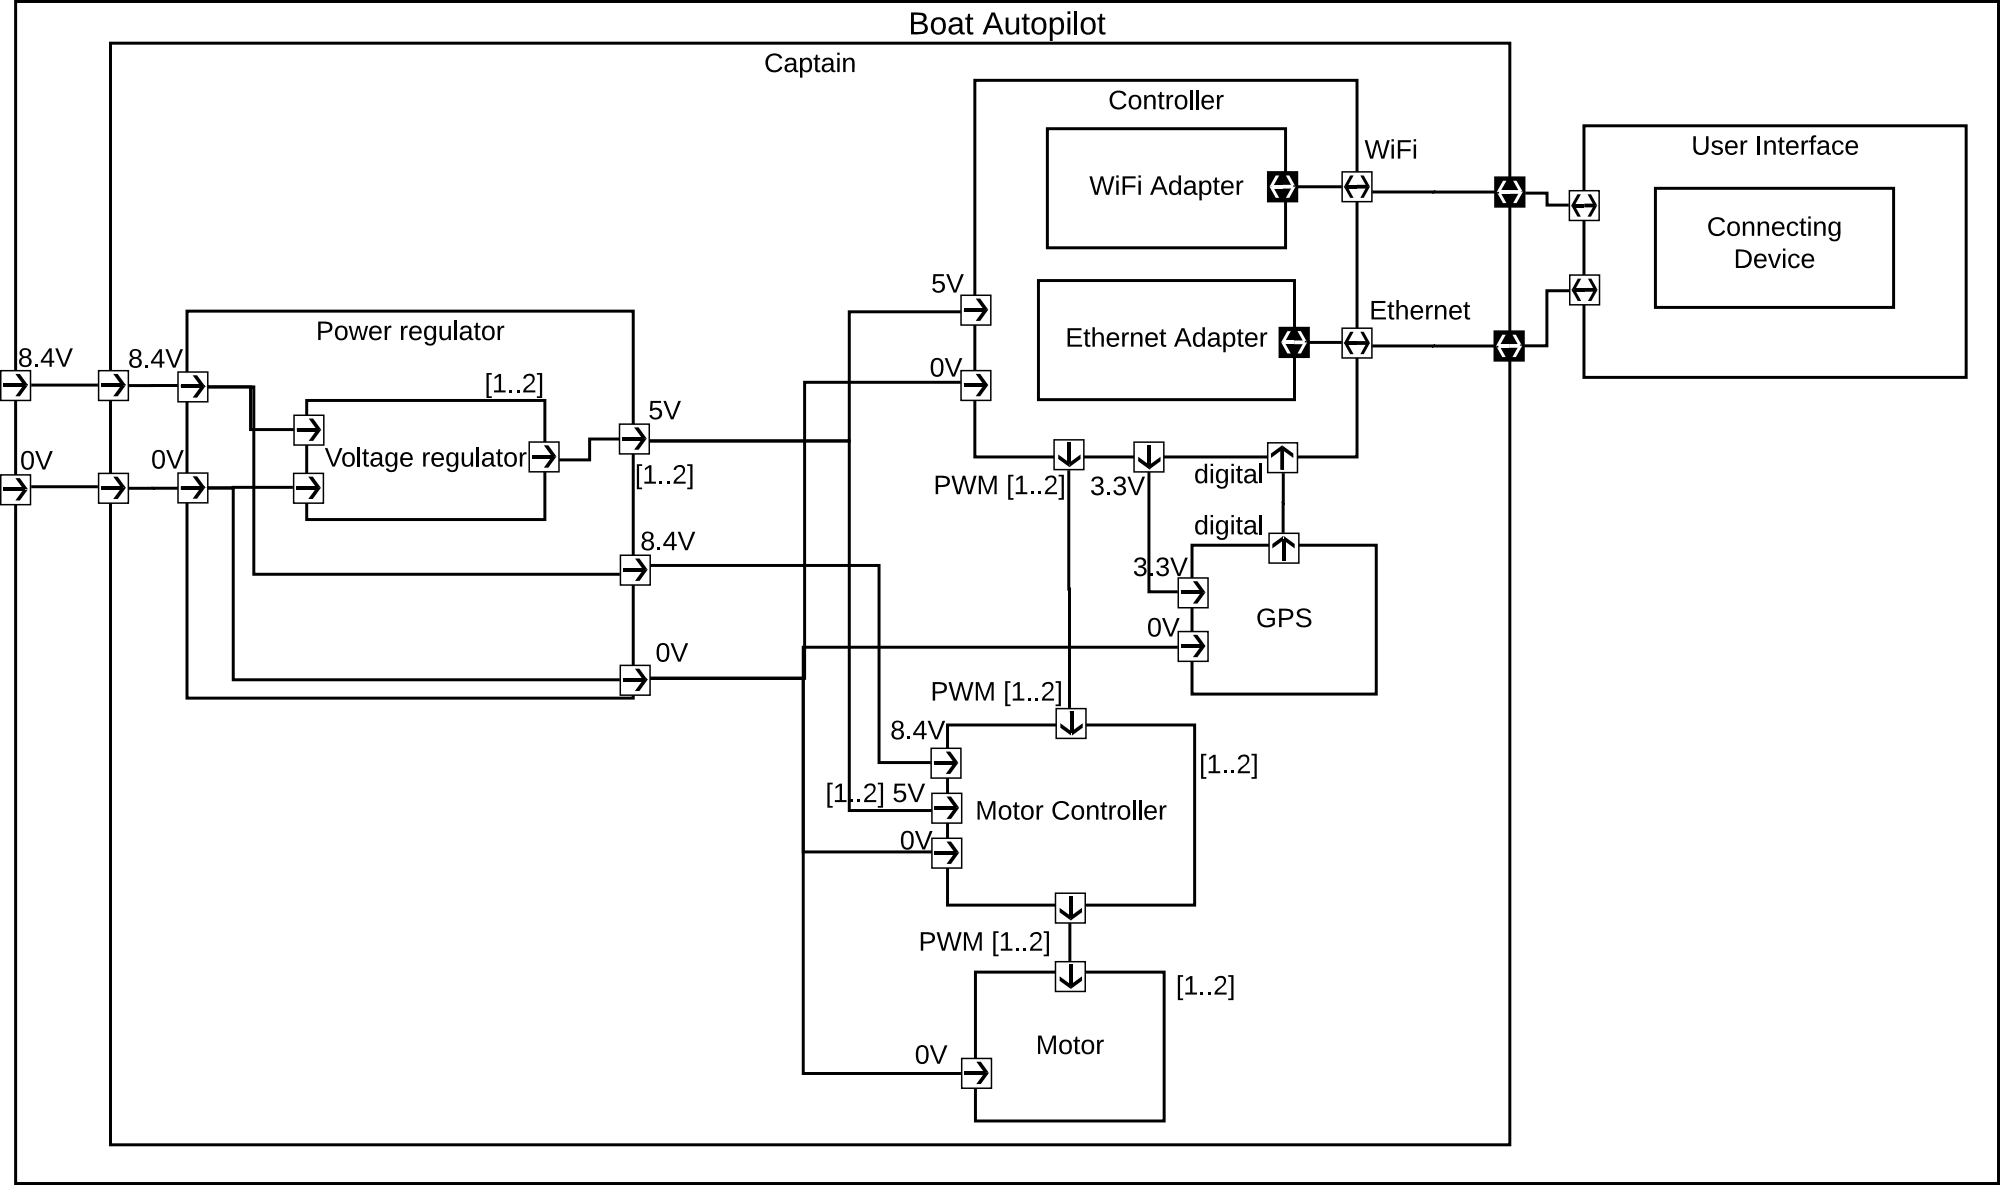
[picture p117: page 1]
