nicolaibonde/Boat-autopilot-documentation/Appendix/Project/Dokumentation/Images/Design/User_Interface_overview.pdf

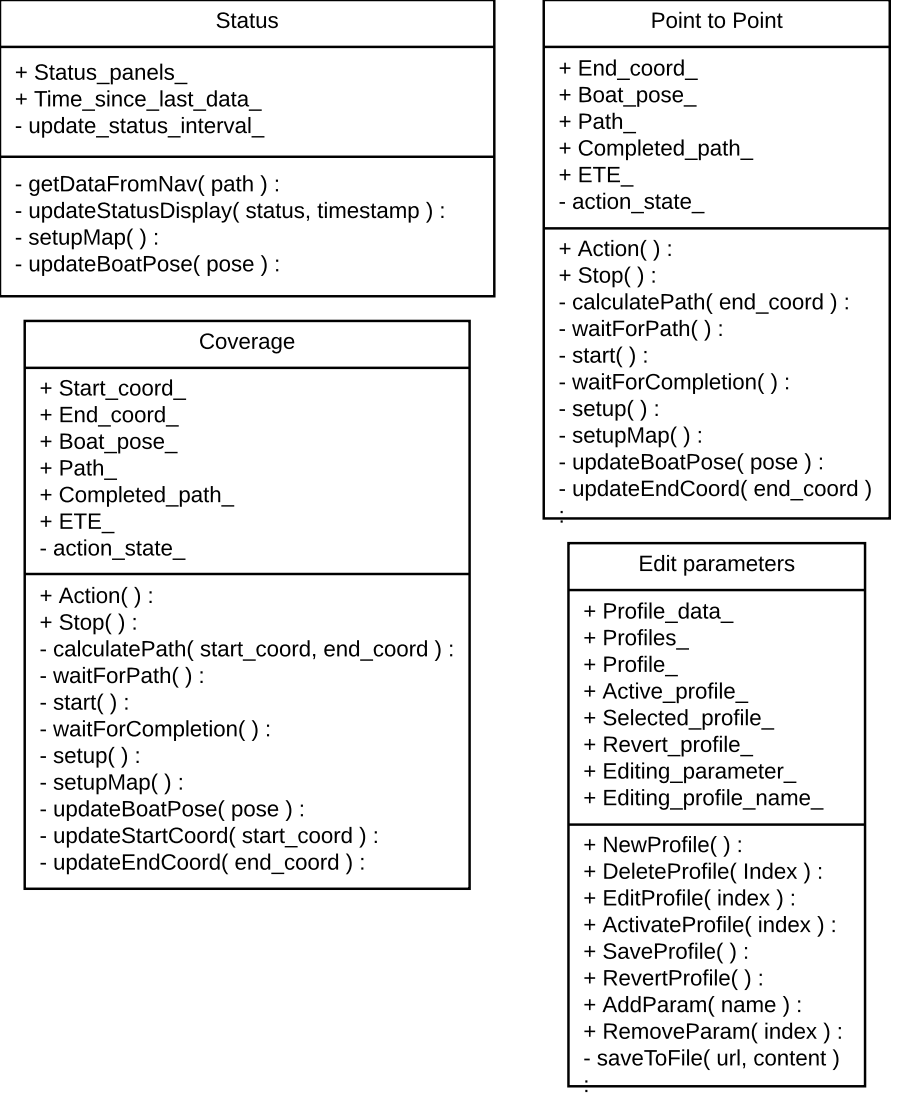
[picture p118: page 1]
Edit parameters; + Profile_data_ + Profiles_ + Profile_ + Active_profile_ + Selected_profile_ + Revert_profile_ + Editing_parameter_ + Editing_profile_name_; + NewProfile( ) : + DeleteProfile( Index ) : + EditProfile( index ) : + ActivateProfile( index ) : + SaveProfile( ) : + RevertProfile( ) : + AddParam( name ) : + RemoveParam( index ) : - saveToFile( url, content ) :; Status; + Status_panels_ + Time_since_last_data_ - update_status_interval_; Coverage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

Point to Point

- getDataFromNav( path ) :
- updateStatusDisplay( status, timestamp ) :
- setupMap( ) :
- updateBoatPose( pose ) :
