nicolaibonde/Boat-autopilot-documentation/Appendix/Project/Dokumentation/Images/System_architecture/Use_case_10_SD.pdf

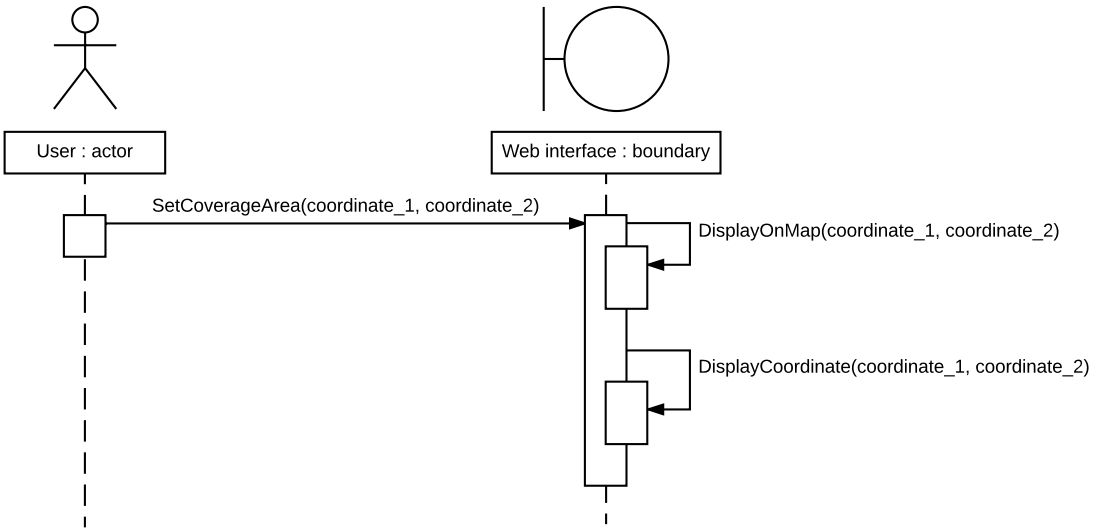
[picture p119: page 1]
User : actor; Web interface : boundary; SetCoverageArea(coordinate_1, coordinate_2); DisplayOnMap(coordinate_1, coordinate_2); DisplayCoordinate(coordinate_1, coordinate_2)
