nicolaibonde/Boat-autopilot-documentation/Appendix/Project/Dokumentation/Images/System_architecture/Use_case_1_SD.pdf

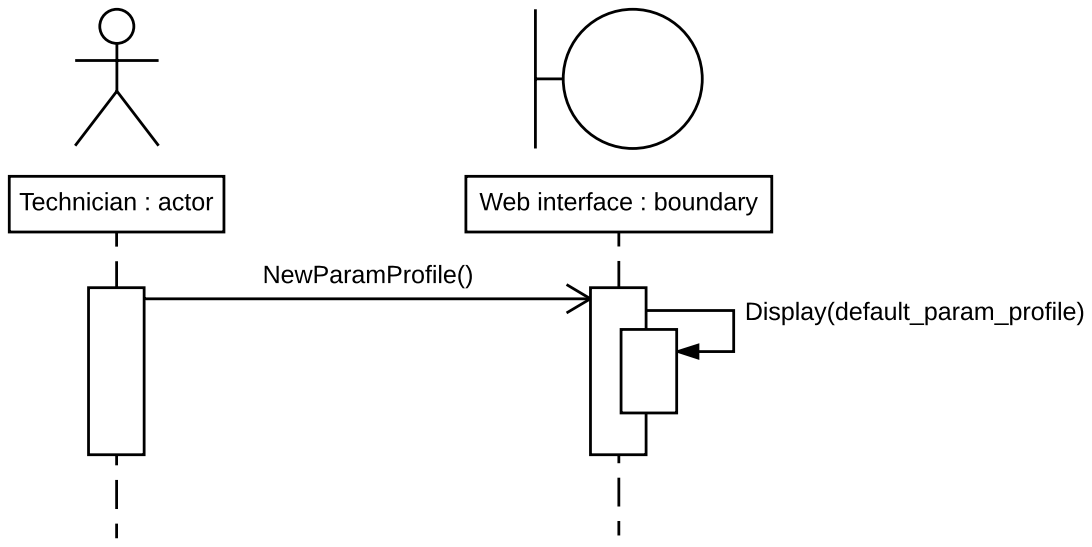
[picture p120: page 1]
Technician : actor; Web interface : boundary; NewParamProfile(); Display(default_param_profile)
