nicolaibonde/Boat-autopilot-documentation/Appendix/Project/Dokumentation/Images/System_architecture/Use_case_2_SD.pdf

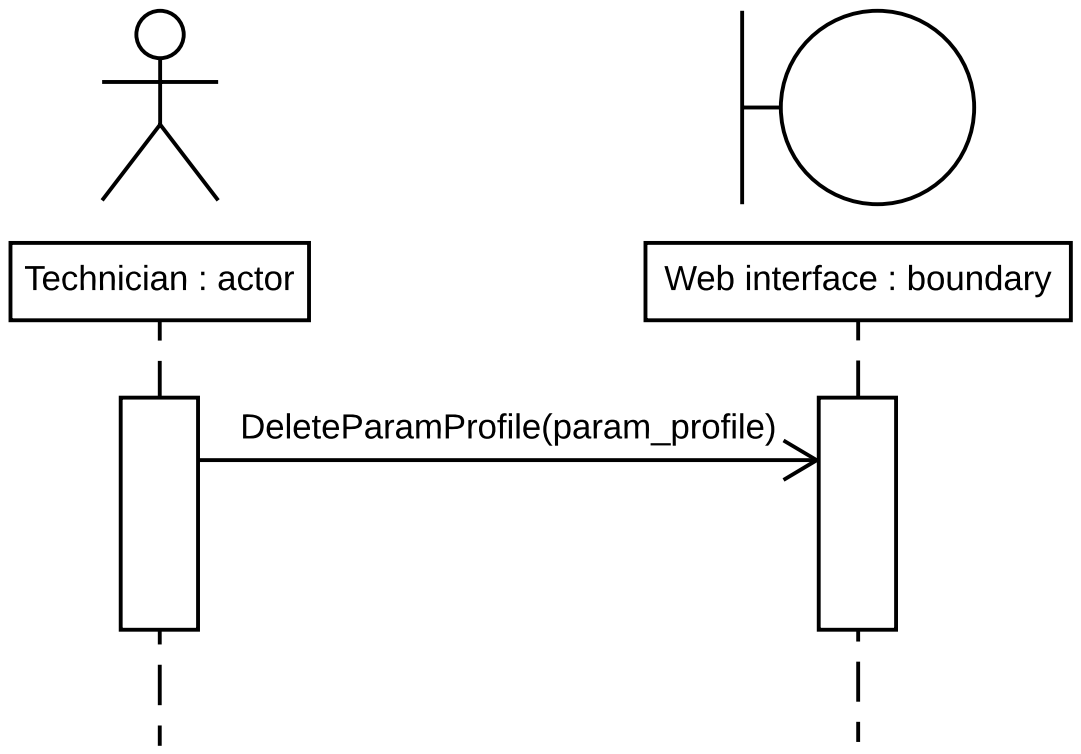
[picture p121: page 1]
Technician : actor; Web interface : boundary; DeleteParamProfile(param_profile)
