nicolaibonde/Boat-autopilot-documentation/Appendix/Project/Dokumentation/Images/System_architecture/Use_case_3_SD.pdf

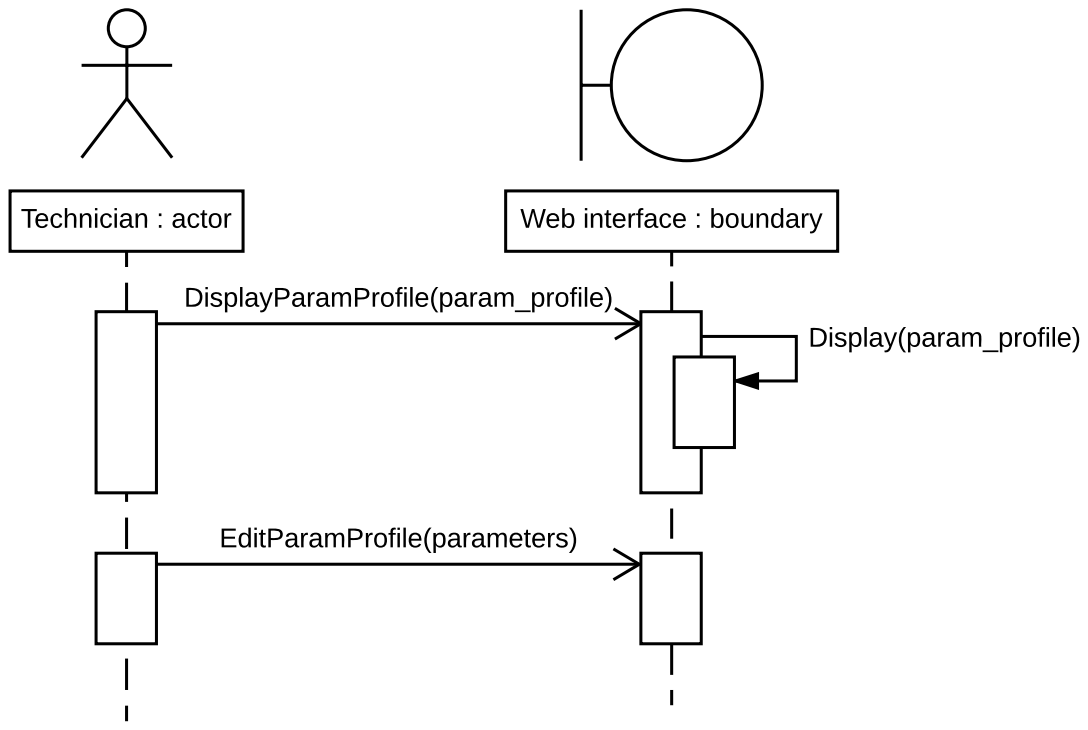
[picture p122: page 1]
Technician : actor; Web interface : boundary; DisplayParamProfile(param_profile); Display(param_profile); EditParamProfile(parameters)
