nicolaibonde/Boat-autopilot-documentation/Appendix/Project/Dokumentation/Images/System_architecture/Use_case_4_SD.pdf

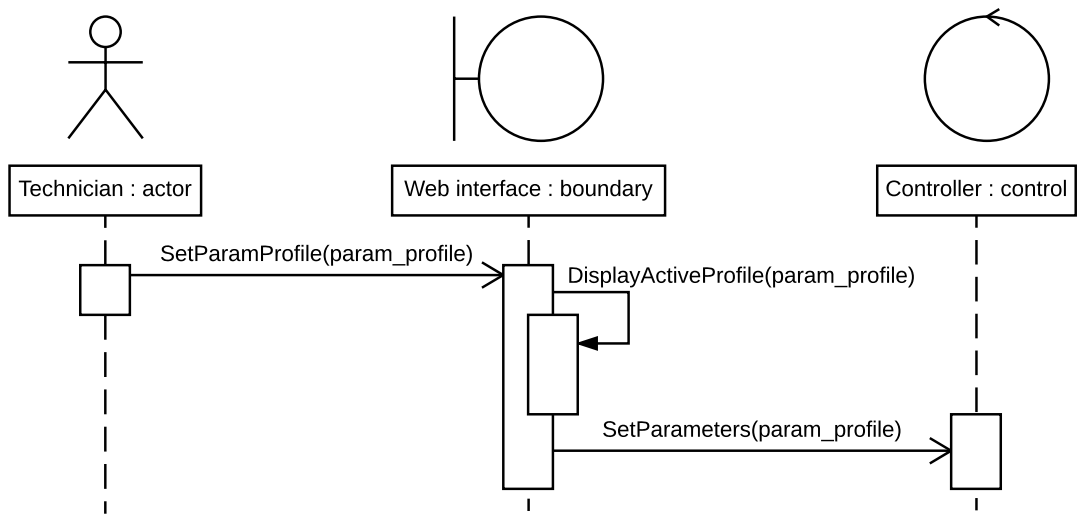
[picture p123: page 1]
Technician : actor; Web interface : boundary; Controller : control; SetParamProfile(param_profile); DisplayActiveProfile(param_profile); SetParameters(param_profile)
