nicolaibonde/Boat-autopilot-documentation/Appendix/Project/Dokumentation/Images/System_architecture/Use_case_6_SD.pdf

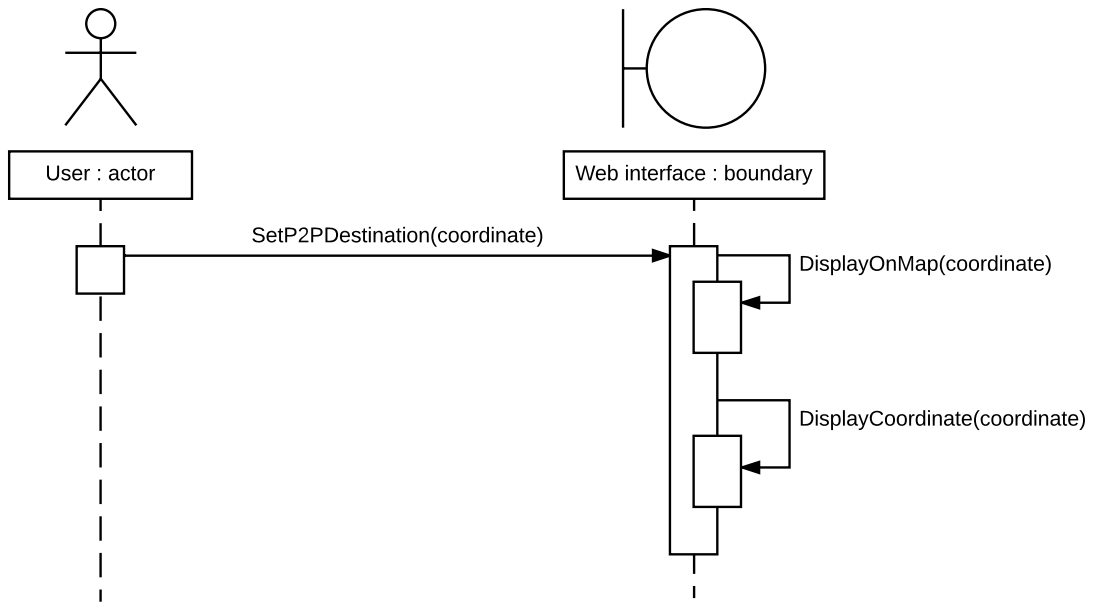
[picture p124: page 1]
User : actor; Web interface : boundary; SetP2PDestination(coordinate); DisplayOnMap(coordinate); DisplayCoordinate(coordinate)
