nicolaibonde/Boat-autopilot-documentation/Appendix/Project/Dokumentation/Images/Requirements_specification/UI_Mockup_Coverage.pdf

## Coverage

# Captain Autopilot Control Center

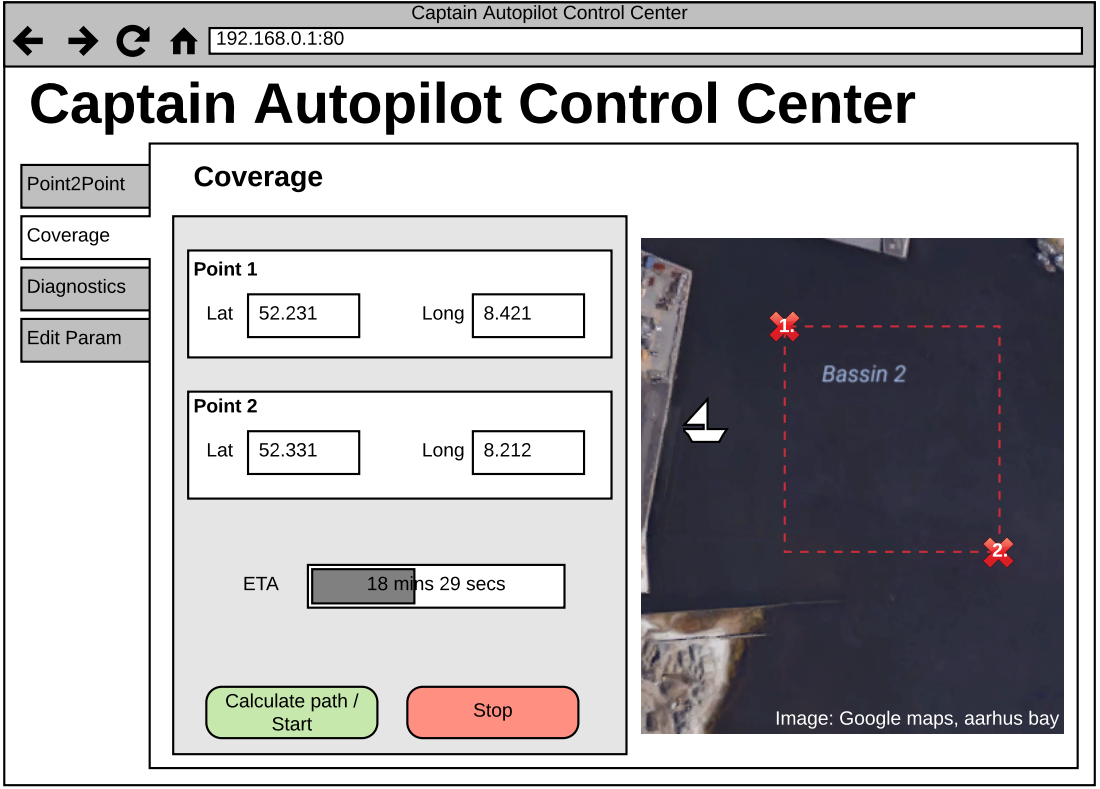
[picture p125: page 1]
Point2Point; Coverage; Diagnostics; Edit Param; Point 1; Lat 52.231; Long 8.421; Point 2; Lat 52.331; Long 8.212; ETA; 18 mins 29 secs; Calculate path / Start; Stop; Image: Google maps, aarhus bay

Captain Autopilot Control Center
