nicolaibonde/Boat-autopilot-documentation/Appendix/Project/Dokumentation/Images/Requirements_specification/UI_Mockup_Point_to_point.pdf

## Point2Point

# Captain Autopilot Control Center

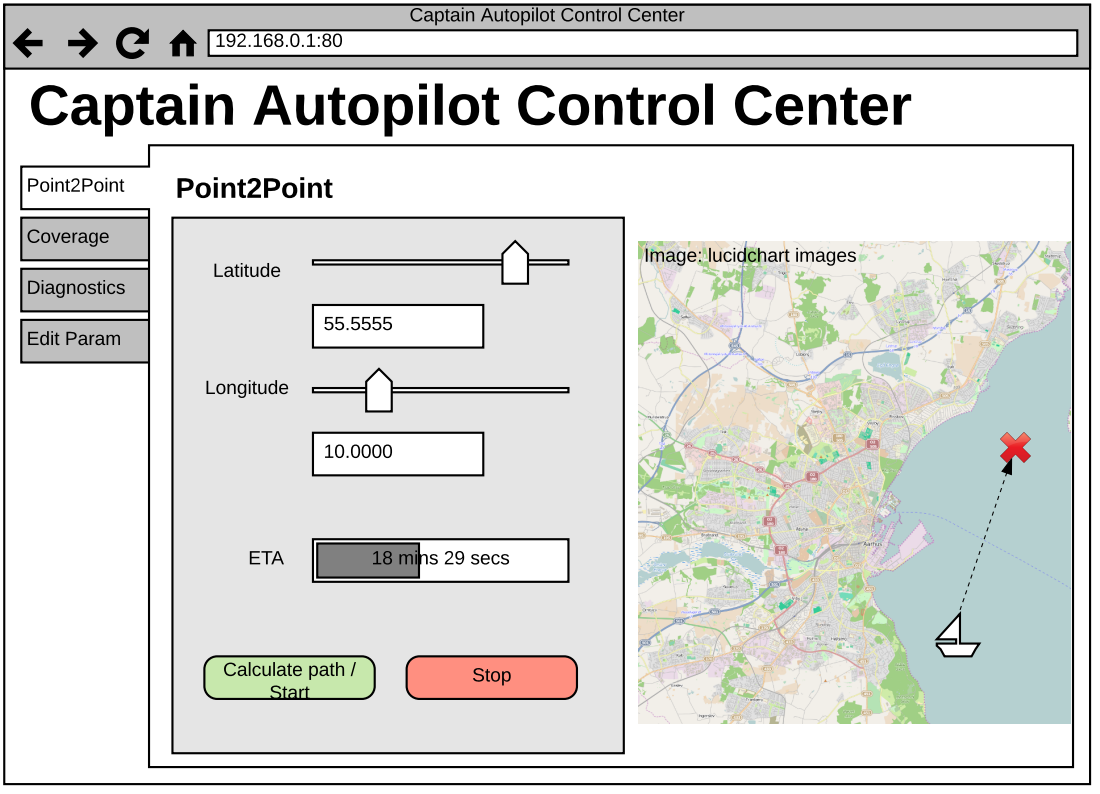
[picture p126: page 1]
Lat; Point2Point; Coverage; Diagnostics; Edit Param; Longitude; ETA; 18 mins 29 secs; Latitude; Calculate path / Start; Stop

Captain Autopilot Control Center

Image: lucidchart images
