nicolaibonde/Boat-autopilot-documentation/Appendix/Project/Dokumentation/Images/Requirements_specification/Actor_context_diagram.pdf

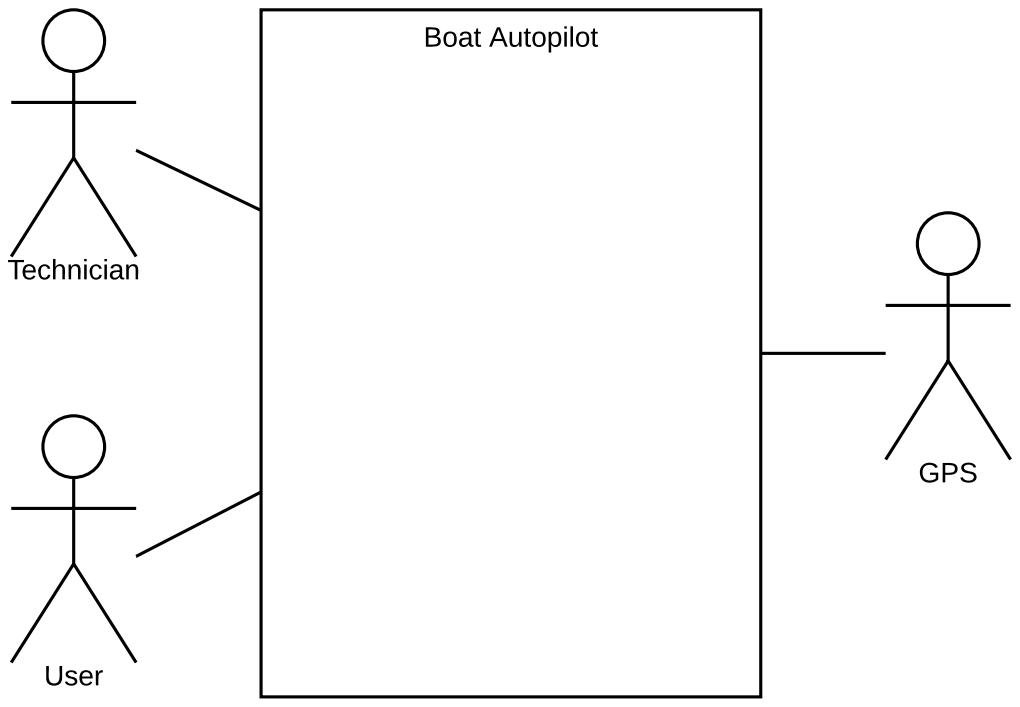
[picture p127: page 1]
Boat Autopilot; Technician; GPS; User
