nicolaibonde/Boat-autopilot-documentation/Appendix/Project/Dokumentation/Images/Requirements_specification/Usecase_diagram.pdf

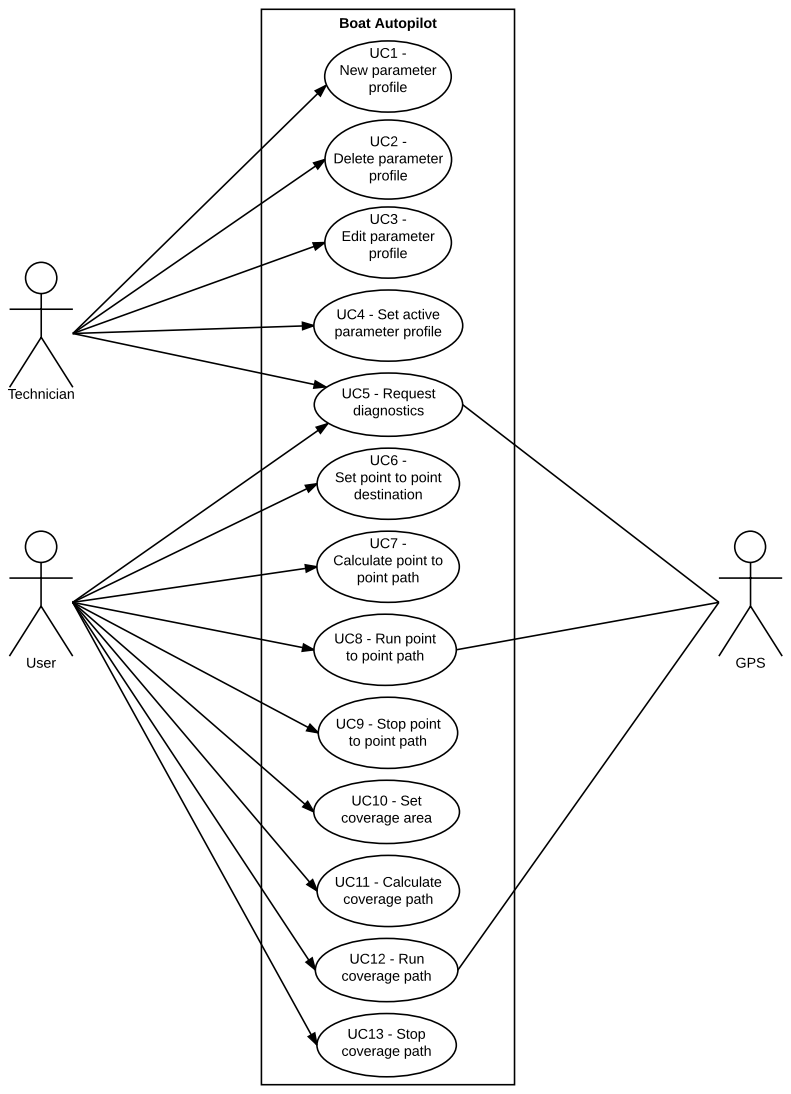
[picture p128: page 1]
Boat Autopilot; Technician; User; GPS; UC1 - New parameter; profile; UC3 - Edit parameter profile; UC4 - Set active parameter profile; UC10 - Set coverage area; UC11 - Calculate coverage path; UC12 - Run coverage path; UC13 - Stop coverage path; UC5 - Request diagnostics; UC2 - Delete parameter; point path

Set point to point
destination

UC7 - Calculate point to

UC8 - Run point
to point path

UC9 - Stop point
