nicolaibonde/Boat-autopilot-documentation/(list of files, drawings)

Other design files:
Appendix/Project/Design/Motor driver circuit/Motor_driver_circuit.ms14
Appendix/Project/Design/Regulator/Voltage_regulators.ms14
Appendix/Project/Design/Servo driver circuit/Servo driver circuit.ms14
