nicolaibonde/Boat-autopilot-documentation/(commit log)

2017-08-30 Use case diagram updated
2017-09-01 Updated extension and alternate flow in requirement specification
2017-09-18 Board candidates
    [Board_candidates.csv]
2017-09-20 GPS candidates
    Wrote GPS candidates, edited requirements specification and system architecture
    [Board_candidates.csv]
2017-09-20 Board candidates xslx file
    [Board_candidates.xlsx]
2017-09-26 Motor measurement data
    [Bat_servo_no_load.csv, Motor_motor_no_load.csv, Motor_motor_no_load_high_speed.csv, Motor_motor_water_load_Short_duration.csv, Motor_motor_water_load_long_duration.csv]
2017-09-27 Multisim-circuits for regulators and driver
    [3V_falling_edge.csv, 3V_rising_edge.csv, 5V_falling_edge.csv, 5V_rising_edge.csv, Motor_battery_no_load_initial.csv, Motor_battery_no_load_initial2.csv, Motor_driver_circuit.ms14, Voltage_regulators.ms14]
2017-09-27 Merged research folders
    [3V_falling_edge.csv, 3V_rising_edge.csv, 5V_falling_edge.csv, 5V_rising_edge.csv, Bat_servo_no_load.csv, Motor_battery_no_load_initial.csv, Motor_battery_no_load_initial2.csv, Motor_motor_no_load.csv]
2017-09-27 Board candidates done
    [Board_candidates.xlsx]
2017-09-28 Servo driver design, motor driver edits
    [Motor_driver_circuit.ms14, Servo driver circuit.ms14]
2017-11-21 Restructured the folder structure, in accordance to "Vejledning til udfærdigelse af projektrapporter 1.2"
    [3V_falling_edge.csv, 3V_rising_edge.csv, 5V_falling_edge.csv, 5V_rising_edge.csv, Bat_servo_no_load.csv, Board_candidates.csv, Board_candidates.xlsx, Motor_battery_no_load_initial.csv]
2017-11-21 Renamed to english, and added more readme
    [3V_falling_edge.csv, 3V_rising_edge.csv, 5V_falling_edge.csv, 5V_rising_edge.csv, Bat_servo_no_load.csv, Board_candidates.csv, Board_candidates.xlsx, Motor_battery_no_load_initial.csv]
2017-11-22 Added pictures from hardware integration
    [regulator_5v_off.csv, regulator_5v_off_2.csv, regulator_5v_on.csv]
2017-11-23 Motor driver integration test
    [motor_controller_no_load_10.csv, motor_controller_no_load_50.csv, motor_controller_no_load_90.csv, motor_controller_overshoot_1.csv, motor_controller_overshoot_2.csv, scope_17.csv]
2017-12-05 Acceptance test result added
    [Accepttest_results.xlsx]
2017-12-12 Raspberry pi hunt was a success
